Mervs111/Line-Follower-Racer/docs/charter.md

# PROJECT CHARTER — Robot Line Tracer Micro

Semester Gasal 2026/2027 · Revisi 3.4 (arahan dosen 05/10/2026: reverse engineering, path planning,
budget maksimal Rp 900.000, dinaikkan menjadi Rp 1.000.000 pada 26/10/2026; arahan 09/10/2026: tanpa IMU; arahan 26/10/2026: path planning dengan peta yang ditentukan di awal) · diperbarui 22/10/2026: 12 QRE1113GR (toko lokal), PCB sensor bentuk jangkar · RAB 27/10/2026: harga hasil validasi marketplace

## 1. Project Identity

| | |
|---|---|
| Nama | Robot Line Tracer Micro |
| Short Description | Robot line tracer edukasi untuk anak sekolah, hasil reverse engineering kit Ichiduino Pro, yang mampu mengikuti garis secara otomatis dan menjalankan path planning dengan peta yang ditentukan di awal (pre-defined map by index). Berbasis ESP32, dapat diprogram dengan block coding berbasis web, dan dibangun dengan anggaran maksimal Rp 1.000.000. |
| Supervisor | Fira Aulia, S.Tr.T, M.Tr.T |

| No | Nama | NRP | Peran |
|---|---|---|---|
| 1 | Mararevi Subagyo | 2040241036 | Project Manager, [isi peran] |
| 2 | Fernandy Raditya Wardhana | 2040241007 | [isi peran] |
| 3 | Achmad Iqbal Adiputra | 2040241121 | [isi peran] |
| 4 | Adhityanoval Dewa Mahendra | 2040241085 | [isi peran] |

Pilihan peran: Firmware, Kendali & Path Planning · Elektronik & PCB · Mekanik & Pengujian ·
Platform Web, RAB & Dokumentasi.

## 2. Business Reasons for Project

Robot line tracer edukasi di pasaran lokal, seperti Ichiduino Pro, dijual sekitar Rp 2.000.000 per kit
lengkap dengan unit kontrol (Ultimate 5 Max) seharga Rp 825.000, dan ditujukan untuk kompetisi.
Harga dan fiturnya (kecepatan tinggi, baterai LiPo 2S) kurang sesuai sebagai media belajar anak sekolah.

Proyek ini melakukan reverse engineering terhadap Ichiduino Pro: fungsi dan arsitekturnya dianalisis,
lalu dirancang ulang dari nol dengan anggaran maksimal Rp 1.000.000. Fitur yang dipertahankan, diganti,
atau ditiadakan dipilih berdasarkan kebutuhan edukasi dan batas anggaran. Selain mengikuti garis,
robot memiliki kemampuan path planning dengan peta yang ditentukan di awal (pre-defined map by index):
rute dituliskan sebagai urutan indeks, dan tiap indeks berisi pola sensor pemicu (misalnya persimpangan
kiri, kanan, atau perempatan), aksi (maju, belok kiri, belok kanan), dan perintah mengikuti garis
berikutnya. Pada lintasan grid, urutan indeks dapat dibuat otomatis dari rute terpendek menuju titik
tujuan, sehingga siswa dapat belajar konsep algoritma dan navigasi melalui block coding berbasis web tanpa
instalasi aplikasi.

## 3. Project Objectives / Purposes

1. Melakukan reverse engineering kit Ichiduino Pro dan merancang ulang robot line tracer edukasi
   berbasis ESP32 dengan anggaran maksimal Rp 1.000.000.
2. Membuat robot yang mampu mengikuti garis hitam di atas putih secara otomatis dengan kendali PID,
   dengan akurasi pembacaan posisi garis ≤ 2 mm dan kecepatan rata-rata ≥ 0,5 m/s.
3. Menerapkan path planning dengan peta yang ditentukan di awal (pre-defined map by index): rute
   dituliskan sebagai urutan indeks; pada tiap indeks robot menunggu pola sensor pemicu, menjalankan aksi
   (maju, belok kiri, belok kanan, berhenti) dengan jarak dan sudut dari encoder, lalu kembali mengikuti
   garis. Pada lintasan grid, urutan indeks dapat dihitung otomatis sebagai rute terpendek menuju titik
   tujuan.
4. Menerapkan fitur keamanan berupa berhenti ≤ 500 ms setelah garis tidak terdeteksi dan pemutusan
   saat tegangan baterai < 3,2 V per sel.
5. Mengembangkan platform block coding berbasis web (Blockly), termasuk blok aksi per indeks dan blok rute
   terpendek menuju titik tujuan.
6. Menguji performa, keterulangan gerak, dan path planning robot, serta melakukan uji coba kepada
   siswa sekolah.

## 4. Project Scope

**Yang dikerjakan:**

- Reverse engineering kit Ichiduino Pro (analisis fungsi, arsitektur, dan spesifikasi)
- Robot line tracer edukasi berbasis ESP32, dirancang dari nol
- Elektronik: 12 sensor garis QRE1113GR (PCB sensor bentuk jangkar) + multiplexer, motor DC + encoder, driver motor, OLED, catu daya baterai 2S (2× 18650)
- Firmware: baca sensor, kalibrasi, kendali PID, deteksi persimpangan, fitur keamanan
- Path planning: peta by index (urutan langkah pola sensor → aksi → ikuti garis) dan pembuatan urutan indeks
  otomatis dari rute terpendek pada lintasan grid
- Platform block coding berbasis web (Blockly)
- Prototipe sampai desain PCB yang siap diproduksi
- Uji performa robot, uji path planning, dan uji coba ke pengguna (anak sekolah)

**Yang TIDAK dikerjakan:**

- Produksi massal dan penjualan (baru rencana bisnis)
- Lintasan selain garis hitam di atas putih
- Rute terpendek otomatis pada lintasan selain grid bersudut 90° (pada lintasan lain, rencana per indeks tetap disusun
  manual lewat blok; garis yang berbelok dan melengkung tetap dapat diikuti)
- Pemetaan lintasan secara otonom (robot menjelajah sendiri); peta ditentukan di awal sesuai arahan dosen
  26/10/2026
- Penghindaran halangan / obstacle avoidance (bukan kebutuhan line tracer)
- Upload program lewat Bluetooth dan dukungan iPad/Safari (jadi pengembangan lanjutan)
- Fitur lomba, seperti kecepatan tinggi dan kipas penyedot
- Modifikasi kit Ichiduino Pro (kit hanya dianalisis dan diukur sebagai pembanding)

## 5. Key Project Deliverables

| Nama | Deskripsi |
|---|---|
| Analisis Reverse Engineering | Tabel analisis fungsi, arsitektur, dan spesifikasi Ichiduino Pro beserta keputusan fitur yang dipertahankan, diganti, atau ditiadakan |
| Prototipe | Robot Line Tracer Micro yang dapat mengikuti garis dan menjalankan path planning |
| Desain PCB | File skematik dan layout PCB (papan utama dan papan sensor) yang siap diproduksi |
| Firmware | Program pembacaan sensor, kendali PID, deteksi persimpangan, path planning, dan fitur keamanan |
| Platform Block Coding | Aplikasi web berbasis Blockly untuk memprogram robot tanpa menulis kode |
| Lintasan Uji | Lintasan garis lurus dan lintasan grid 4 × 4 persimpangan |
| Data Pengujian | Hasil uji seluruh sasaran dan uji coba kepada siswa |
| Dokumentasi | Dokumentasi kegiatan kelompok minggu 4–16 selama proses pengerjaan proyek PJBL |
| Laporan Mingguan | Laporan mingguan berisi aktivitas, perkembangan, dan kendala selama proses PJBL |
| Laporan Akhir & Manual | Laporan menyeluruh mengenai proses, solusi, dan hasil PJBL, beserta manual pengguna |

## 6. Project's Criteria for Success

Lintasan uji path planning berupa grid garis 4 × 4 titik persimpangan dengan jarak antar titik 30 cm.

1. **Akurasi pembacaan posisi garis ≤ 2 mm.** Diuji dengan meletakkan robot dalam keadaan diam (motor mati) pada posisi geser −20 s.d. +20 mm (tiap 5 mm) dari tengah garis, lalu posisi yang terbaca sensor dibandingkan dengan posisi sebenarnya, 3 kali ulangan. Alat ukur: kertas milimeter dan jangka sorong.
2. **Kecepatan rata-rata robot ≥ 0,5 m/s.** Dihitung dari panjang lintasan dibagi waktu tempuh, 3 kali ulangan. Alat ukur: meteran dan stopwatch/video.
3. **Keterulangan waktu tempuh dengan simpangan baku ≤ 5%.** Robot dijalankan 10 putaran pada lintasan dan kondisi baterai yang sama. Alat ukur: stopwatch/timer firmware.
4. **Deteksi persimpangan benar ≥ 95%.** Robot melewati minimal 40 persimpangan, lalu catatan deteksi robot dibandingkan dengan jumlah persimpangan sebenarnya. Alat ukur: log serial dan video.
5. **Path planning dengan peta indeks benar pada 10 dari 10 percobaan.** Diuji pada 10 pasang titik awal dan tujuan yang berbeda; robot harus menjalankan seluruh aksi indeks tanpa salah belok, dan rute yang dihitung otomatis dibandingkan dengan rute terpendek hasil hitung manual. Alat ukur: log serial dan video.
6. **Ketepatan berhenti di titik tujuan dengan error ≤ 30 mm.** Jarak pusat robot ke titik tujuan diukur setelah robot berhenti, pada 10 rute di poin 5. Alat ukur: penggaris/meteran.
7. **Robot berhenti ≤ 500 ms setelah garis tidak terdeteksi.** Garis diputus, lalu waktu dihitung dari rekaman video slow-motion, 3 kali ulangan. Alat ukur: video HP 240 fps.
8. **Motor mati saat tegangan baterai < 3,2 V per sel.** Baterai diganti power supply, lalu tegangan diturunkan perlahan dan dicatat saat motor mati, 3 kali ulangan. Alat ukur: power supply dan multimeter.
9. **Total biaya proyek ≤ Rp 1.000.000.** Dihitung dari jumlah RAB, dan setiap harga disertai tautan toko. Alat ukur: daftar harga.
10. **Seluruh proses dan hasil pengujian terdokumentasi** dalam laporan mingguan dan laporan akhir PJBL.

## 7. Milestone Dates

| No | Milestones / Major Events | Due Dates |
|---|---|---|
| 1 | Lembar telaah, Project Charter, dan sasaran terukur (G1 Penetapan) | Minggu 1–2 |
| 2 | Reverse engineering Ichiduino Pro, WBS, jadwal, RAB, rumusan optimasi | Minggu 3–5 |
| 3 | Rancangan teknis: arsitektur, wiring, flowchart, skematik, algoritma path planning, pustaka (G2 Rancangan) | Minggu 3–6 |
| 4 | Analisis bahaya (≥ 8 mode kegagalan) | Minggu 7–8 |
| 5 | Prototipe mengikuti garis + deteksi persimpangan, data awal 3 ulangan, demo progres (G3 Realisasi Awal) | Minggu 7–10 |
| 6 | Path planning, PCB, platform block coding, pengujian seluruh sasaran, uji coba siswa (G4 Pembuktian) | Minggu 11–14 |
| 7 | Laporan akhir, manual, serah terima, demo akhir (G5 Serah Terima) | Minggu 15–16 |

**Risiko terbesar:** pembacaan sensor garis terganggu cahaya ruangan dan kondisi permukaan lintasan,
sehingga posisi garis dan persimpangan tidak terbaca akurat.

| No | Risiko | Dampak | Penanganan |
|---|---|---|---|
| R1 | Sensor garis terganggu cahaya ruangan / permukaan lintasan | Akurasi posisi dan deteksi persimpangan gagal | Kalibrasi hitam-putih tiap dinyalakan; sensor QRE1113GR (LED IR + fototransistor dalam satu kemasan bersekat) dipasang rendah, muka sensor ±3 mm dari lantai; pelindung cahaya 3D print ditambah kalau uji di ruangan terang gagal |
| R2 | Persimpangan terlewat atau terdeteksi ganda | Rute dan titik berhenti salah | Konfirmasi deteksi dengan jarak tempuh encoder |
| R3 | Belokan 90° di persimpangan tidak presisi | Rute dan titik berhenti salah | Belok berbasis encoder, lalu dikunci kembali ke garis oleh sensor |
| R4 | PID tidak stabil saat kecepatan/tegangan baterai berubah | Kecepatan dan keterulangan gagal | Tuning lewat serial, kompensasi tegangan baterai |
| R5 | PCB salah desain atau terlambat datang | Jadwal G3–G4 mundur | Prototipe breadboard dulu, pesan PCB paling lambat minggu 10 |
| R6 | Biaya melebihi Rp 1.000.000 | Sasaran biaya gagal | RAB dipantau tiap pembelian |
| R7 | Baterai Li-ion overcharge / overdischarge / korsleting | Bahaya keselamatan | BMS 2S, cutoff firmware, ruang baterai tertutup |
| R8 | QRE1113GR mahal (Rp15.000/pcs di toko lokal) sehingga dibeli 12 tanpa cadangan; sensor rusak saat disolder atau barang palsu | Satu titik sensor mati, posisi garis kurang presisi | Cek tanda pin 1 dan uji tiap sensor di breadboard (LED IR dilihat lewat kamera HP) sebelum disolder; kalau ada yang rusak, beli satuan di toko yang sama |

## 8. Budget Summary

Harga dari marketplace online (Shopee/Tokopedia), sudah divalidasi kelompok pada 27/10/2026 (spreadsheet RAB PJBL P01).
Tautan toko ada di bawah tabel. Item tanpa tautan (fabrikasi PCB, komponen pendukung, roda, ball caster, baut, timah)
masih perkiraan. Kit Ichiduino Pro tidak dianggarkan ulang.

### Electrical

| Item | Price per unit | Qty | Unit | Total Price |
|---|---|---|---|---|
| ESP32 DevKit WiFi Bluetooth CH340 Type-C | Rp65.900 | 1 | pcs | Rp65.900 |
| OLED 0.96" 128×64 I2C | Rp36.500 | 1 | pcs | Rp36.500 |
| Sensor reflektif QRE1113GR SMD (tanpa cadangan) | Rp15.000 | 12 | pcs | Rp180.000 |
| IC multiplexer analog CD74HC4067M SOP-24 (SOIC), 16 kanal (dipakai 12), WKH Electronic (tanpa cadangan) | Rp20.000 | 1 | pcs | Rp20.000 |
| Modul driver motor TB6612FNG | Rp50.000 | 1 | pcs | Rp50.000 |
| Motor N20 6V 500 RPM + encoder | Rp55.000 | 2 | pcs | Rp110.000 |
| Push button tactile 12×12 mm | Rp1.000 | 3 | pcs | Rp3.000 |
| Resistor SMD 0805 (220 Ω dan 10 kΩ untuk PCB sensor) | Rp100 | 30 | pcs | Rp3.000 |
| Buzzer aktif 12 × 9,5 mm | Rp3.000 | 1 | pcs | Rp3.000 |
| Baterai Li-ion 18650 3000 mAh (1 paket isi 2) | Rp94.990 | 1 | paket | Rp94.990 |
| Holder baterai 2× 18650 (seri) | Rp8.000 | 1 | pcs | Rp8.000 |
| Modul BMS 2S | Rp10.000 | 1 | pcs | Rp10.000 |
| Modul charger 2S USB-C | Rp25.000 | 1 | pcs | Rp25.000 |
| Modul buck converter 5 V (MP1584) | Rp10.000 | 1 | pcs | Rp10.000 |
| Saklar on/off | Rp3.000 | 1 | pcs | Rp3.000 |
| Konektor JST XH 6 pin + header (motor encoder) | Rp5.000 | 2 | set | Rp10.000 |
| Konektor JST XH 2,5 mm 8 pin (2 header + 2 housing + terminal) + kabel | Rp5.000 | 1 | set | Rp5.000 |
| Fabrikasi PCB (papan utama + papan sensor) + ongkir | Rp200.000 | 1 | paket | Rp200.000 |
| Komponen pendukung minsys (header & socket female, kapasitor, dioda 1N5819, resistor THT) | Rp25.000 | 1 | paket | Rp25.000 |
| **TOTAL** | | | | **Rp862.390** |

### Mechanical

| Item | Price per unit | Qty | Unit | Total Price |
|---|---|---|---|---|
| Roda N20 Ø34 mm | Rp25.000 | 1 | pasang | Rp25.000 |
| Ball caster | Rp10.000 | 1 | pcs | Rp10.000 |
| Baut, mur, spacer | Rp15.000 | 1 | paket | Rp15.000 |
| **TOTAL** | | | | **Rp50.000** |

### Lain-lain

| Item | Price per unit | Qty | Unit | Total Price |
|---|---|---|---|---|
| Timah solder + flux | Rp25.000 | 1 | paket | Rp25.000 |
| **TOTAL** | | | | **Rp25.000** |

**TOTAL BUDGET: Rp937.390** (Electrical Rp862.390 + Mechanical Rp50.000 + Lain-lain Rp25.000), **sisa Rp62.610
dari batas Rp1.000.000** (batas anggaran dinaikkan dari Rp900.000 menjadi Rp1.000.000 pada 26/10/2026). Lintasan uji
disediakan di luar RAB; breadboard + kabel jumper dipinjam dari lab. Revisi 13/10/2026: 16 sensor +
multiplexer + LED indikator (+Rp63.000). Revisi 15/10/2026: sensor jadi 12 TCRT5000, LED IR selalu nyala tanpa MOSFET (−Rp16.500).
Revisi 20/10/2026: sensor jadi 12 pasang LED merah + fototransistor SMD 1206, MCP23017 + LED indikator dihapus
(bacaan sensor tampil di OLED), OLED 0,96", skid nilon pengganti ball caster (−Rp20.000). Revisi kedua 20/10/2026:
sensor jadi 12 QRE1113GR, PCB sensor bentuk sayap gaya JSumo XLINE (+Rp7.500). Revisi 21/10/2026: multiplexer
berupa IC CD74HC4067 SOIC-24 yang disolder langsung di PCB sensor, bukan modul (lebih hemat tempat, +Rp20.000);
tempat cetak sanggup jalur 0,3 mm. Revisi 22/10/2026: PCB sensor bentuk jangkar (rev B); QRE1113GR ternyata ada di
toko lokal dengan harga Rp15.000/pcs (sebelumnya perkiraan impor Rp5.000), jadi dibeli 12 tanpa cadangan
(+Rp105.000); kabel pita IDC diganti konektor JST XH 8 pin (−Rp5.000, perkiraan); breadboard dan timah dipinjam
dari lab (−Rp85.000). Revisi 26/10/2026: IC mux CD74HC4067M SOP-24 dari toko WKH Electronic Rp20.000 (sebelumnya
perkiraan Rp35.000), dibeli 1 tanpa cadangan (−Rp15.000). Revisi 27/10/2026: harga hasil validasi di marketplace
online: ESP32 Rp65.900 (−Rp10.100), OLED Rp36.500 (+Rp3.500), TB6612FNG Rp50.000 (+Rp25.000), baterai 18650 1 paket
isi 2 Rp94.990 (+Rp14.990); push button jadi 3 pcs tactile 12×12 mm (−Rp1.000); resistor THT masuk paket komponen
pendukung (−Rp2.000); bracket motor dihapus karena dudukan motor dibuat 3D print (−Rp10.000); ball caster
menggantikan skid nilon (+Rp5.000); timah solder + flux masuk RAB (+Rp25.000); konektor motor jadi JST XH 6 pin
(harga sama). Total +Rp50.390. Akibatnya footprint tombol dan konektor motor di PCB utama perlu disesuaikan.

### Tautan toko (dicek 27/10/2026)

| Item | Toko | Tautan |
|---|---|---|
| ESP32 DevKit (pilih varian CH340, Type-C, 30 pin) | Shopee | [produk](https://shopee.co.id/ESP32-ESP-32-WROOM-WIFI-Bluetooth-CP2102-CH340-30-38-Pin-BLE-IOT-Develompent-Board-ESP-32S-Micro-USB-Type-C-Solder-i.70136393.57406160712) |
| OLED 0,96" I2C (kuning-biru) | cncstorebandung (Tokopedia) | [produk](https://www.tokopedia.com/cncstorebandung/cnc-yellow-blue-0-96-i2c-128x64-oled-lcd-display-module) |
| QRE1113GR | Shopee | [produk](https://shopee.co.id/product/12793026/28316976609) |
| CD74HC4067M SOP-24 | WKH Electronic (Tokopedia) | menyusul |
| TB6612FNG | Shopee | [produk](https://shopee.co.id/Modul-Driver-Motor-Dual-TB6612FNG-i.116951623.49164769328) |
| Motor N20 + encoder, varian MTR-0239 (6 V 500 RPM; torsi rated 0,2 kg·cm, rasio 30:1) | cncstorebandung (Tokopedia) | [produk](https://www.tokopedia.com/cncstorebandung/motor-dc-jga12-n20-3v-6v-micro-gearbox-high-torque-encoder-untuk-robot-arduino-diy-1731127914696705598) |
| Push button TC-1212T 12×12×5 mm | cncstorebandung (Tokopedia) | [produk](https://www.tokopedia.com/cncstorebandung/cnc-tactile-switch-push-button-tc-1212t-12x12x5-mm-for-arduino-1733707899505378878) |
| Resistor SMD 0805 220 Ω dan 10 kΩ | mikro-automasi (Tokopedia) | [produk](https://www.tokopedia.com/mikro-automasi/resistor-smd-0805-220r-220-dan-10k-10-k-ohm-1-1-8-w-10k-393a6) |
| Buzzer aktif 12 × 9,5 mm | cncstorebandung (Tokopedia) | [produk](https://www.tokopedia.com/cncstorebandung/buzzer-speaker-active-3v-5v-12x9-5mm-modul-alarm-suara-mini-for-arduino-esp32-uno-mega-nano-diy-elektronik-project-17331031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) |
| Baterai 18650 3000 mAh (isi 2) | kanbaigadget (Tokopedia) | [produk](https://www.tokopedia.com/kanbaigadget/smartoools-18650-li-ion-3-7v-3000mah-battery-1-pack-2pcs-1729383030075721073) |
| Holder 2× 18650 | cncstorebandung (Tokopedia) | [produk](https://www.tokopedia.com/cncstorebandung/cnc-tempat-baterai-18650-holder-batteray-18650-case-baterry-18650-2) |
| BMS 2S | supreme (Tokopedia) | [produk](https://www.tokopedia.com/supreme/2s-7-4v-li-ion-lithium-18650-bms-battery-charger-module-8-4v-16a) |
| Charger 2S USB-C | cncstorebandung (Tokopedia) | [produk](https://www.tokopedia.com/cncstorebandung/charger-bms-2s-3s-4s-4a-module-step-up-type-c-input-dc-3-7-6v-bms-2s-3d675) |
| Buck MP1584 | easyware-id (Tokopedia) | [produk](https://www.tokopedia.com/easyware-id/mp1584-3a-dc-dc-step-down-buck-converter-module-adjustable-3-3v-5v-9v-12v-1735712197220599327-1735712260417160735) |
| Saklar on/off | bbelektronik-1 (Tokopedia) | [produk](https://www.tokopedia.com/bbelektronik-1/saklar-on-off-kecil-2-pin-1731781398715729555) |
| JST XH 6 pin (motor) | pcmelektrobik (Tokopedia) | [produk](https://www.tokopedia.com/pcmelektrobik/konektor-xh-6pin-2-54-jst-6-pin-pcb-connector-header-plug-xh2-54mm-6p-1729834630991284132) |
| JST XH 8 pin | s3-satriasecure (Tokopedia) | [produk](https://www.tokopedia.com/s3-satriasecure/molex-mini-8pin-2-54-molek-2-54mm-header-8-pin-jst-xh-2-54-mm-soket-8p-terminal-8p-8-pin-konektor-connector-8-p-kaki-8pin-k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) |

### Alasan pemilihan komponen utama

- **ESP32 DevKit** (Rp65.900): prosesor 240 MHz dual-core dengan WiFi/Bluetooth, jauh lebih murah dari
  ESP32-S3 (> Rp130.000). 12 sensor garis dibaca bergantian lewat multiplexer CD74HC4067 ke satu kanal
  ADC1 (GPIO36), tegangan baterai ke kanal ADC1 lain (GPIO39).
- **12 sensor garis QRE1113GR pada PCB bentuk jangkar (jarak antar sensor 8 mm di busur, lebar baca
  ± 83 mm)**: 6 sensor tengah hampir lurus (posisi presisi dan deteksi persimpangan), lalu lengan melengkung
  ke belakang sampai sensor terluar mundur ± 11,6 mm, sehingga belokan tajam terlihat lebih awal. Jarak 8 mm
  dipilih untuk garis lomba 2 cm (IARC XII): kedua tepi garis bergantian melewati sensor, bacaan posisi halus.
  QRE1113GR berisi LED IR dan
  fototransistor dalam satu kemasan SMD kecil (2,9 × 3,6 mm) yang sudah bersekat, jadi PCB sensor tipis dan
  rendah (muka sensor ± 3 mm dari lantai) seperti kit pembanding, dan tidak perlu menata pasangan LED +
  fototransistor sendiri. Multiplexer membuat 12 sensor cukup memakai 5 pin ESP32 (1 ADC + 4 pemilih kanal). Bacaan 12 sensor
  ditampilkan sebagai bar di OLED, menggantikan LED indikator + MCP23017 (lebih murah dan PCB sensor lebih
  sederhana). Tangkai PCB sensor dibaut ke bawah PCB utama dengan 2 spacer nilon dan disambung kabel JST XH
  8 pin pendek.
- **Motor N20 6V 500 RPM + encoder, roda Ø34 mm**: kecepatan maksimum teoritis ± 0,89 m/s, cukup untuk
  sasaran ≥ 0,5 m/s dengan cadangan; roda kecil membuat robot rendah dan ringkas. Torsi desain
  (massa 0,3 kg, akselerasi 1,8 m/s², safety factor 2) ± 9 N·mm ≈ 0,09 kg·cm per roda. Encoder dibutuhkan
  untuk membaca kecepatan roda (CPMK-1) dan belokan 90° yang presisi untuk path planning: sudut belok
  dihitung dari selisih putaran roda kiri dan kanan, lalu robot dikunci kembali ke garis oleh sensor
  (tanpa IMU, sesuai arahan dosen 09/10/2026). PWM dibatasi ± 70% agar motor 6V tidak kelebihan
  tegangan dari baterai 2S.
- **TB6612FNG**: penurunan tegangan jauh lebih kecil daripada L298N, sehingga motor mendapat tenaga
  penuh dari baterai 2S dan driver tidak panas.
- **Baterai 2× 18650 (2S) + BMS + charger USB-C**: 7,4 V cukup untuk motor dan buck 5 V; kapasitas besar
  (± 3 jam pemakaian), arus maksimum tinggi, dan tidak mungkin tertukar dengan baterai AA; holder dipasang
  melintang di atas PCB utama; dilindungi BMS dan diisi lewat USB-C.

## Persetujuan

Ditandatangani Pengawas PJBL (Fira Aulia, S.Tr.T, M.Tr.T), Manajer Proyek (Mararevi Subagyo), dan
seluruh anggota (Fernandy Raditya Wardhana, Achmad Iqbal Adiputra, Adhityanoval Dewa Mahendra).
