Mervs111/Line-Follower-Racer/mechanical/konsep-v17/konsep-v17.html

# Konsep LFM v17: PCB ringkas + board interface

Sasis diganti skid plate 3D print, jadi PCB utama cukup seukuran modulnya. Board interface (OLED + 5 tombol 6×6) ditumpuk di atasnya, di depan baterai. Motor, roda, baterai di atas poros, dan PCB sensor rev B tidak berubah. Semua gambar to-scale (mm).

Cek otomatis: 0 masalah

Sekarang (v16): PCB utama = sasis, 127 × 100 mm

Usulan (v17): PCB utama trapesium sejajar skid plate, 4 lubang baut M3 di sayap

Usulan (v17): board interface 46 × 32 mm ditumpuk di atas PCB utama

PCB utama board interface komponen pendek di bawah ESP32 zona antena (tanpa tembaga) holder baterai di atas charger di skid plate (di bawah dudukan) skid plate 3D print

## Persegi vs trapesium (trapesium dipilih 03/11)

| Persegi (konsep awal) | Trapesium (dipilih)
Ukuran | 62 × 58 mm | depan 62, belakang 87, panjang 58 mm
Luas PCB | 35,8 cm² | 42,9 cm² (+20%)
Kotak pembungkus (p × l) | 36,0 cm² | 50,2 cm² (+40%)
Total dengan interface | 50,5 cm² (-47% dari v16) | 57,6 cm² (-40% dari v16)

- Kelebihan: garis PCB menyatu dengan skid plate. Sayap kiri-kanan kosong, jadi 4 lubang baut M3 bisa ditaruh jauh dari komponen dan PCB lebih kokoh di skid plate. Masih ada ruang untuk label silkscreen dan titik ukur (test point).
- Kekurangan: luas naik. Kalau tempat cetak menghitung harga dari panjang × lebar, yang dihitung kotak pembungkusnya, jadi kenaikannya lebih besar. Sayap kiri ada di bawah colokan USB ESP32, jadi komponen di sana harus pendek.
- Tidak berubah: isi PCB, board interface, jarak ke ban (sudut belakang 7 mm di depan ban), cek tabrakan tetap 0.

Tampak samping v17 (dari kiri, depan ke kanan). Tinggi OLED ±46 mm, sejajar atas holder baterai.

## Angka

| v16 | Usulan v17
PCB utama | 127 × 100 mm, 95,3 cm² | trapesium depan 62, belakang 87, panjang 58 mm, 42,9 cm²
Board interface | tidak ada | 46 × 32 mm, 14,6 cm²
Total PCB utama + interface | 95,3 cm² | 57,6 cm² (-40%)
PCB sensor | 20,7 cm² | tetap
Sasis | PCB utama | skid plate 3D print trapesium: depan 62 mm, belakang 115 mm, coakan roda
Ban | Ø34 × 12 mm di model (roda Ø34 N20 di toko umumnya 6,5–7 mm) | Ø34 × 18 mm, melebar ke luar
Lebar robot / jarak tengah ban | 103 mm / 91 mm | 115 mm / 97 mm (batas lomba 200 mm)
Tombol | 2 × 12×12 mm (GPIO34, GPIO35) | 5 × 6×6 mm, resistor ladder di GPIO34 (GPIO35 bebas)
Charger 2S + BMS | di PCB utama bagian belakang | charger di skid plate (di bawah dudukan baterai), BMS ditempel di holder

## Susunan

- PCB utama trapesium, sisi sejajar skid plate, 4 lubang M3 di sayap: belakang J2, J1 baterai, J3, R1/R2, D1; tengah ESP32 DevKit melintang di socket (USB ke kiri, antena ke kanan); depan MP1584, C1, buzzer, SW1 (tuas ke kanan), header J6 ke board interface, J5 ke PCB sensor (kabel lurus ke depan).
- Ban lebih lebar (18 mm, melebar ke luar karena sisi dalam ada motor): kecepatan maksimum tetap, karena ditentukan RPM × diameter. Grip naik, jadi akselerasi dan pengereman lebih jarang selip. Jarak tengah ban naik 91 → 97 mm (lebih stabil, PID perlu dituning ulang). Skid plate berbentuk trapesium: sisi lurus dari hidung (62 mm) melebar ke belakang sampai sisi luar ban (115 mm), dengan coakan roda (celah ke ban ±4 mm). Ban menonjol keluar dari garis miring seperti mobil balap.
- Ball caster pindah ke skid plate tepat di belakang PCB sensor (y ±72 mm dari poros). Di v16 caster masih di baut PCB sensor dan bertabrakan dengan PCB sensor (celah ke lantai cuma 4,8 mm).
- Di bawah ESP32 (celah socket 8,5 mm): TB6612 disolder rendah tanpa socket (disetujui 03/11), Q1 + R3/R4 buzzer.
- Board interface: OLED di socket di tengah, 5 tombol 6×6 mengapit untuk menu OLED (kiri ▲ ▼ pindah pilihan, kanan ◀ kembali, OK, ▶ lanjut/ubah nilai), resistor ladder di bawah OLED. Ke PCB utama lewat J6 6 pin: 3V3, GND, SDA, SCL, tombol (GPIO34), cadangan.
- Charger 2S pindah ke skid plate di belakang motor, di bawah dudukan baterai, USB-C menghadap ke belakang. BMS (tanpa konektor) ditempel di holder baterai. Keduanya tidak lagi di PCB.

## Perlu dicek / diputuskan

1. Sisi bawah ESP32 DevKit yang dibeli: kalau ada chip (CH340 di bawah), celah untuk TB6612 tinggal ±1 mm.
2. Ukuran modul charger 2S yang dibeli: konsep memakai 25 × 16 mm dengan USB-C di sisi panjang (seperti model v16).
3. Harga cetak: 3 desain PCB (sensor, utama, interface); tanya apakah bisa digabung satu panel.
4. Roda velg 3D print Ø34 × 18 mm (dipilih 03/11; roda N20 Ø34 di toko hanya 6,5–7 mm): bahan ban (TPU, silikon cetak, atau karet) dan apakah printer lab bisa mencetak TPU.

## Hasil cek otomatis (kotak 3D tiap komponen)

- 0 tabrakan antar komponen, semua komponen di dalam outline, jalur USB dan zona antena kosong.
