Mervs111/Line-Follower-Racer/mechanical/v16/dxf/pcb_sensor_posisi_qre1113.csv

no | x_mm | y_mm_dari_tepi_depan | putar_deg_kicad
1 | -41.39 | 16.28 | -140.0
2 | -35.26 | 11.14 | -147.5
3 | -28.01 | 7.76 | -161.5
4 | -20.19 | 6.09 | -171.5
5 | -12.22 | 5.40 | -175.0
6 | -4.25 | 4.70 | -177.5
7 | 4.25 | 4.70 | +177.5
8 | 12.22 | 5.40 | +175.0
9 | 20.19 | 6.09 | +171.5
10 | 28.01 | 7.76 | +161.5
11 | 35.26 | 11.14 | +147.5
12 | 41.39 | 16.28 | +140.0
