Mervs111/Line-Follower-Racer/mechanical/v15/dxf/pcb_sensor_posisi_qre1113.csv

no | x_mm | y_mm | putar_deg_dilihat_dari_atas
1 | -45.88 | 19.50 | +30
2 | -38.09 | 15.00 | +30
3 | -30.29 | 10.50 | +30
4 | -22.50 | 6.00 | +15
5 | -13.50 | 6.00 | +0
6 | -4.50 | 6.00 | +0
7 | 4.50 | 6.00 | +0
8 | 13.50 | 6.00 | +0
9 | 22.50 | 6.00 | -15
10 | 30.29 | 10.50 | -30
11 | 38.09 | 15.00 | -30
12 | 45.88 | 19.50 | -30
