Mervs111/Line-Follower-Racer/arsip/hardware/render/pcb-sensor-atas-bawah.png

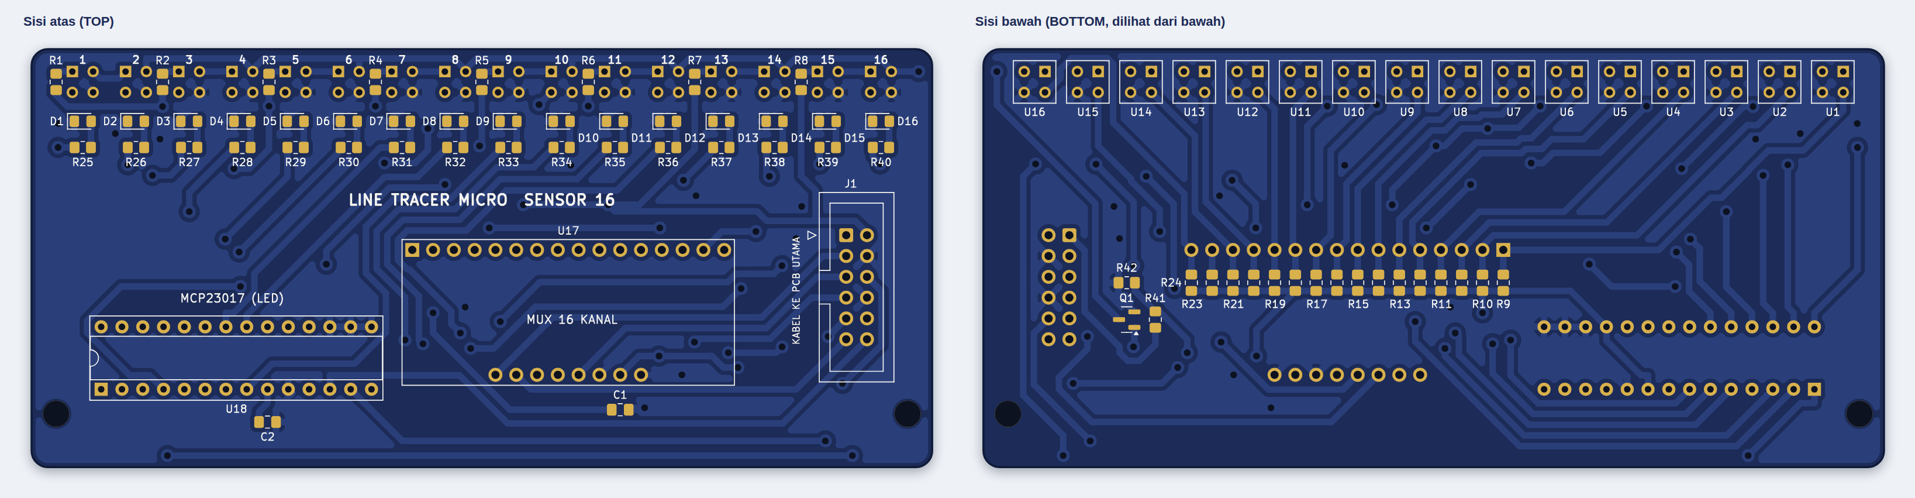
arsip/hardware/render/pcb-sensor-atas-bawah.png
