Mervs111/Line-Follower-Racer/arsip/mechanical/konsep-ringkas.png

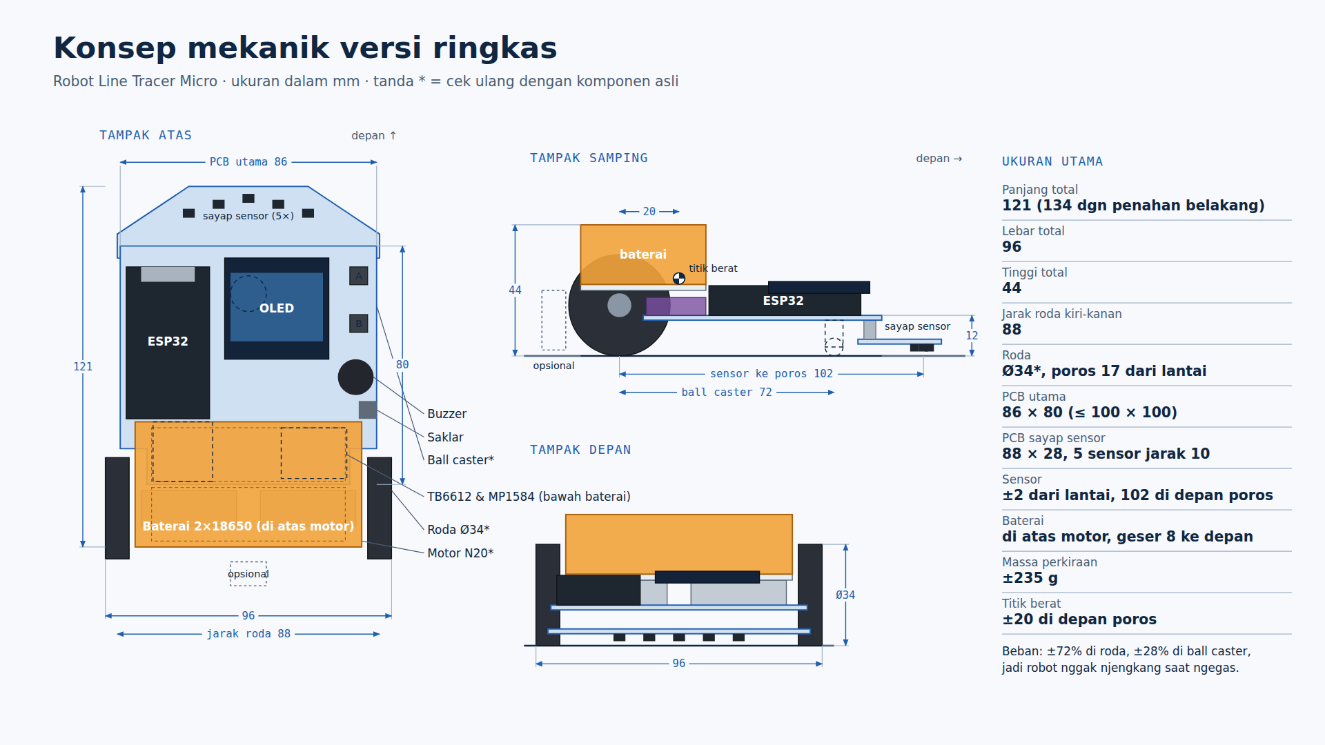
arsip/mechanical/konsep-ringkas.png
