Mervs111/Line-Follower-Racer/arsip/mechanical/render/ltm-v11-iso-nocover.png

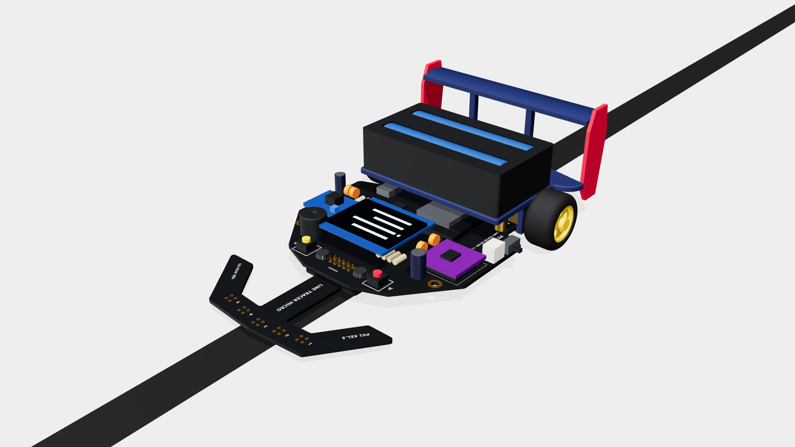
arsip/mechanical/render/ltm-v11-iso-nocover.png
