Mervs111/Line-Follower-Racer/arsip/mechanical/render/ltm-v11-rear.png

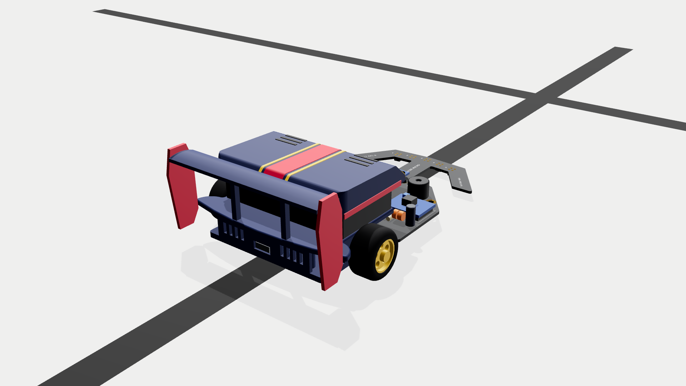
arsip/mechanical/render/ltm-v11-rear.png
