Mervs111/Line-Follower-Racer/arsip/mechanical/render/ltm-v11-top.png

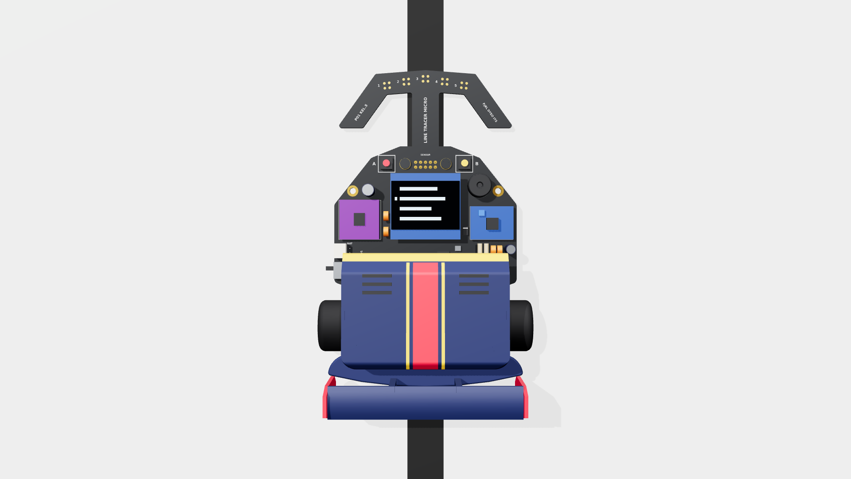
arsip/mechanical/render/ltm-v11-top.png
