Mervs111/Line-Follower-Racer/arsip/mechanical/render/ltm-v12-iso-nocover.png

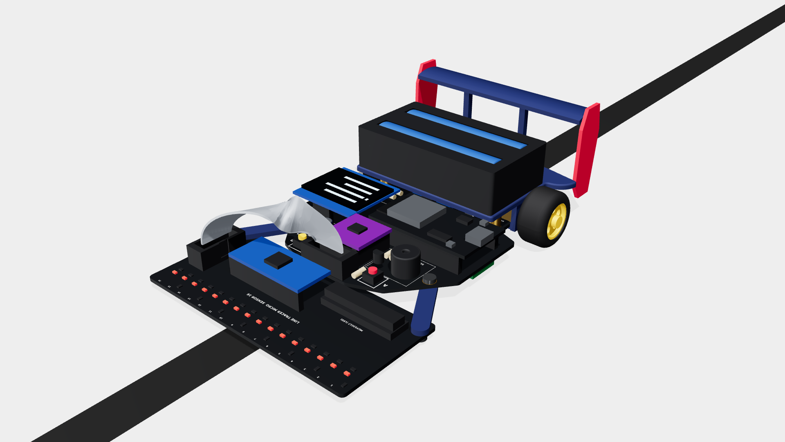
arsip/mechanical/render/ltm-v12-iso-nocover.png
