Mervs111/Line-Follower-Racer/arsip/mechanical/render/ltm-v13-banding-ichiduino.png

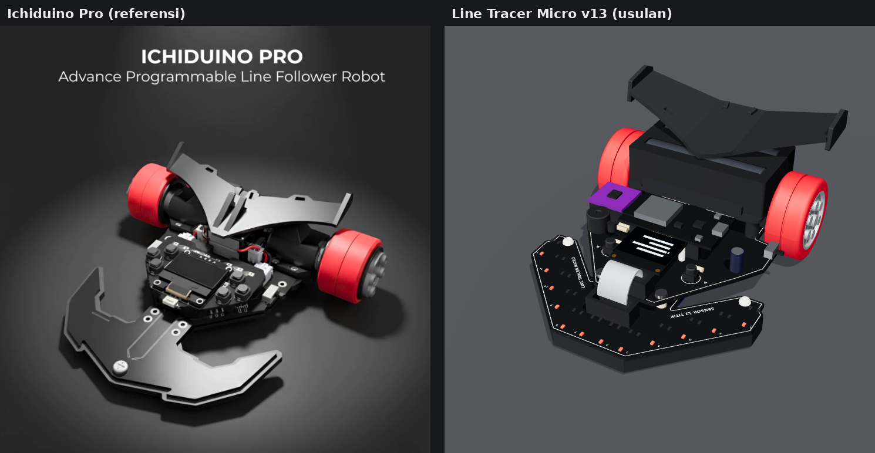
arsip/mechanical/render/ltm-v13-banding-ichiduino.png
