Mervs111/Line-Follower-Racer/arsip/mechanical/render/ltm-v13-bawah.png

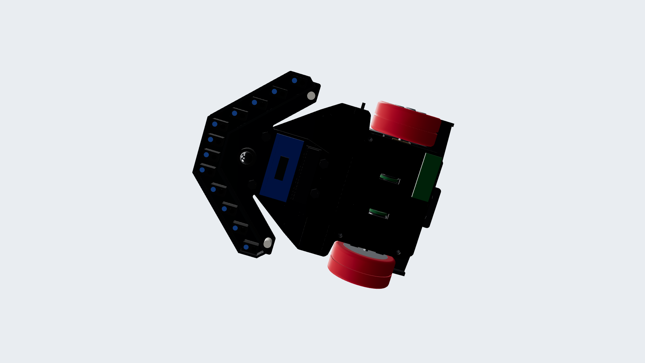
arsip/mechanical/render/ltm-v13-bawah.png
