Mervs111/Line-Follower-Racer/arsip/mechanical/render/ltm-v13-belakang.png

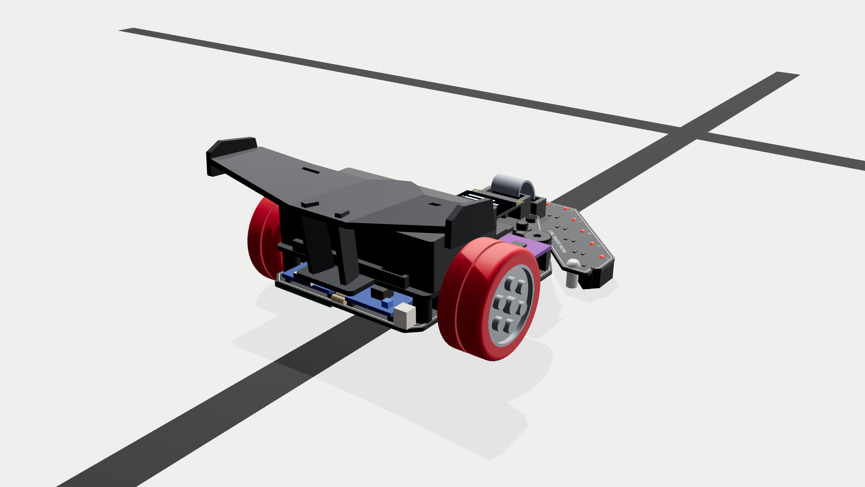
arsip/mechanical/render/ltm-v13-belakang.png
