Mervs111/Line-Follower-Racer/arsip/mechanical/render/ltm-v13-depan.png

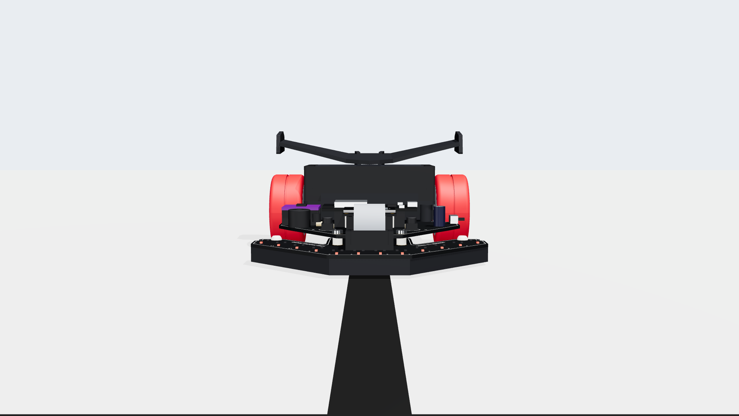
arsip/mechanical/render/ltm-v13-depan.png
