Mervs111/Line-Follower-Racer/arsip/mechanical/render/ltm-v13-iso-tanpa-pelindung.png

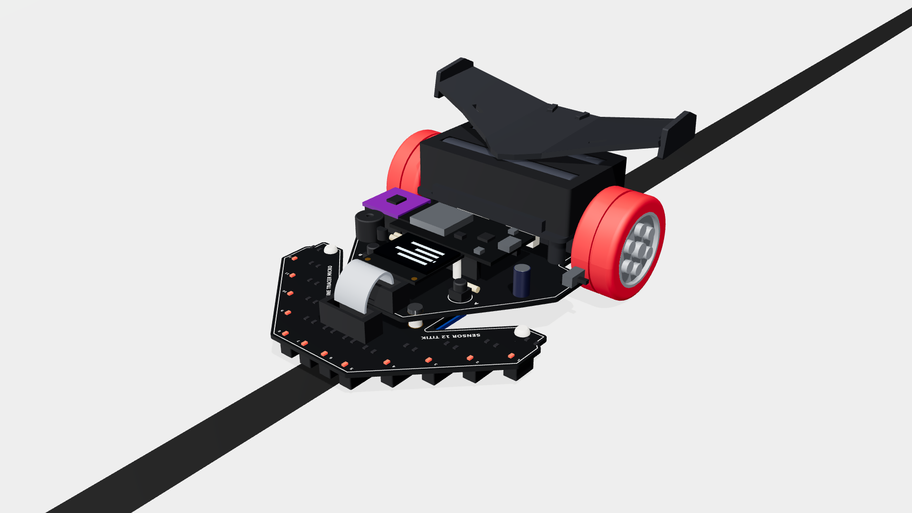
arsip/mechanical/render/ltm-v13-iso-tanpa-pelindung.png
