Mervs111/Line-Follower-Racer/docs/diagram-blok-kendali.png

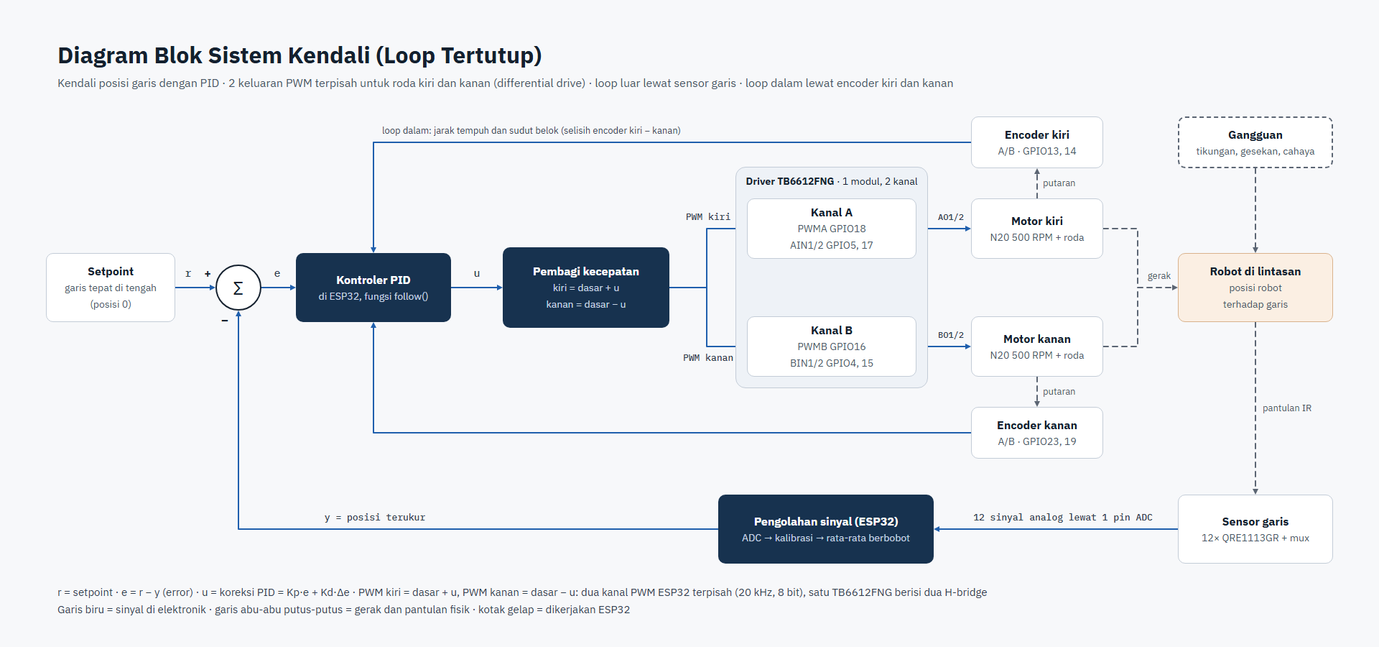
docs/diagram-blok-kendali.png
