Mervs111/Line-Follower-Racer/docs/diagram-blok.png

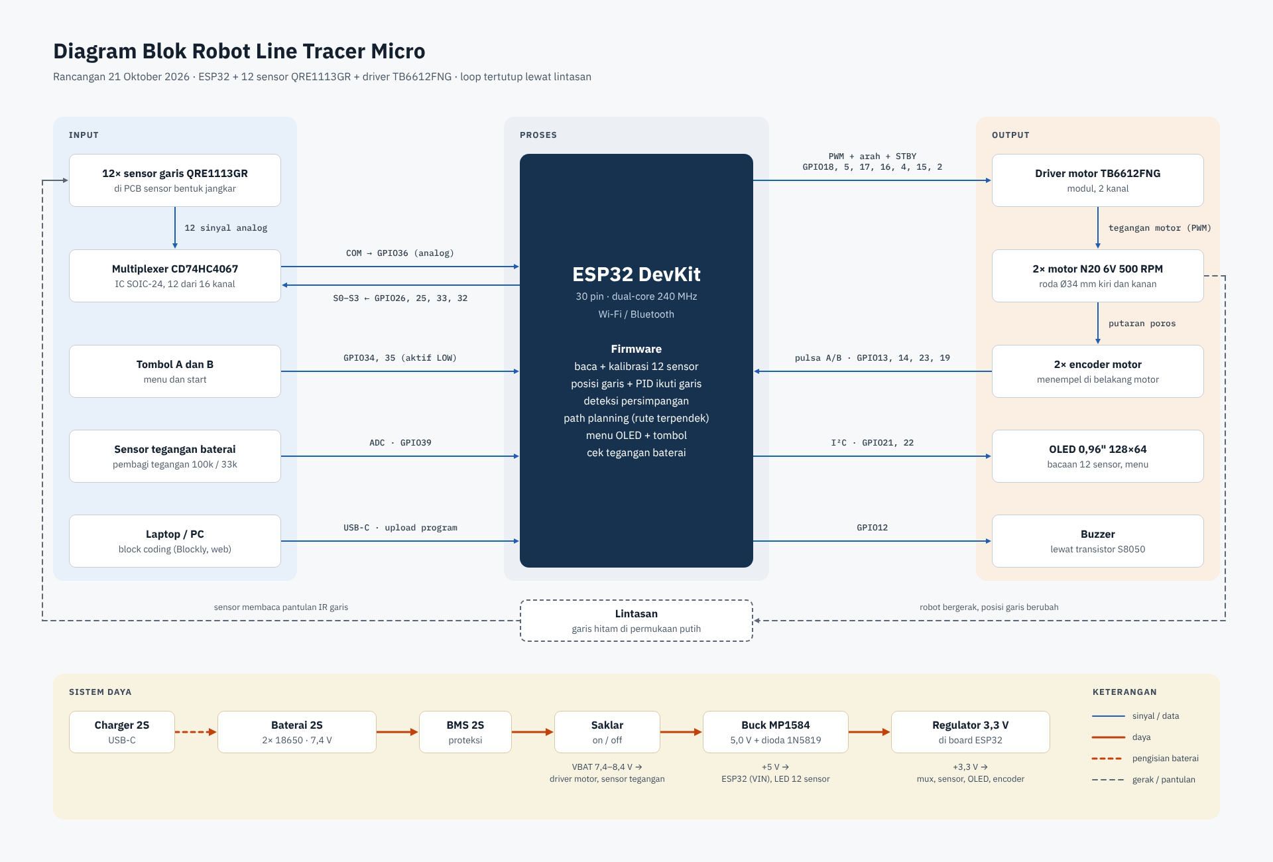
docs/diagram-blok.png
