Mervs111/Line-Follower-Racer/docs/pitching-rab/gambar/pcb-sensor-atas.png

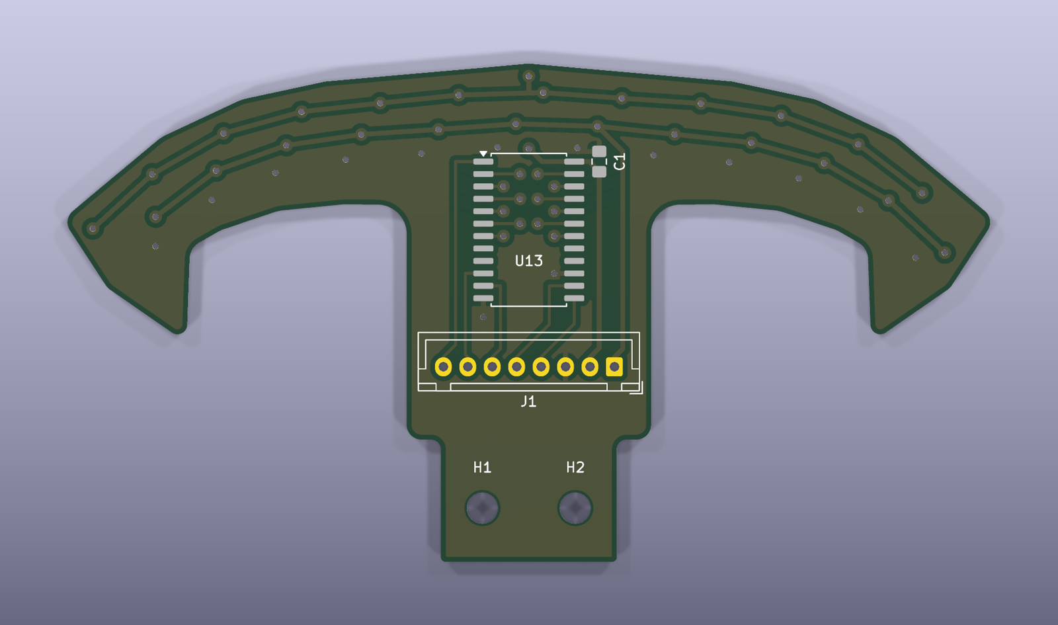
docs/pitching-rab/gambar/pcb-sensor-atas.png
