Mervs111/Line-Follower-Racer/docs/pitching-rab/gambar/pcb-utama-atas.png

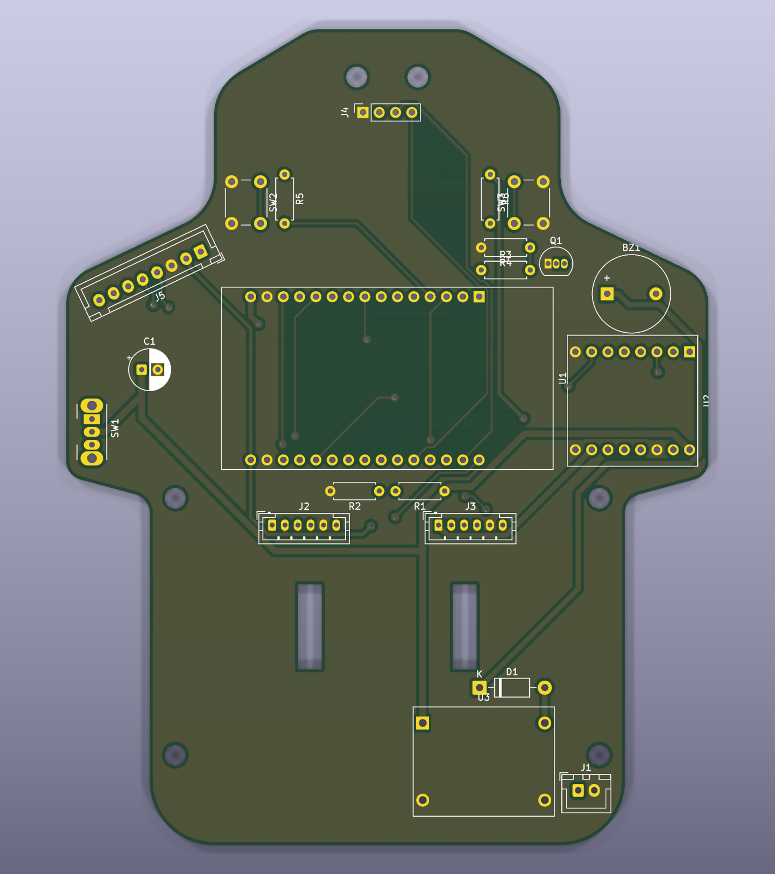
docs/pitching-rab/gambar/pcb-utama-atas.png
