Mervs111/Line-Follower-Racer/docs/pitching-rab/gambar/pcb-utama-iso.png

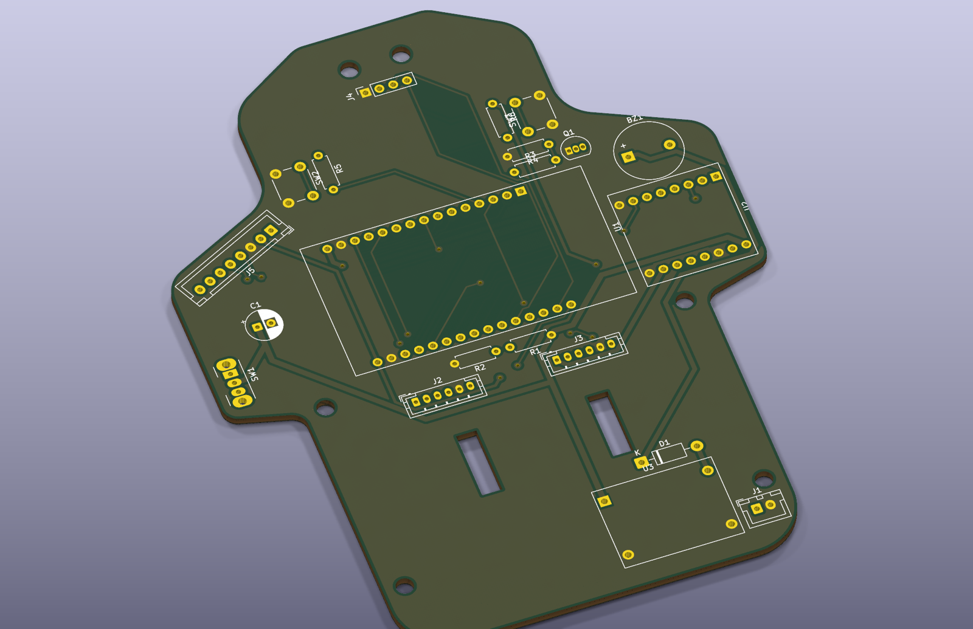
docs/pitching-rab/gambar/pcb-utama-iso.png
