Mervs111/Line-Follower-Racer/hardware/board-interface/render-atas.png

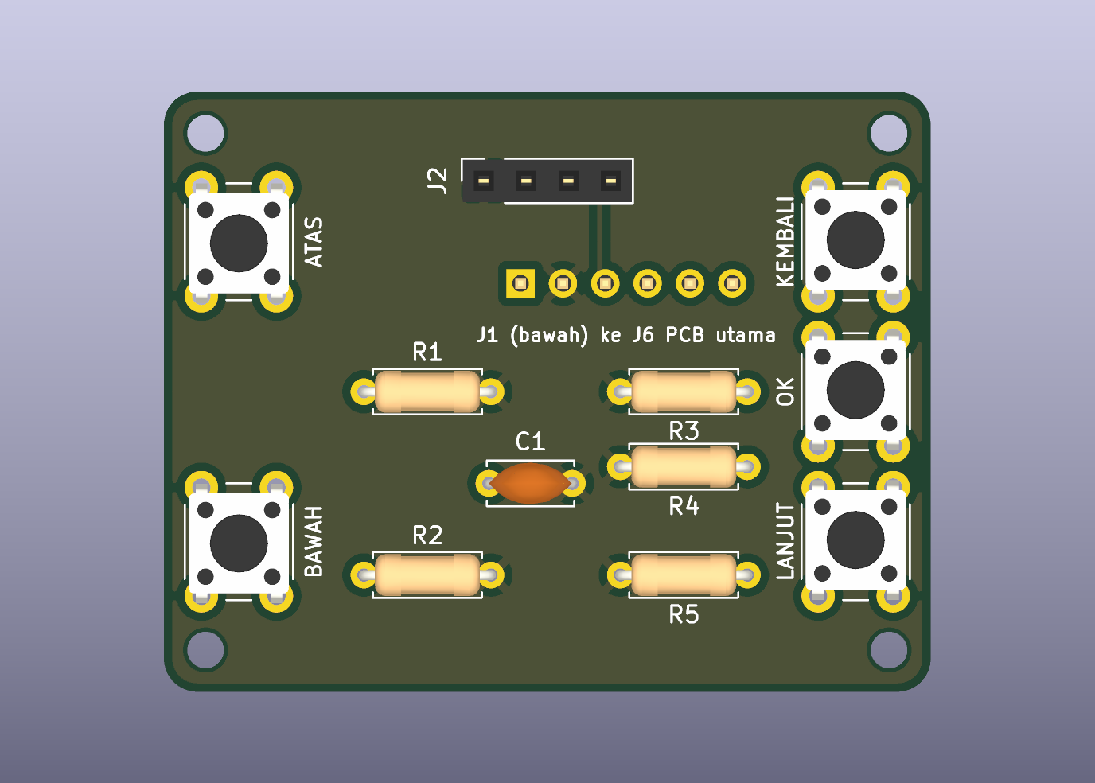
hardware/board-interface/render-atas.png
