Mervs111/Line-Follower-Racer/hardware/board-interface/render-bawah.png

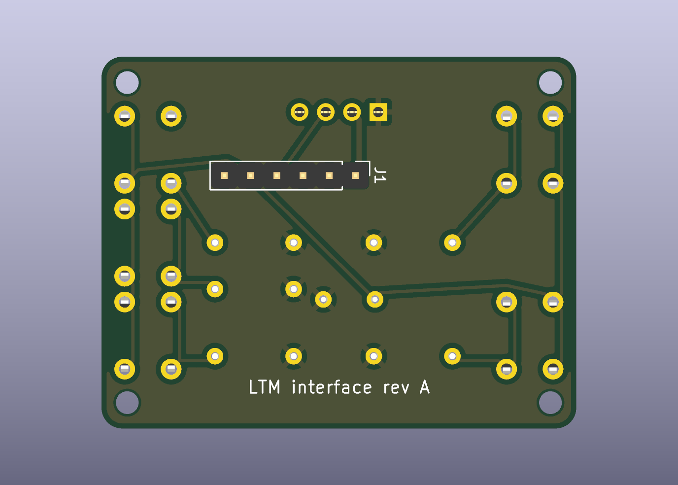
hardware/board-interface/render-bawah.png
