Mervs111/Line-Follower-Racer/hardware/outline/pcb_sensor_outline_simetris.png

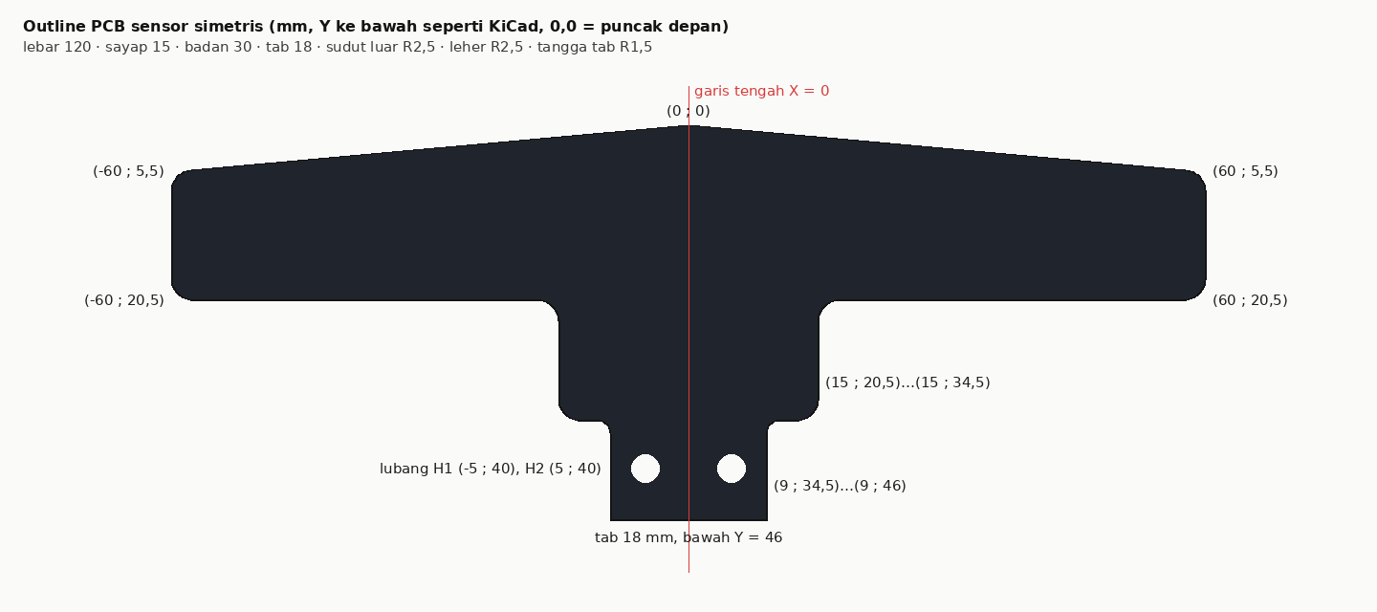
hardware/outline/pcb_sensor_outline_simetris.png
