Mervs111/Line-Follower-Racer/hardware/pcb-utama/render-atas.png

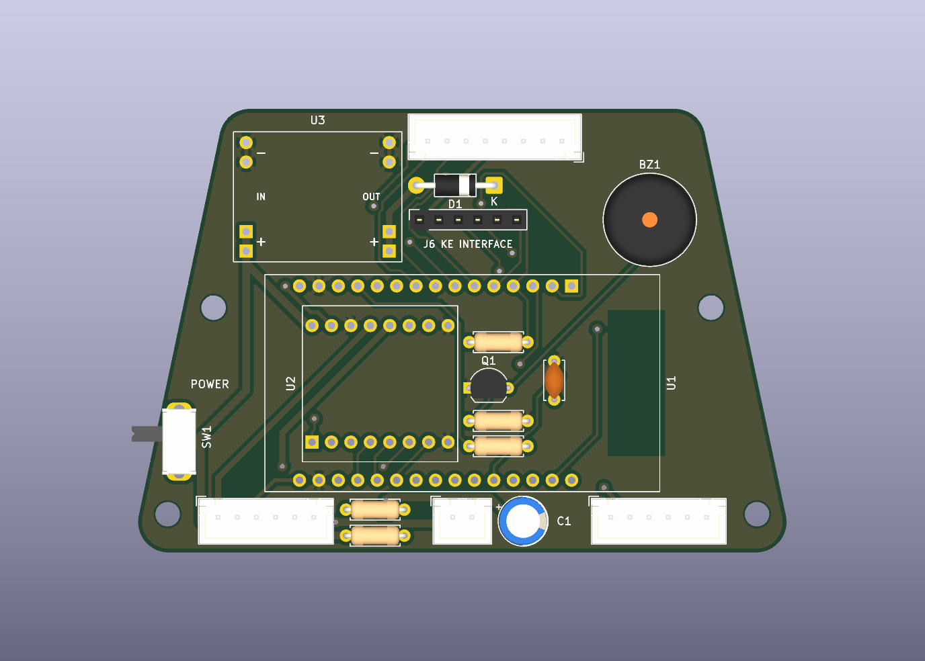
hardware/pcb-utama/render-atas.png
