Mervs111/Line-Follower-Racer/hardware/pcb-utama/render-bawah.png

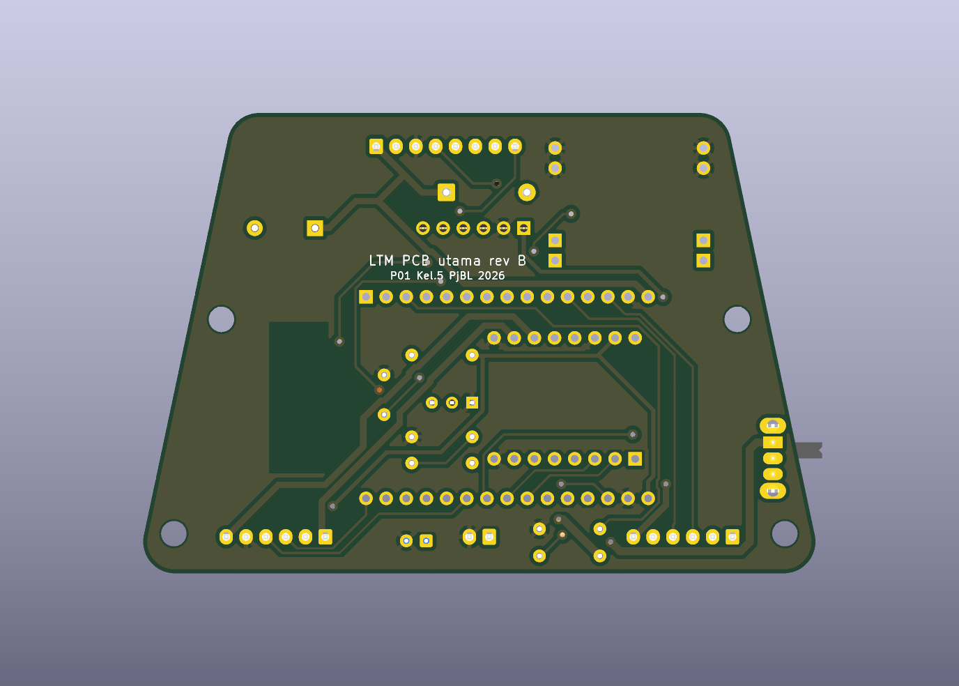
hardware/pcb-utama/render-bawah.png
