Mervs111/Line-Follower-Racer/hardware/render/pcb-rakitan-tampak-atas.png

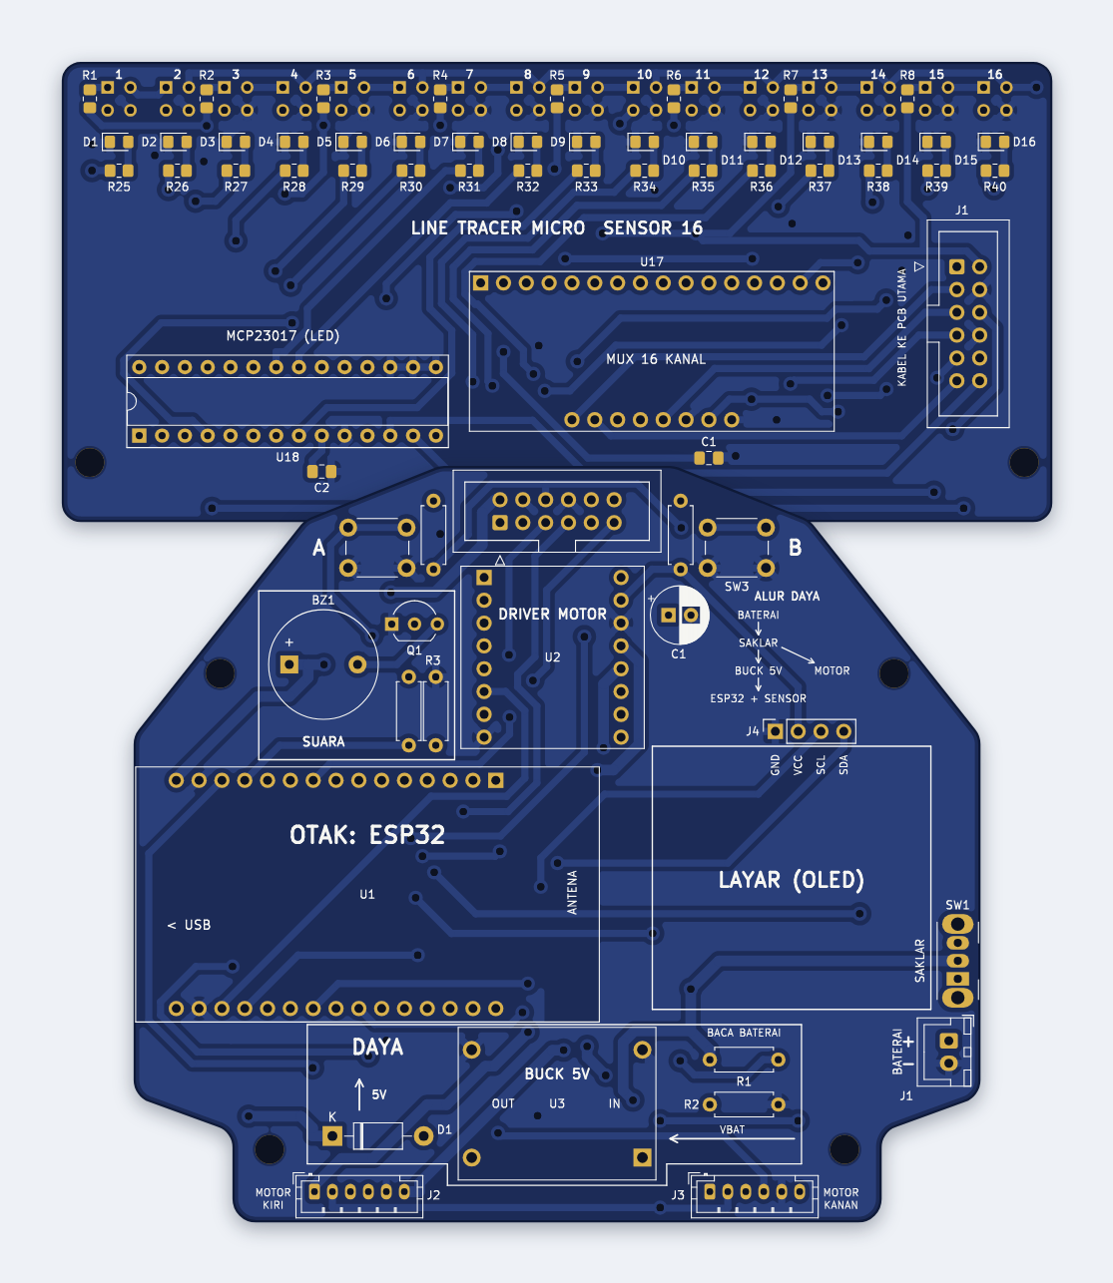
hardware/render/pcb-rakitan-tampak-atas.png
