Mervs111/Line-Follower-Racer/hardware/render/pcb-utama-atas-bawah.png

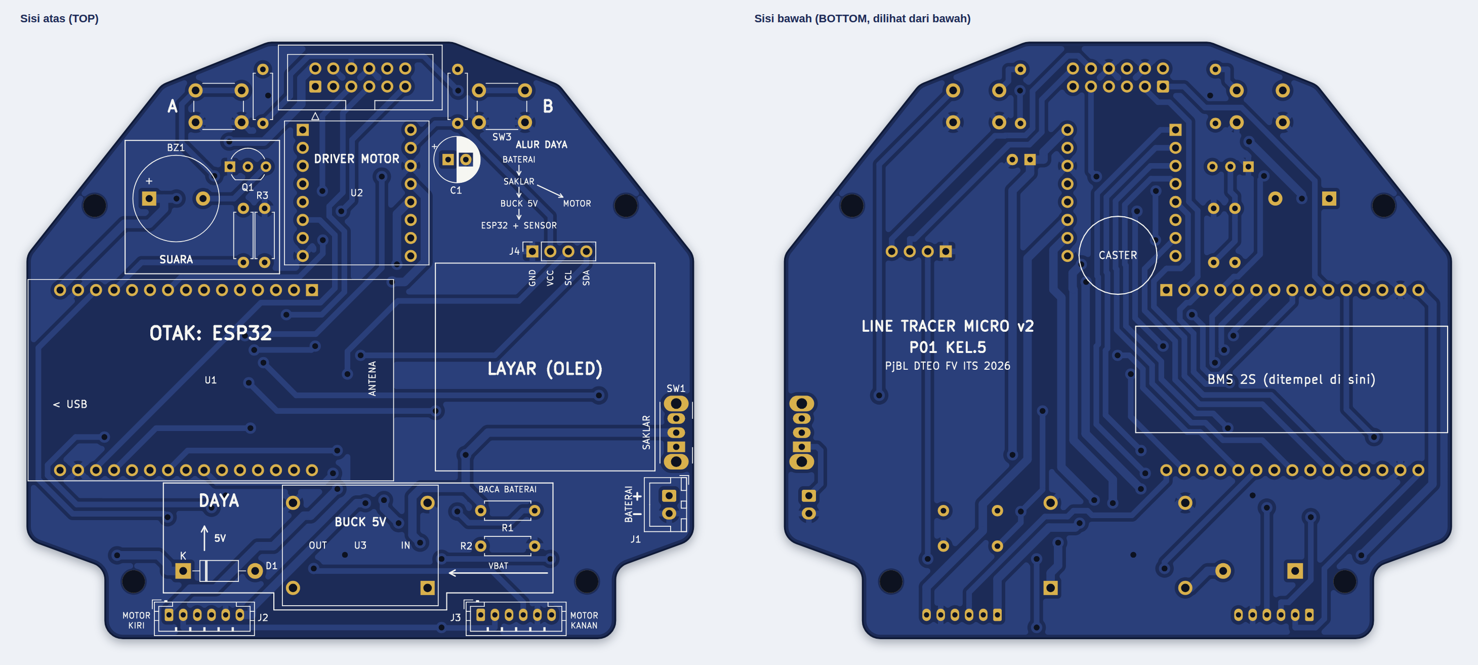
hardware/render/pcb-utama-atas-bawah.png
