Mervs111/Line-Follower-Racer/hardware/sensor-garis/revisi/rev-b/rev-b-3d-bawah.png

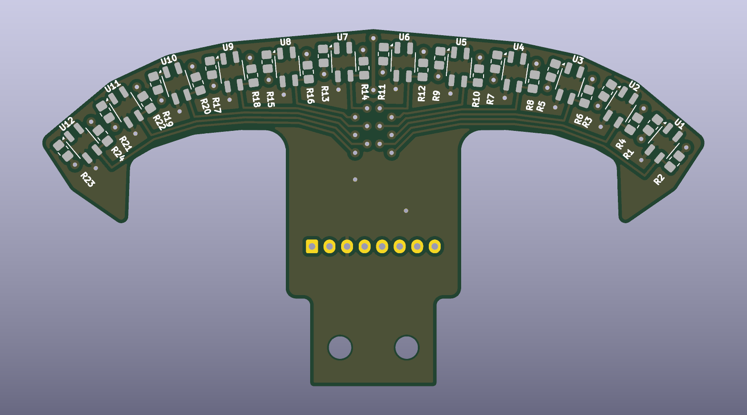
hardware/sensor-garis/revisi/rev-b/rev-b-3d-bawah.png
