Mervs111/Line-Follower-Racer/mechanical/render/ltm-v15-banding-xline.png

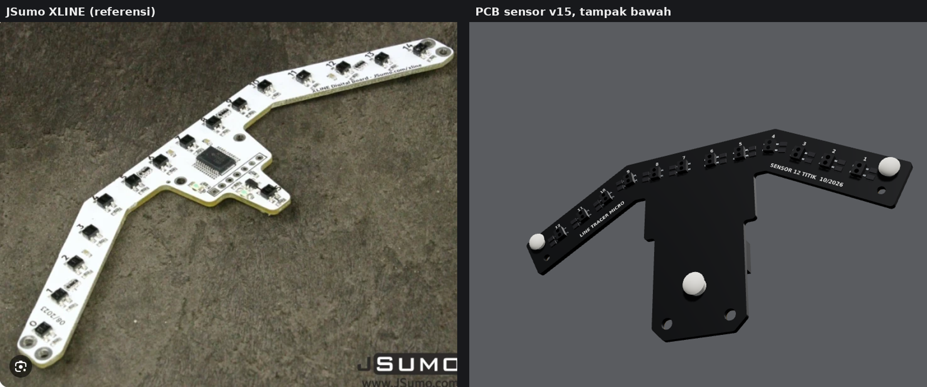
mechanical/render/ltm-v15-banding-xline.png
