Mervs111/Line-Follower-Racer/mechanical/render/ltm-v15-bawah.png

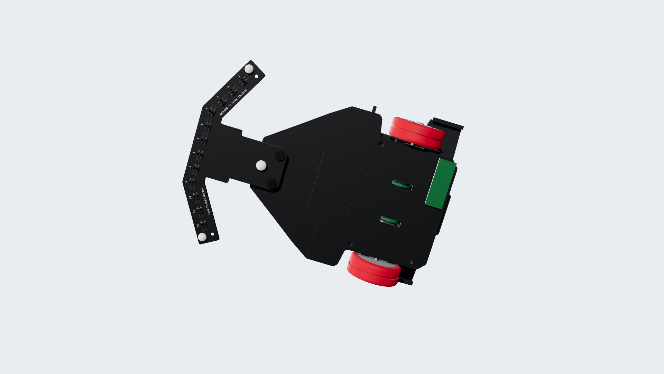
mechanical/render/ltm-v15-bawah.png
