Mervs111/Line-Follower-Racer/mechanical/render/ltm-v15-pcb-sensor-bawah.png

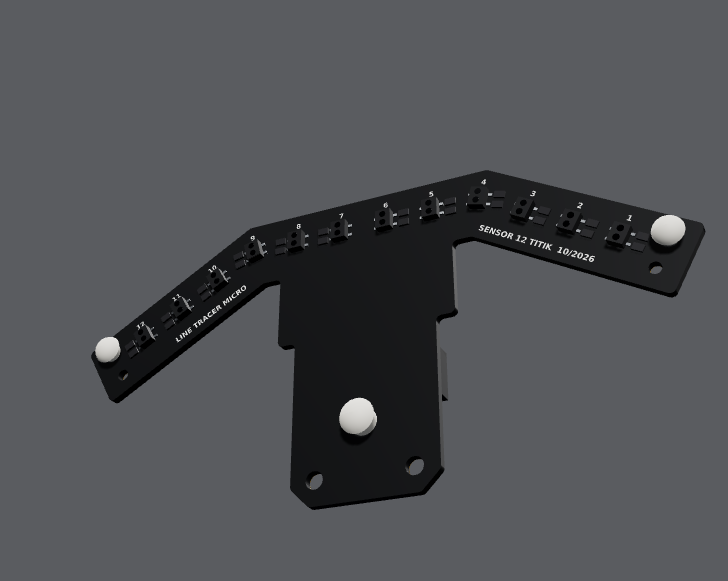
mechanical/render/ltm-v15-pcb-sensor-bawah.png
