Mervs111/Line-Follower-Racer/mechanical/render/ltm-v16-bawah.png

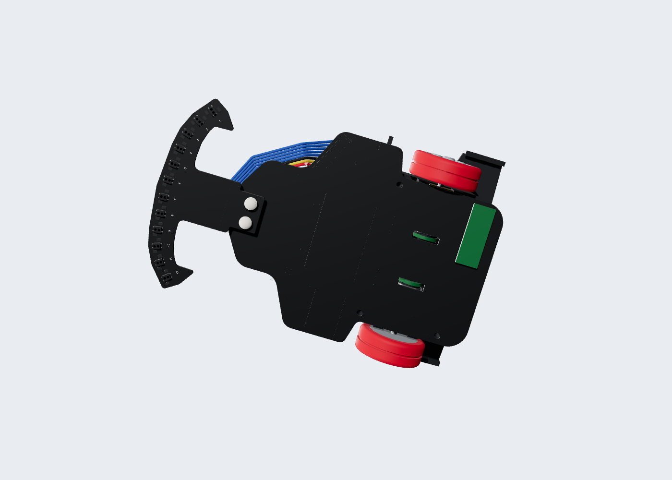
mechanical/render/ltm-v16-bawah.png
