Mervs111/Line-Follower-Racer/mechanical/render/ltm-v16-depan.png

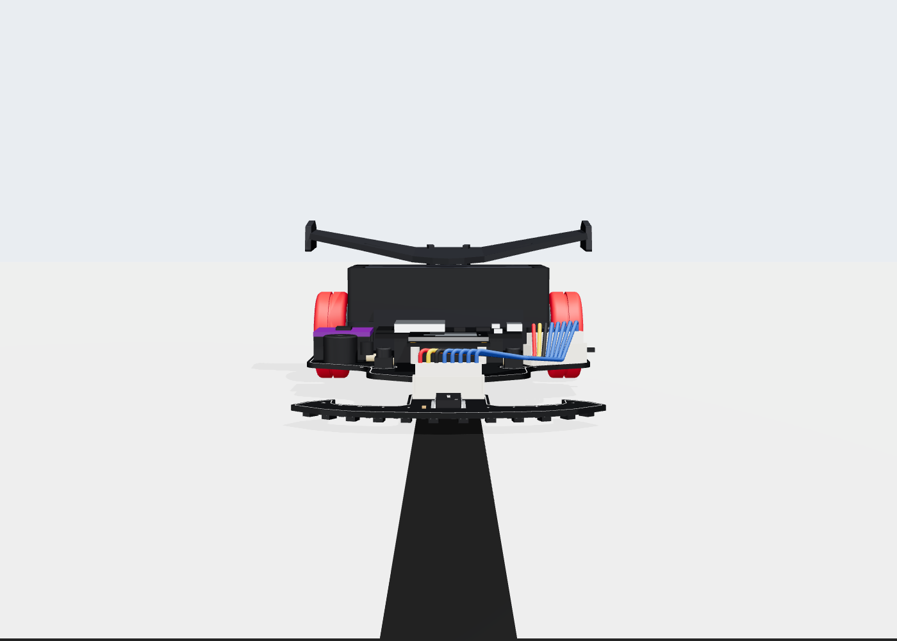
mechanical/render/ltm-v16-depan.png
