Mervs111/Line-Follower-Racer/simulasi/hasil/cek_kamera.png

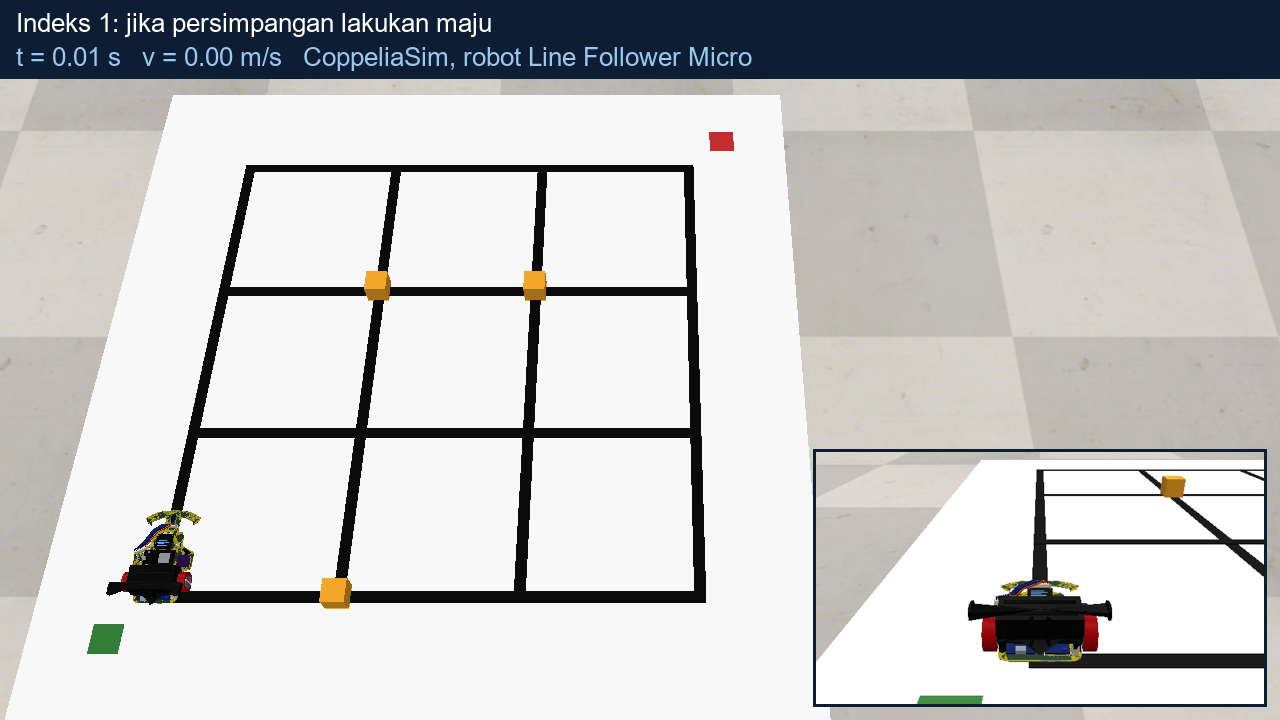
simulasi/hasil/cek_kamera.png
