Mervs111/Line-Follower-Racer/simulasi/hasil/coppeliasim_jendela.png

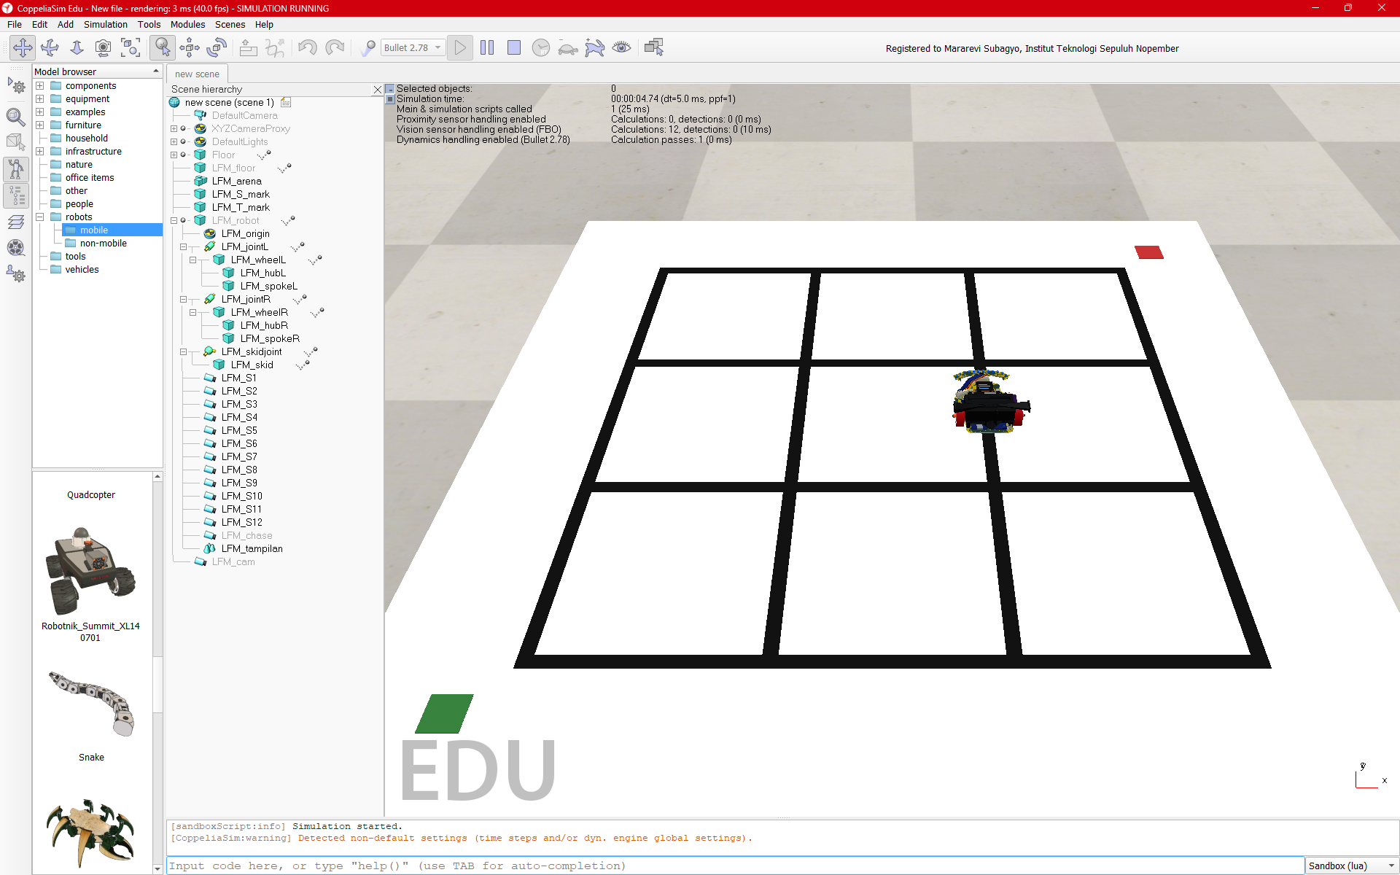
simulasi/hasil/coppeliasim_jendela.png
