Mervs111/Line-Follower-Racer/simulasi/hasil/uji2d_bfs.png

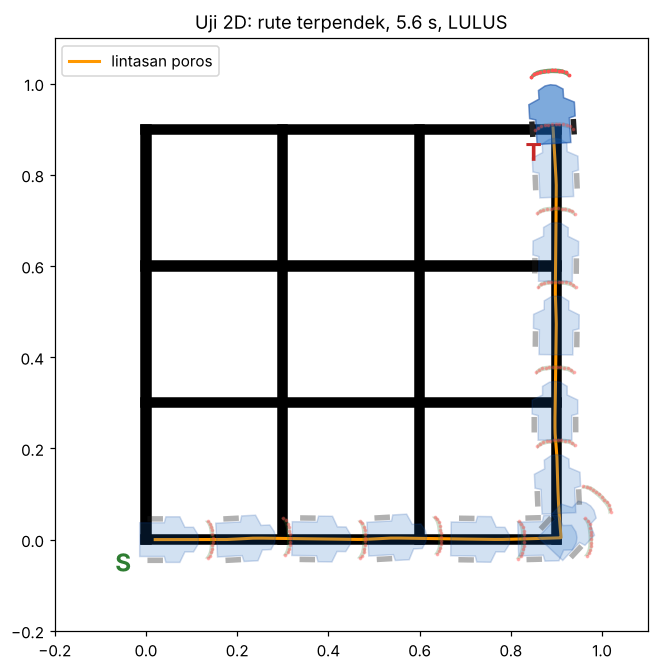
simulasi/hasil/uji2d_bfs.png
