Mervs111/Line-Follower-Racer/simulasi/hasil/uji2d_bfs_halangan.png

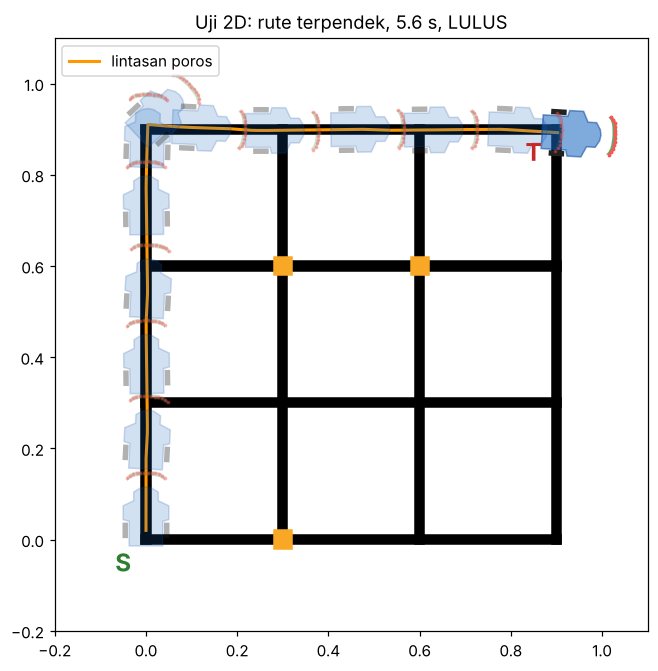
simulasi/hasil/uji2d_bfs_halangan.png
