Mervs111/Line-Follower-Racer/docs/RAB_Pemeliharaan_5_Tahun_LTM.xlsx

Sheet: Ringkasan
RENCANA ANGGARAN BIAYA (RAB) CAPEX & OPEX PEMELIHARAAN - 5 TAHUN
Sistem: armada AGV mini line tracer, 5 unit (4 beroperasi + 1 cadangan), hasil PjBL P01 Kelompok 5
Disusun oleh: Unit Maintenance | Diajukan kepada: Kepala Plant & Bagian Keuangan | Tugas Merancang RAB - Teknik Perawatan dan Perbaikan (B)
Harga dalam Rupiah. Angka tahun 2-5 sudah termasuk eskalasi harga. Detail perhitungan di sheet Asumsi, Jadwal PM, Suku Cadang, CAPEX, dan OPEX.
No | Pos anggaran | Tahun 1 | Tahun 2 | Tahun 3 | Tahun 4 | Tahun 5 | Total 5 tahun | % dari total
 | Tahun anggaran
A | CAPEX (pengadaan alat & stok awal)
A.1 | Peralatan kerja & alat ukur
A.2 | Infrastruktur perawatan
A.3 | Stok awal suku cadang kritis
A.4 | Pelatihan & dokumentasi awal
 | Subtotal CAPEX
B | OPEX (biaya pemeliharaan rutin)
B.1 | Suku cadang penggantian
B.2 | Bahan habis pakai
B.3 | Tenaga kerja pemeliharaan
B.4 | Kalibrasi alat ukur
B.5 | Pelatihan penyegaran
B.6 | Listrik pengisian baterai
B.7 | Kontingensi (persentase di sheet Asumsi)
 | Subtotal OPEX
 | TOTAL RAB (CAPEX + OPEX)
 | Kesesuaian dengan pagu
 | Pagu anggaran 5 tahun
 | Total RAB 5 tahun
 | Sisa pagu
 | Persentase pagu terpakai
 | Status
 | Indikator pemeliharaan
 | Rata-rata biaya pemeliharaan per robot per tahun (Rp)
 | Rata-rata biaya pemeliharaan per jam jalan robot (Rp/jam)
 | Jam teknisi preventif per tahun
 | Jam teknisi penggantian komponen per tahun
 | Porsi jam preventif dari total jam teknisi
 | Jumlah penggantian komponen per tahun (kejadian)
 | Biaya teknisi per jam (Rp)
 | Catatan
 | 1. Harga robot tidak termasuk: robot sudah terpasang dan beroperasi; RAB ini hanya biaya pemeliharaannya.
 | 2. CAPEX dibeli di tahun 1. Stok awal suku cadang kritis disimpan supaya robot rusak bisa langsung diperbaiki.
 | 3. Kebutuhan suku cadang dihitung dari jam jalan (motor, ban, caster), siklus baterai, dan laju kerusakan modul.
 | 4. Strategi: preventif terjadwal (sheet Jadwal PM) + penggantian berbasis kondisi dari hasil ukur baterai & RPM.
 | 5. Ubah asumsi di sheet Asumsi (sel kuning) bila data riwayat tahun pertama menunjukkan angka berbeda.

Sheet: Asumsi
Asumsi & Parameter Perhitungan
Sel biru berlatar kuning = asumsi yang boleh diubah. Semua angka di sheet lain dihitung ulang otomatis.
Sel hitam = rumus. Sel hijau = mengambil angka dari sheet lain.
No | Parameter | Nilai | Satuan | Sumber / dasar
A | Sistem & pola operasi
1 | Jumlah robot terpasang | 5 | unit | Skenario: armada AGV mini line tracer (hasil PjBL) pengantar part/kanban antar stasiun kerja; 4 unit jalan + 1 unit cadangan rotasi
2 | Robot beroperasi bersamaan | 4 | unit | Skenario: 1 unit selalu cadangan (dirotasi saat perawatan/pengisian)
3 | Jam operasi per hari | 8 | jam | Skenario: 1 shift
4 | Hari operasi per tahun | 300 | hari | Skenario: 6 hari kerja per minggu dikurangi libur nasional
5 | Utilisasi robot selama shift | 60.0% | - | Skenario: robot hanya berjalan saat ada misi antar (60% waktu shift)
6 | Jam jalan armada per tahun |  | jam/tahun | Dihitung: robot beroperasi x jam/hari x hari/tahun x utilisasi
7 | Rata-rata jam jalan per robot per tahun |  | jam/tahun | Dihitung: beban dibagi rata ke semua robot karena rotasi
B | Umur & keandalan komponen
8 | Waktu jalan per pengisian baterai | 3.0 | jam | Charter proyek: baterai 2x18650, pemakaian +/-3 jam per pengisian
9 | Jumlah pengisian baterai per tahun |  | kali/tahun | Dihitung: jam jalan armada / waktu jalan per pengisian
10 | Umur siklus sel 18650 | 500 | siklus | Estimasi umum sel Li-ion konsumen (300-500 siklus sampai kapasitas 80%); dipakai nilai atas karena arus beban kecil
11 | Umur motor N20 (motor DC sikat) | 1000 | jam | Estimasi kelompok untuk motor DC sikat ukuran kecil; diverifikasi dari data riwayat tahun pertama
12 | Umur ban roda silikon | 1500 | jam | Estimasi kelompok (lantai pabrik halus); diverifikasi dari data riwayat
13 | Umur ball caster | 3000 | jam | Estimasi kelompok
14 | Laju kerusakan modul elektronik | 10.0% | per unit per tahun | Estimasi kelompok: 1 dari 10 modul rusak per tahun (salah colok, benturan, ESD)
15 | Laju kerusakan sensor IR | 5.0% | per sensor per tahun | Estimasi kelompok: sensor di bawah PCB jarang terbentur
16 | Waktu rata-rata penggantian komponen (MTTR) | 1.0 | jam per kejadian | Estimasi: modul dipasang lewat header/konektor; termasuk uji ulang di lintasan
C | Tenaga kerja
17 | UMK Kota Surabaya 2026 | 5288796 | Rp/bulan | Kepgub Jatim No. 100.3.3.1/937/013/2025 (berlaku 1 Jan 2026) - https://www.jawapos.com/surabaya-raya/2512250021/resmi-ini-daftar-umk-38-kabupatenkota-di-jawa-timur-2026-surabaya-nyaris-rp-53-juta
18 | Beban BPJS + THR pemberi kerja | 18.9% | dari upah | BPJS Kesehatan 4% + BPJS Ketenagakerjaan +/-6,5% (JHT 3,7%, JP 2%, JKK 0,54%, JKM 0,3%) + THR 1/12 (8,33%)
19 | Pembagi upah per jam | 173 | jam/bulan | PP 35/2021: upah sejam = 1/173 x upah sebulan
20 | Biaya teknisi per jam |  | Rp/jam | Dihitung: UMK x (1 + beban) / 173. Teknisi pemeliharaan diasumsikan dibayar setara UMK Surabaya
D | Ekonomi, utilitas & lintasan
21 | Eskalasi harga per tahun | 3.5% | per tahun | Batas atas sasaran inflasi BI 2026-2027 (2,5% +/- 1%); inflasi Juni 2026 = 3,34% - https://ekonomi.republika.co.id/berita/t8fpk6423/bi-optimistis-inflasi-20262027-tetap-terkendali-dalam-target
22 | Kontingensi OPEX | 10.0% | dari subtotal OPEX | Cadangan untuk kerusakan di luar perkiraan dan kenaikan harga komponen impor
23 | Tarif listrik industri I-3/TM | 1114.74 | Rp/kWh | Tarif PLN nonsubsidi triwulan IV 2026 (tidak berubah dari triwulan III) - https://www.fortuneidn.com/news/tarif-listrik-per-1-oktober-2026-d7w02-00-lflgw-zwfyxs
24 | Tegangan nominal baterai 2S | 7.4 | V | Spesifikasi robot (2x18650 seri)
25 | Kapasitas sel 18650 | 2.6 | Ah | Sel 2.600 mAh
26 | Efisiensi pengisian | 85.0% | - | Estimasi charger boost 2S USB-C
27 | Energi listrik per pengisian |  | Wh | Dihitung: V x Ah / efisiensi
28 | Panjang garis lintasan di lantai produksi | 60 | m | Skenario tata letak: rute antar 4 stasiun dengan persimpangan 90 derajat
29 | Bagian garis yang diganti per tahun | 50.0% | dari panjang | Estimasi: pita aus karena lalu lintas troli dan pejalan kaki
30 | Pagu anggaran 5 tahun | 100000000 | Rp | Ketentuan tugas: dana maksimal Rp 100.000.000
31 | Tahun anggaran pertama | 2027 | - | Asumsi: sistem sudah beroperasi, anggaran pemeliharaan mulai tahun anggaran 2027

Sheet: Jadwal PM
Jadwal Pemeliharaan Preventif (per tahun)
Jam kerja teknisi dari tabel ini menjadi biaya tenaga kerja preventif di sheet OPEX.
Pemeriksaan awal shift dikerjakan operator (autonomous maintenance), jamnya dicatat tapi tidak dibiayakan di RAB ini.
No | Kegiatan | Rincian pekerjaan | Pelaksana | Frekuensi | Kali per tahun | Durasi per objek (menit) | Dasar | Jumlah objek | Jam per tahun | Alat utama
1 | Pemeriksaan awal shift | Cek tegangan baterai di OLED, bersihkan sensor dengan kuas antistatis, cek roda & ball caster, uji jalan 1 putaran | Operator | Harian |  | 3 | per robot |  |  | Kuas antistatis
2 | Pemeliharaan mingguan | Bersihkan sensor IR dengan isopropyl alcohol, kencangkan baut & roda, cek kabel/konektor, cek tegangan sel & BMS, uji di lintasan kalibrasi | Teknisi | Mingguan | 52 | 10 | per robot |  |  | Multimeter, set perkakas, lintasan uji
3 | Pemeliharaan bulanan | Uji kapasitas & tahanan dalam baterai, ukur RPM & arus motor, cek sinyal encoder, unduh log kejadian & cek versi firmware | Teknisi | Bulanan | 12 | 30 | per robot |  |  | Battery analyzer, tachometer, osiloskop, laptop
4 | Overhaul tahunan | Bongkar total, bersihkan, ganti komponen sesuai kondisi, kalibrasi ulang sensor & PID, uji fungsi lengkap di lintasan 4x4 | Teknisi | Tahunan | 1 | 120 | per robot |  |  | Semua alat kerja
5 | Inspeksi garis lintasan | Cek pita garis terkelupas/kotor, tambal, bersihkan area persimpangan | Teknisi | Mingguan | 52 | 15 | per sistem |  |  | Pita garis, cutter
6 | Perawatan perangkat lunak | Backup firmware & parameter, pembaruan firmware, tinjau log kejadian & data downtime | Teknisi | Bulanan | 12 | 60 | per sistem |  |  | Laptop diagnostik
7 | Stasiun pengisian & keselamatan | Cek adaptor & kabel pengisian, kotak penyimpanan baterai, tekanan APAR | Teknisi | Bulanan | 12 | 30 | per sistem |  |  | Multimeter
 | Jam teknisi per tahun (dibiayakan)
 | Jam operator per tahun (tidak dibiayakan)

Sheet: Suku Cadang
Kebutuhan Suku Cadang per Tahun & Stok Awal Kritis
Harga satuan = RAB PjBL revisi 3.4 (charter proyek). Kebutuhan dihitung dari jam jalan, siklus baterai, atau laju kerusakan di sheet Asumsi.
Stok awal kritis dibeli sekali di tahun 1 (masuk CAPEX); kebutuhan per tahun masuk OPEX.
No | Komponen | Satuan | Harga satuan (Rp) | Jumlah per robot | Dasar penggantian | Umur (jam / siklus) | Laju kerusakan per tahun | Kebutuhan per tahun | Unit per penggantian | Penggantian per tahun | Stok awal kritis | Biaya per tahun (Rp) | Biaya stok awal (Rp) | Sumber harga
1 | Baterai Li-ion 18650 (2.600 mAh) | pcs | 40000 | 2 | Siklus baterai |  |  |  | 2 |  | 4 |  |  | RAB PjBL rev 3.4
2 | Motor N20 6V 500 RPM + encoder | pcs | 55000 | 2 | Aus (jam) |  |  |  | 1 |  | 4 |  |  | RAB PjBL rev 3.4
3 | Roda + ban silikon N20 | pasang | 25000 | 1 | Aus (jam) |  |  |  | 1 |  | 2 |  |  | RAB PjBL rev 3.4
4 | Ball caster mini | pcs | 10000 | 1 | Aus (jam) |  |  |  | 1 |  | 1 |  |  | RAB PjBL rev 3.4
5 | Sensor IR ITR20001 | pcs | 3000 | 5 | Kerusakan acak |  |  |  | 1 |  | 5 |  |  | RAB PjBL rev 3.4
6 | PCB sensor jangkar (fabrikasi) | pcs | 20000 | 1 | Kerusakan acak |  | 10.0% |  | 1 |  | 1 |  |  | RAB PjBL rev 3.4 (paket PCB / 5 lembar)
7 | ESP32 DevKit 30 pin | pcs | 76000 | 1 | Kerusakan acak |  |  |  | 1 |  | 1 |  |  | RAB PjBL rev 3.4
8 | Modul driver motor TB6612FNG | pcs | 25000 | 1 | Kerusakan acak |  |  |  | 1 |  | 1 |  |  | RAB PjBL rev 3.4
9 | Modul buck MP1584 5 V | pcs | 10000 | 1 | Kerusakan acak |  |  |  | 1 |  | 1 |  |  | RAB PjBL rev 3.4
10 | Modul BMS 2S | pcs | 10000 | 1 | Kerusakan acak |  |  |  | 1 |  | 1 |  |  | RAB PjBL rev 3.4
11 | Modul charger 2S USB-C | pcs | 25000 | 1 | Kerusakan acak |  | 20.0% |  | 1 |  | 1 |  |  | RAB PjBL rev 3.4 (port dicolok tiap hari: laju 20%)
12 | OLED 1,3 inci I2C | pcs | 52000 | 1 | Kerusakan acak |  | 5.0% |  | 1 |  | 1 |  |  | RAB PjBL rev 3.4
13 | Holder baterai 2x18650 | pcs | 8000 | 1 | Kerusakan acak |  |  |  | 1 |  | 1 |  |  | RAB PjBL rev 3.4
14 | Saklar geser on/off | pcs | 3000 | 1 | Kerusakan acak |  |  |  | 1 |  | 2 |  |  | RAB PjBL rev 3.4
15 | Tombol tekan | pcs | 1000 | 2 | Kerusakan acak |  |  |  | 1 |  | 2 |  |  | RAB PjBL rev 3.4
16 | Buzzer | pcs | 3000 | 1 | Kerusakan acak |  | 5.0% |  | 1 |  | 1 |  |  | RAB PjBL rev 3.4
17 | Konektor JST PH 6 pin + kabel motor | set | 5000 | 2 | Kerusakan acak |  | 20.0% |  | 1 |  | 4 |  |  | RAB PjBL rev 3.4
18 | Paket komponen pasif (R, C, dioda SS14, header) | paket | 25000 | 1 | Tetap per tahun |  |  |  | 1 |  | 1 |  |  | RAB PjBL rev 3.4
 | Total
 | Jam teknisi untuk penggantian komponen per tahun |  |  |  |  |  |  |  |  |  | jam

Sheet: CAPEX
CAPEX Pemeliharaan (pengadaan sekali, tahun 1)
Harga = estimasi harga pasar daring (marketplace) Oktober 2026 untuk barang setara; cek ulang saat pengadaan.
Total = jumlah x harga x (1 + eskalasi)^(tahun ke - 1), supaya pengadaan yang digeser ke tahun lain ikut naik harga.
No | Kategori | Uraian | Spesifikasi (setara) | Fungsi dalam pemeliharaan | Satuan | Jumlah | Harga satuan (Rp) | Total (Rp) | Tahun ke- | Sumber harga
1 | Peralatan kerja & alat ukur | Laptop diagnostik | Core i3/Ryzen 3, RAM 8 GB, SSD 256 GB | Unggah firmware ESP32, baca log serial, simpan data riwayat perawatan (CMMS sederhana) | unit | 1 | 5500000 |  | 1 | Estimasi marketplace Okt 2026
2 | Peralatan kerja & alat ukur | Osiloskop digital 2 kanal | 100 MHz (setara Hantek DSO2C10) | Cek sinyal PWM motor, pulsa encoder, dan keluaran sensor IR saat diagnosis | unit | 1 | 2500000 |  | 1 | Estimasi marketplace Okt 2026
3 | Peralatan kerja & alat ukur | Multimeter digital acuan | True RMS (setara UNI-T UT61E+) | Ukur tegangan sel & arus; jadi acuan verifikasi alat ukur lain (dikalibrasi tiap tahun) | unit | 1 | 850000 |  | 1 | Estimasi marketplace Okt 2026
4 | Peralatan kerja & alat ukur | Multimeter digital lapangan | Setara UNI-T UT33D+ | Pemeriksaan cepat saat PM mingguan | unit | 1 | 250000 |  | 1 | Estimasi marketplace Okt 2026
5 | Peralatan kerja & alat ukur | Solder station suhu terkendali | Setara Quicko T12 | Ganti konektor, header modul, kabel motor | unit | 1 | 850000 |  | 1 | Estimasi marketplace Okt 2026
6 | Peralatan kerja & alat ukur | Hot air rework station | Setara 858D | Ganti sensor ITR20001 & komponen SMD di PCB sensor | unit | 1 | 750000 |  | 1 | Estimasi marketplace Okt 2026
7 | Peralatan kerja & alat ukur | Catu daya DC laboratorium | 30 V / 5 A | Uji modul & motor di meja tanpa baterai | unit | 1 | 900000 |  | 1 | Estimasi marketplace Okt 2026
8 | Peralatan kerja & alat ukur | Penganalisis & pengisi baterai 18650 | Setara LiitoKala Lii-500 (ukur kapasitas & IR) | Uji kapasitas dan tahanan dalam sel saat PM bulanan, menentukan sel yang diganti | unit | 1 | 450000 |  | 1 | Estimasi marketplace Okt 2026
9 | Peralatan kerja & alat ukur | Tachometer optik digital | Non-kontak | Ukur RPM roda untuk mendeteksi motor yang mulai aus | unit | 1 | 250000 |  | 1 | Estimasi marketplace Okt 2026
10 | Peralatan kerja & alat ukur | Jangka sorong digital | 150 mm | Ukur keausan ban & dimensi suku cadang | unit | 1 | 200000 |  | 1 | Estimasi marketplace Okt 2026
11 | Peralatan kerja & alat ukur | Set perkakas elektronik | Obeng presisi, tang, pinset, crimper JST, penyedot timah | Bongkar pasang robot & pembuatan kabel | set | 1 | 750000 |  | 1 | Estimasi marketplace Okt 2026
12 | Peralatan kerja & alat ukur | Matras ESD + gelang antistatis + kaca pembesar berlampu | - | Mencegah kerusakan modul karena listrik statis saat perbaikan | set | 1 | 600000 |  | 1 | Estimasi marketplace Okt 2026
13 | Peralatan kerja & alat ukur | Kabel USB-C data + USB hub | - | Koneksi laptop ke robot | set | 1 | 250000 |  | 1 | Estimasi marketplace Okt 2026
14 | Infrastruktur perawatan | Lemari suku cadang + kotak sortir berlabel | - | Penyimpanan stok suku cadang dengan sistem label (FIFO) | unit | 1 | 1200000 |  | 1 | Estimasi marketplace Okt 2026
15 | Infrastruktur perawatan | Stasiun pengisian baterai | Rak + 5 adaptor USB-C 5 V/3 A + terminal | Tempat pengisian 5 robot yang tertib dan aman | set | 1 | 600000 |  | 1 | Estimasi marketplace Okt 2026
16 | Infrastruktur perawatan | APAR serbuk ABC 3 kg | - | Keselamatan kebakaran di area pengisian baterai Li-ion | unit | 1 | 450000 |  | 1 | Estimasi marketplace Okt 2026
17 | Infrastruktur perawatan | Kantong/kotak baterai tahan api | - | Penyimpanan baterai cadangan & baterai rusak sebelum dibuang | unit | 2 | 150000 |  | 1 | Estimasi marketplace Okt 2026
18 | Infrastruktur perawatan | Lintasan uji & kalibrasi 4x4 | Papan + pita garis 19 mm, sama dengan lintasan PjBL | Uji fungsi & kalibrasi sensor setelah perbaikan, sebelum robot kembali ke lini | set | 1 | 600000 |  | 1 | Estimasi marketplace Okt 2026
19 | Infrastruktur perawatan | Jig uji sensor & encoder | Rangka + PCB uji sederhana | Uji PCB sensor & motor tanpa membongkar seluruh robot | set | 1 | 400000 |  | 1 | Estimasi marketplace Okt 2026
20 | Stok awal suku cadang kritis | Stok awal suku cadang kritis | Rincian di sheet Suku Cadang | Mengurangi downtime: robot langsung diperbaiki tanpa menunggu pengiriman | paket | 1 |  |  | 1 | Sheet Suku Cadang
21 | Pelatihan & dokumentasi awal | Pelatihan awal teknisi & operator | 2 hari, oleh tim perancang | Teknisi paham perawatan, keselamatan baterai Li-ion, unggah firmware; operator paham pemeriksaan awal shift | paket | 1 | 1500000 |  | 1 | Estimasi kelompok
22 | Pelatihan & dokumentasi awal | Printer label aset / kode QR | Setara Brother PT-E110 | Label aset tiap robot & suku cadang, terhubung ke kartu riwayat perawatan | unit | 1 | 500000 |  | 1 | Estimasi marketplace Okt 2026
23 | Pelatihan & dokumentasi awal | Cetak SOP, checklist PM & kartu riwayat | Laminasi | Dokumen kerja di stasiun perawatan | paket | 1 | 150000 |  | 1 | Estimasi kelompok
 |  | Total CAPEX

Sheet: OPEX
OPEX Pemeliharaan per Tahun (harga naik sesuai eskalasi)
Biaya tahun t = volume x harga tahun 1 x (1 + eskalasi)^(t - 1), hanya pada tahun kelipatan interval.
Volume suku cadang, jam preventif, dan jam penggantian diambil dari sheet Suku Cadang dan Jadwal PM.
 |  |  |  |  |  |  | indeks tahun | 1 | 2 | 3 | 4 | 5
No | Kategori | Uraian | Dasar perhitungan | Satuan | Volume per tahun | Harga satuan th-1 (Rp) | Interval (tahun) | Tahun 1 | Tahun 2 | Tahun 3 | Tahun 4 | Tahun 5 | Total 5 tahun (Rp)
 |  |  |  |  |  |  | tahun anggaran
1 | Suku cadang penggantian | Suku cadang penggantian | Kebutuhan per tahun dari sheet Suku Cadang | paket | 1.0 |  | 1
2 | Bahan habis pakai | Timah solder + flux | 1 paket per triwulan | paket | 4.0 | 25000 | 1
3 | Bahan habis pakai | Isopropyl alcohol 99% 1 L | Pembersih sensor IR saat PM mingguan | botol | 2.0 | 90000 | 1
4 | Bahan habis pakai | Cotton bud + kain mikrofiber | 1 paket per triwulan | paket | 4.0 | 40000 | 1
5 | Bahan habis pakai | Kabel AWG26, heat shrink, cable tie | Perbaikan kabel motor & konektor | paket | 2.0 | 75000 | 1
6 | Bahan habis pakai | Baut, mur, spacer M3 | Pengganti baut aus/hilang | paket | 4.0 | 15000 | 1
7 | Bahan habis pakai | Mata solder pengganti | Aus pemakaian | pcs | 2.0 | 60000 | 1
8 | Bahan habis pakai | Contact cleaner spray | Pembersih konektor & saklar | kaleng | 2.0 | 65000 | 1
9 | Bahan habis pakai | Pita garis lantai 19 mm (roll 33 m) | Panjang lintasan x bagian yang diganti / 33 m per roll | roll |  | 180000 | 1
10 | Tenaga kerja pemeliharaan | Pemeliharaan preventif oleh teknisi | Jam teknisi dari sheet Jadwal PM | jam |  |  | 1
11 | Tenaga kerja pemeliharaan | Penggantian komponen (terencana + korektif) | Jumlah penggantian x MTTR dari sheet Suku Cadang | jam |  |  | 1
12 | Kalibrasi alat ukur | Kalibrasi multimeter acuan (lab terakreditasi KAN) | 1x per tahun; alat lain diverifikasi internal terhadap multimeter acuan | kali | 1.0 | 400000 | 1
13 | Pelatihan penyegaran | Pelatihan penyegaran teknisi & operator | 1 hari per tahun, materi + konsumsi | paket | 1.0 | 500000 | 1
14 | Listrik pengisian baterai | Listrik pengisian baterai | Jumlah pengisian x energi per pengisian / 1000 | kWh |  |  | 1
 |  | Subtotal sebelum kontingensi
 | Kontingensi | Kontingensi OPEX | Persentase kontingensi x subtotal
 |  | Total OPEX
