Mervs111/Line-Follower-Racer/arsip/mechanical/LTM_v12.step

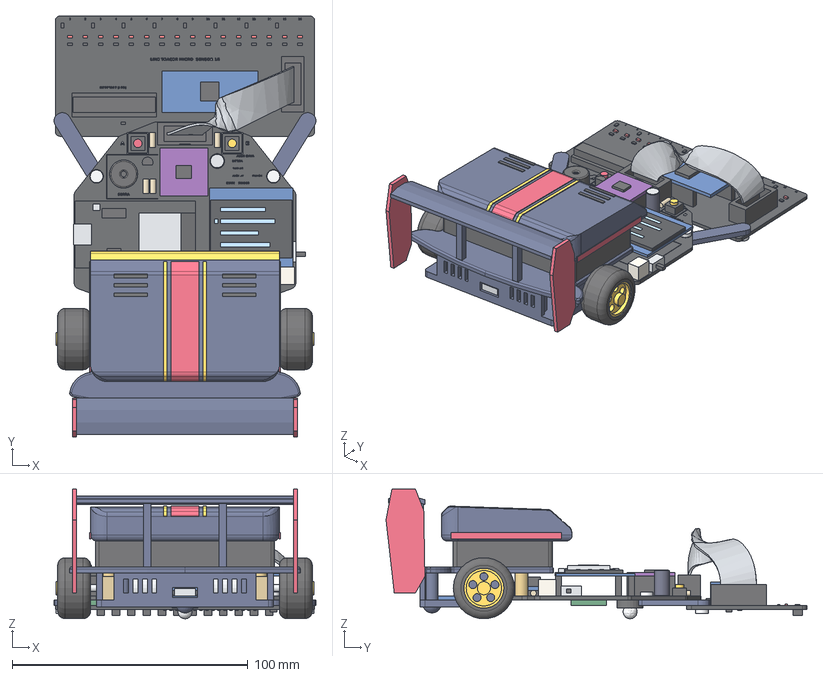
[picture p60: CAD file, 2026-10-14]
arsip/mechanical/LTM_v12.step
111.0 x 178.5 x 55.0 mm
00_PCB_utama
01_Pad_lubang
02_Silkscreen_utama
03_Box_header_IDC_J5
04_ESP32_socket
05_ESP32_socket
06_ESP32_PCB
07_ESP32_antena
08_ESP32_modul
09_ESP32_USB-C
10_ESP32_chip
11_ESP32_tombol
12_OLED_socket
13_OLED_PCB
14_OLED_kaca
15_OLED_tampilan
16_TB6612_socket
17_TB6612_socket
18_TB6612_PCB
19_TB6612_chip
20_MP1584_PCB
21_MP1584_pin
22_MP1584_induktor
23_MP1584_trimpot
24_Tombol
25_Tombol_tutup
26_Tombol
27_Tombol_tutup
28_Buzzer
29_Saklar
30_Saklar_tuas
31_JST_XH_baterai
32_JST_PH_motor
33_JST_PH_motor
34_Resistor_THT
35_Elko_C1_100uF
36_Elko_C1_100uF_tutup
37_Transistor_S8050
38_Dioda_1N5819
39_Dioda_1N5819_cincin
40_Ball_caster_rumah
41_Ball_caster_bola
42_PCB_sensor_16_titik
43_Sensor_ITR20001_x16
44_Resistor_SMD_bawah
45_LED_indikator_x16
46_Resistor_SMD_atas
47_Silkscreen_sensor
48_Pad_lubang_sensor
49_MCP23017_socket
50_MCP23017
51_Mux_socket
52_Modul_mux_PCB
53_Modul_mux_chip
54_Box_header_IDC_J1
55_SMD_kecil_sensor
56_Kabel_pita_12_pin
57_Lengan_dudukan_sensor
58_Baut_dudukan
59_Lengan_dudukan_sensor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
