Mervs111/Line-Follower-Racer/arsip/mechanical/v14/dxf/pcb_sensor_posisi_led_fototransistor.dxf

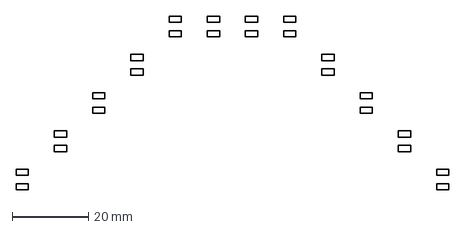
[picture p61: CAD file, 2026-10-20]
arsip/mechanical/v14/dxf/pcb_sensor_posisi_led_fototransistor.dxf
113.2 x 45.4 mm
