Mervs111/Line-Follower-Racer/hardware/outline/pcb_sensor_outline_simetris.dxf

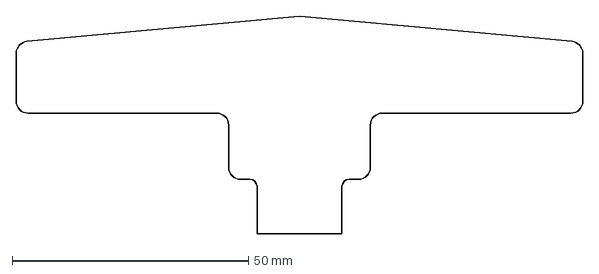
[picture p62: CAD file, 2026-10-21]
hardware/outline/pcb_sensor_outline_simetris.dxf
120.0 x 46.0 mm
