Mervs111/Line-Follower-Racer/mechanical/rakitan-pcb/LFM_rakitan_pcb.step

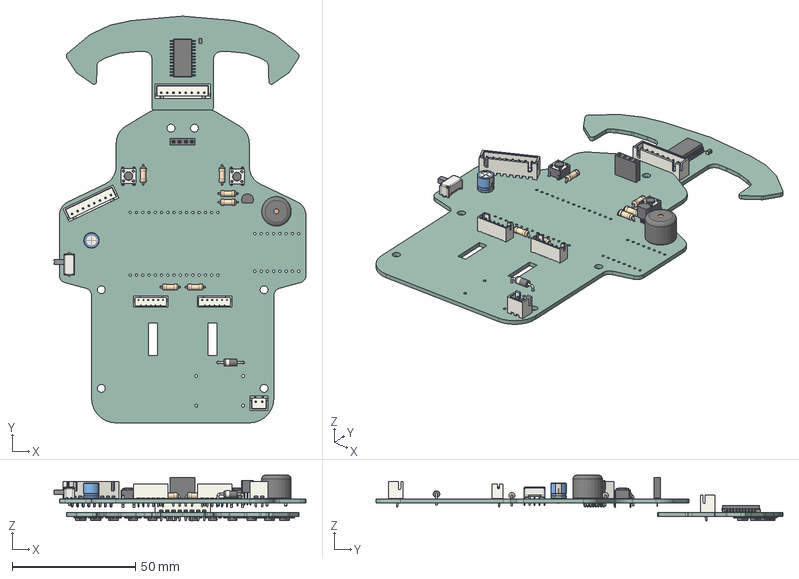
[picture p63: CAD file, 2026-10-24]
mechanical/rakitan-pcb/LFM_rakitan_pcb.step
102.2 x 165.0 x 18.5 mm
JST_B8B_XH_A x 2
C_0805_2012Metric
SOIC-24W_7.5x15.4mm_P1.27mm
R_0805_2012Metric x 24
OnSemi_CASE100CY x 12
sensor-garis_PCB
D_DO-41_SOD81_P10.16mm_Horizontal
TO-92_Inline_Narrow
PinSocket_1x04_P2.54mm_Vertical
SW_PUSH_6mm x 2
R_Axial_DIN0207_L63mm_D25mm_P762mm_Horizontal x 6
SW_Slide_SPDT_Angled_CK_OS102011MA1Q
JST_B6B_PH_K x 2
CP_Radial_D63mm_P250mm
Buzzer_12x95RM76
JST_B2B_XH_A
pcb-utama_PCB
