Mervs111/Line-Follower-Racer/mechanical/v16/dxf/pcb_sensor_outline.dxf

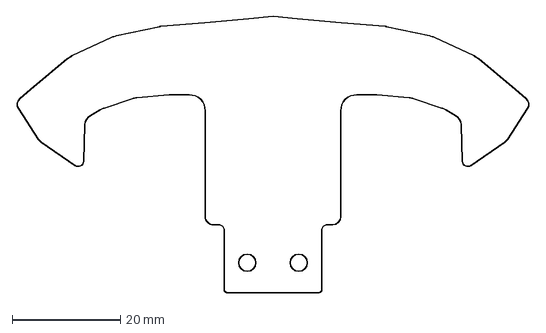
[picture p64: CAD file, 2026-10-22]
mechanical/v16/dxf/pcb_sensor_outline.dxf
94.7 x 51.0 mm
