Mervs111/Line-Follower-Racer/mechanical/v16/step/pcb_sensor.step

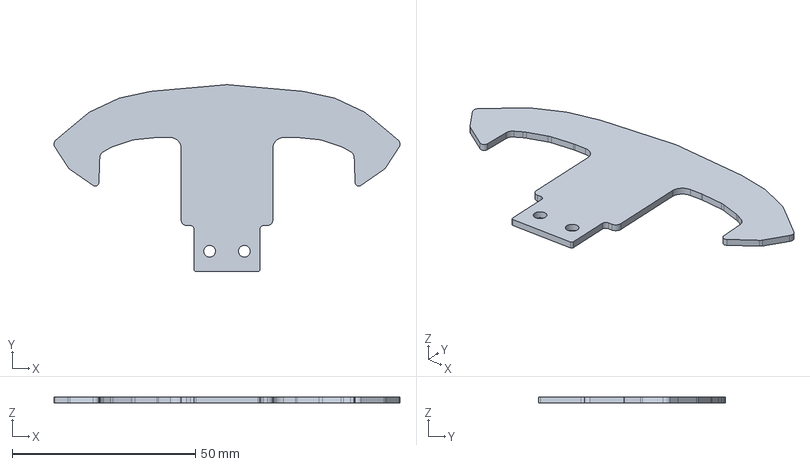
[picture p65: CAD file, 2026-10-22]
mechanical/v16/step/pcb_sensor.step
94.4 x 51.0 x 1.60 mm
