Mervs111/Line-Follower-Racer/simulasi/coppeliasim/mesh/g17.obj

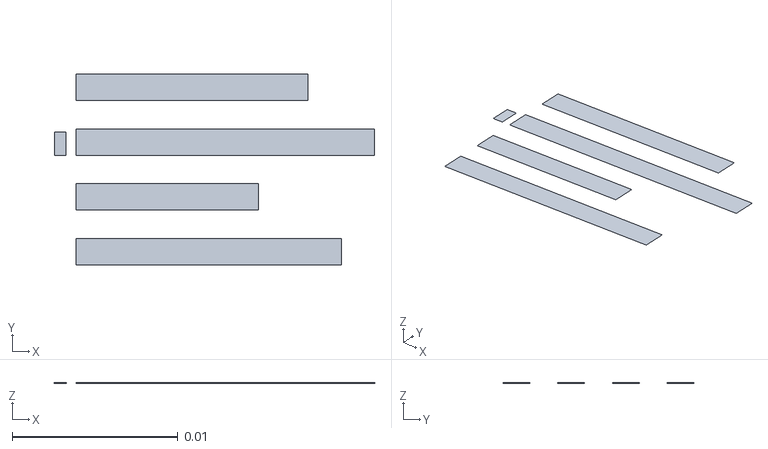
[picture p66: CAD file, 2026-10-26]
simulasi/coppeliasim/mesh/g17.obj
0.0193 x 0.0115 x 2e-05
