Mervs111/Line-Follower-Racer/mechanical/v16/dxf/pcb_utama_outline.dxf

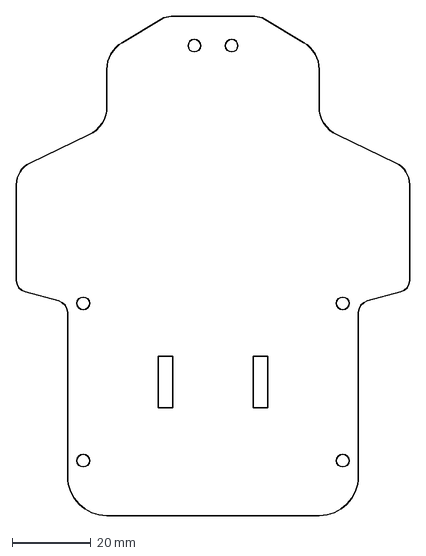
[picture p67: CAD file, 2026-10-22]
mechanical/v16/dxf/pcb_utama_outline.dxf
100.0 x 127.0 mm
