Mervs111/Line-Follower-Racer/mechanical/v16/step/cetak_tiang_sayap.step

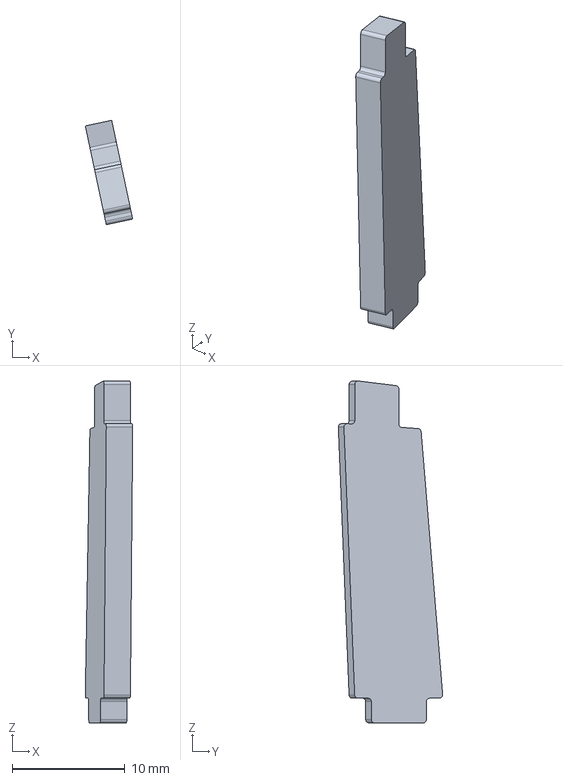
[picture p68: CAD file, 2026-10-22]
mechanical/v16/step/cetak_tiang_sayap.step
4.21 x 9.26 x 30.4 mm
