Mervs111/Line-Follower-Racer/simulasi/coppeliasim/mesh/g04.obj

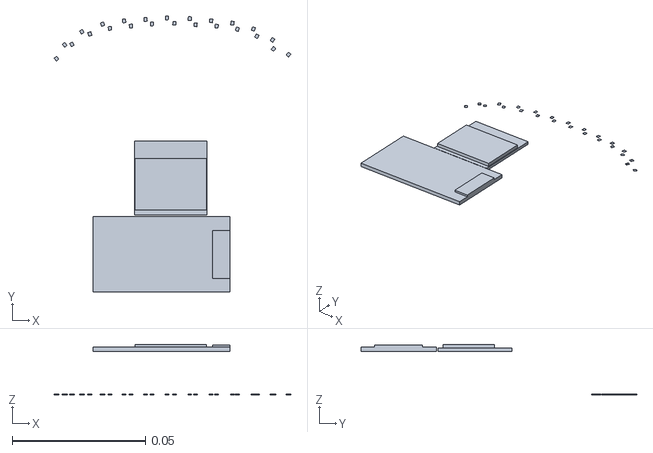
[picture p69: CAD file, 2026-10-26]
simulasi/coppeliasim/mesh/g04.obj
0.089 x 0.104 x 0.0188
