Mervs111/Line-Follower-Racer/arsip/mechanical/v14/step/pcb_utama.step

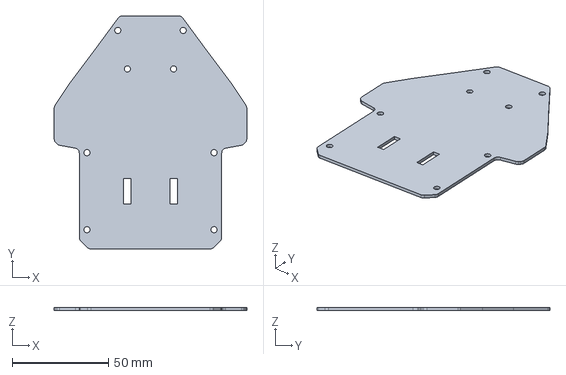
[picture p70: CAD file, 2026-10-20]
arsip/mechanical/v14/step/pcb_utama.step
100.0 x 121.0 x 1.60 mm
