Mervs111/Line-Follower-Racer/mechanical/v16/dxf/pcb_sensor_posisi_qre1113.dxf

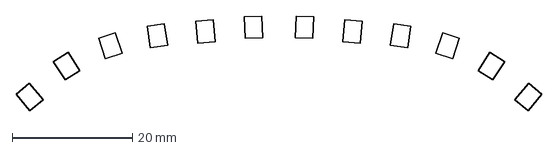
[picture p71: CAD file, 2026-10-22]
mechanical/v16/dxf/pcb_sensor_posisi_qre1113.dxf
87.3 x 15.8 mm
