Mervs111/Line-Follower-Racer/mechanical/v16/step/cetak_dudukan_motor_baterai.step

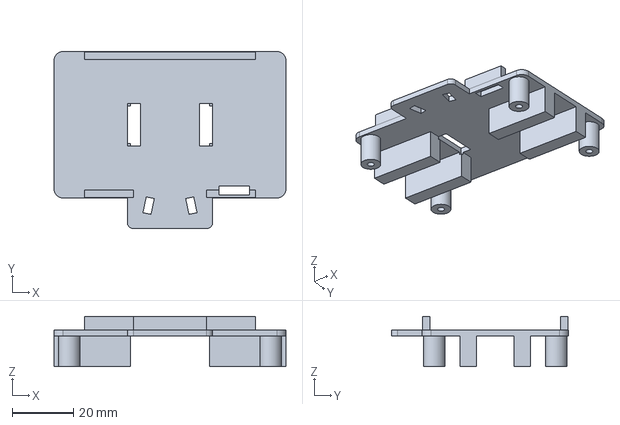
[picture p72: CAD file, 2026-10-22]
mechanical/v16/step/cetak_dudukan_motor_baterai.step
76.0 x 58.0 x 16.5 mm
