Mervs111/Line-Follower-Racer/simulasi/coppeliasim/mesh/g05.obj

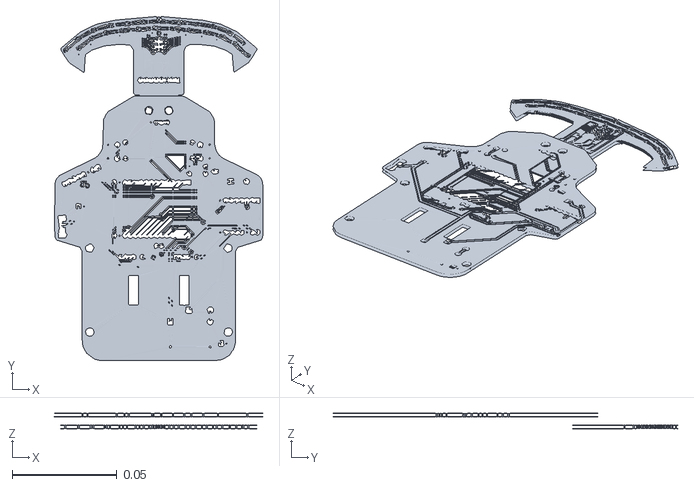
[picture p73: CAD file, 2026-10-26]
simulasi/coppeliasim/mesh/g05.obj
0.0993 x 0.164 x 0.00728
