Mervs111/Line-Follower-Racer/mechanical/v16/step/LTM_v16_rakitan.step

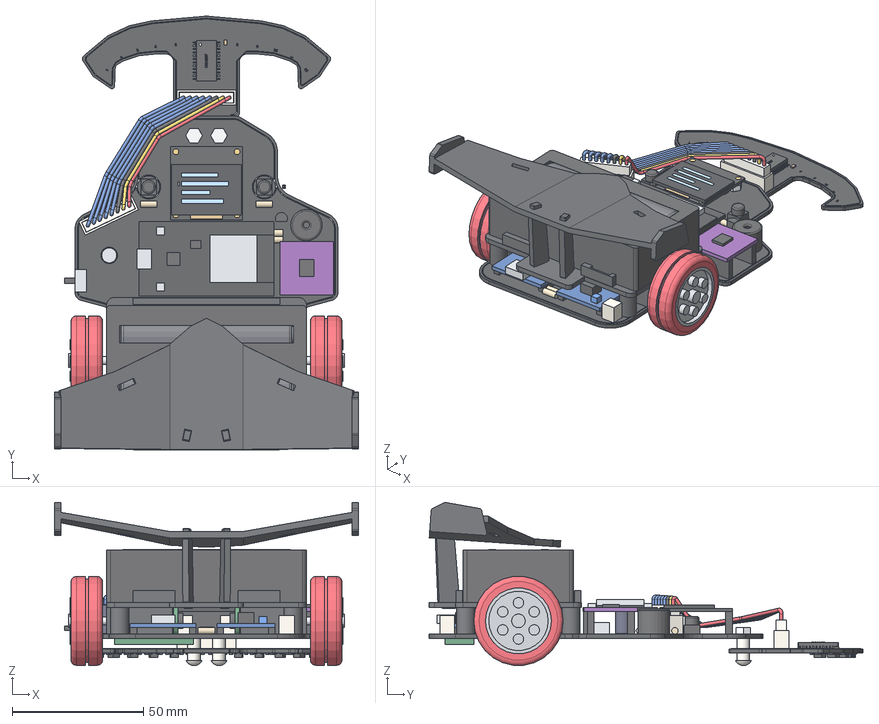
[picture p74: CAD file, 2026-10-22]
mechanical/v16/step/LTM_v16_rakitan.step
115.6 x 165.0 x 62.1 mm
000_PCB_sensor
001_Sensor_QRE1113GR_x12
002_QRE1113GR_lensa
003_QRE1113GR_kaki
004_Resistor_SMD_sensor
005_Silkscreen_sensor
006_Silkscreen_sensor_bawah
007_Pad_lubang_sensor
008_IC_mux_CD74HC4067_SOIC-24
009_IC_mux_kaki
010_IC_mux_tanda
011_C_100_nF_mux
012_Header_JST_XH_J1
013_Steker_JST_XH_J1
014_Skid_nilon
015_Spacer_nilon_4_mm
016_Mur_M3
017_Skid_nilon
018_Spacer_nilon_4_mm
019_Mur_M3
020_PCB_utama
021_Pad_lubang_utama
022_Silkscreen_utama
023_Header_JST_XH_J5
024_Steker_JST_XH_J5
025_OLED_socket
026_OLED_standoff
027_OLED_standoff
028_OLED_PCB
029_OLED_kaca
030_OLED_flex
031_OLED_tampilan
032_OLED_lubang
033_OLED_lubang
034_OLED_lubang
035_OLED_lubang
036_ESP32_socket
037_ESP32_socket
038_ESP32_PCB
039_ESP32_modul
040_ESP32_antena
041_ESP32_USB
042_ESP32_chip
043_ESP32_tombol
044_TB6612_socket
045_TB6612_socket
046_TB6612_PCB
047_TB6612_chip
048_Tombol
049_Tombol_tutup
050_Tombol
051_Tombol_tutup
052_Buzzer
053_Saklar
054_Saklar_tuas
055_Elko_C1_100uF
056_Elko_C1_tutup
057_Transistor_S8050
058_Resistor_THT
059_Dioda_1N5819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
