Mervs111/Line-Follower-Racer/simulasi/coppeliasim/mesh/g24.obj

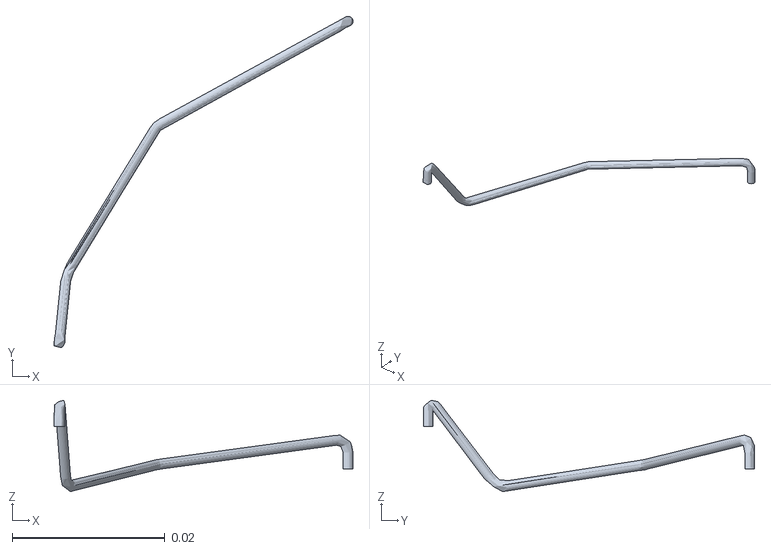
[picture p75: CAD file, 2026-10-26]
simulasi/coppeliasim/mesh/g24.obj
0.0392 x 0.0434 x 0.012
