Mervs111/Line-Follower-Racer/arsip/mechanical/v14/step/cetak_masker_sensor.step

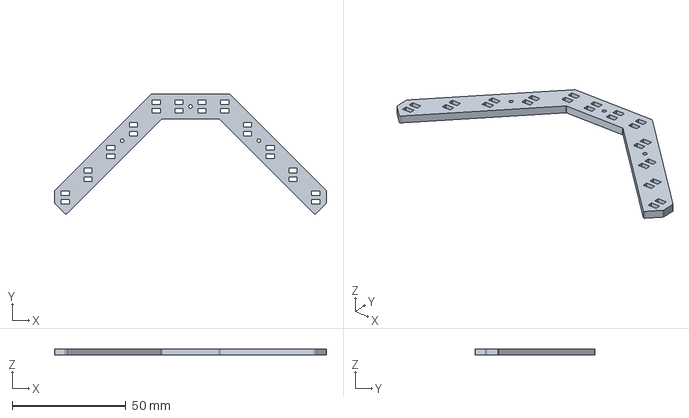
[picture p76: CAD file, 2026-10-20]
arsip/mechanical/v14/step/cetak_masker_sensor.step
119.4 x 52.7 x 2.80 mm
