Mervs111/Line-Follower-Racer/mechanical/v16/step/pcb_utama.step

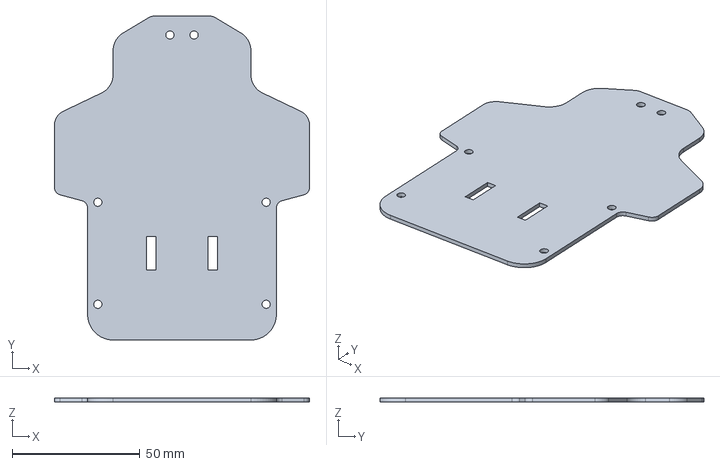
[picture p77: CAD file, 2026-10-22]
mechanical/v16/step/pcb_utama.step
100.0 x 127.0 x 1.60 mm
