Mervs111/Line-Follower-Racer/simulasi/coppeliasim/mesh/g15.obj

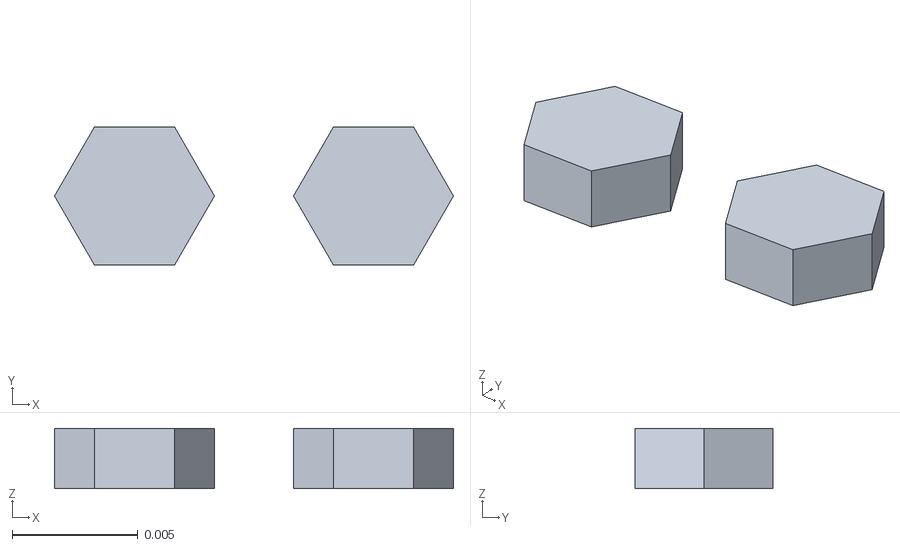
[picture p78: CAD file, 2026-10-26]
simulasi/coppeliasim/mesh/g15.obj
0.0159 x 0.0055 x 0.0024
