Mervs111/Line-Follower-Racer/mechanical/v16/step/roda_34x12.step

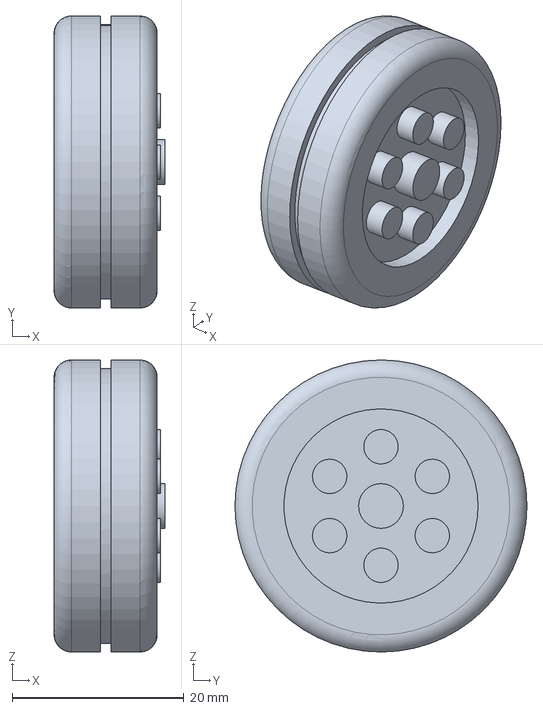
[picture p79: CAD file, 2026-10-22]
mechanical/v16/step/roda_34x12.step
12.9 x 34.0 x 34.0 mm
