Mervs111/Line-Follower-Racer/simulasi/coppeliasim/mesh/g16.obj

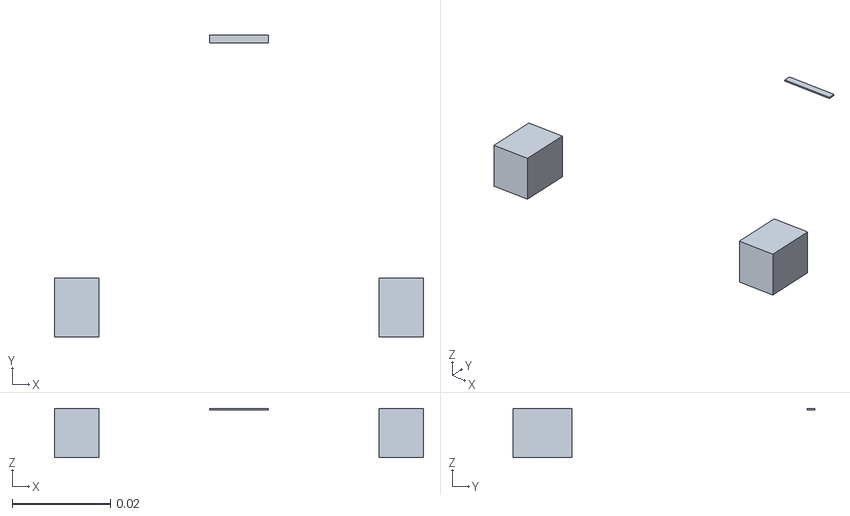
[picture p80: CAD file, 2026-10-26]
simulasi/coppeliasim/mesh/g16.obj
0.075 x 0.0614 x 0.01
