Mervs111/Line-Follower-Racer/arsip/mechanical/v14/step/LTM_v14_rakitan.step

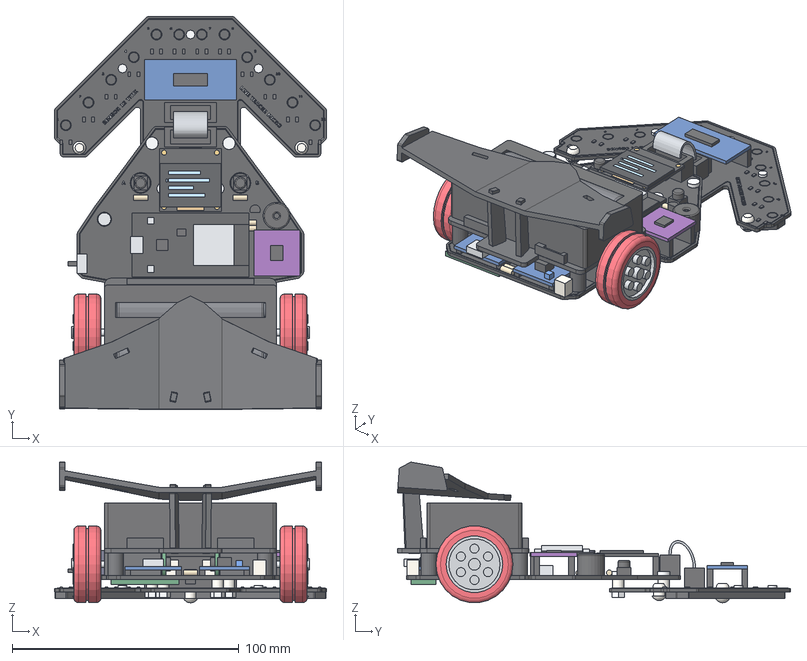
[picture p81: CAD file, 2026-10-20]
arsip/mechanical/v14/step/LTM_v14_rakitan.step
120.0 x 173.5 x 62.1 mm
000_PCB_sensor
001_LED_sensor_merah_SMD_1206_x12
002_LED_sensor_chip
003_Fototransistor_SMD_1206_x12
004_Fototransistor_chip
005_Resistor_SMD_sensor
006_Silkscreen_sensor
007_Pad_lubang_sensor
008_Mux_socket
009_Modul_mux_PCB
010_Modul_mux_chip
011_Box_header_IDC_J1
012_Baut_nilon_kepala
013_Skid_nilon
014_Baut_nilon_kepala
015_Skid_nilon
016_Baut_nilon_kepala
017_Skid_nilon
018_Baut_M2_masker
019_Baut_M2_masker
020_Baut_M2_masker
021_Masker_sensor_3D_print
022_Spacer_nilon_4_mm
023_Baut_M3
024_Mur_M3
025_Spacer_nilon_4_mm
026_Baut_M3
027_Mur_M3
028_Spacer_nilon_4_mm
029_Baut_M3
030_Mur_M3
031_Spacer_nilon_4_mm
032_Baut_M3
033_Mur_M3
034_PCB_utama
035_Pad_lubang_utama
036_Silkscreen_utama
037_Box_header_IDC_J5
038_OLED_socket
039_OLED_standoff
040_OLED_standoff
041_OLED_PCB
042_OLED_kaca
043_OLED_flex
044_OLED_tampilan
045_OLED_lubang
046_OLED_lubang
047_OLED_lubang
048_OLED_lubang
049_ESP32_socket
050_ESP32_socket
051_ESP32_PCB
052_ESP32_modul
053_ESP32_antena
054_ESP32_USB
055_ESP32_chip
056_ESP32_tombol
057_TB6612_socket
058_TB6612_socket
059_TB6612_PCB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
