Mervs111/Line-Follower-Racer/mechanical/v16/step/cetak_sayap_belakang.step

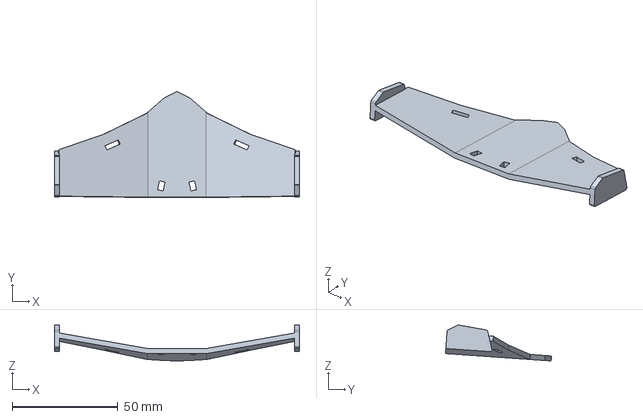
[picture p82: CAD file, 2026-10-22]
mechanical/v16/step/cetak_sayap_belakang.step
115.6 x 50.0 x 17.0 mm
