Mervs111/Line-Follower-Racer/simulasi/coppeliasim/mesh/g14.obj

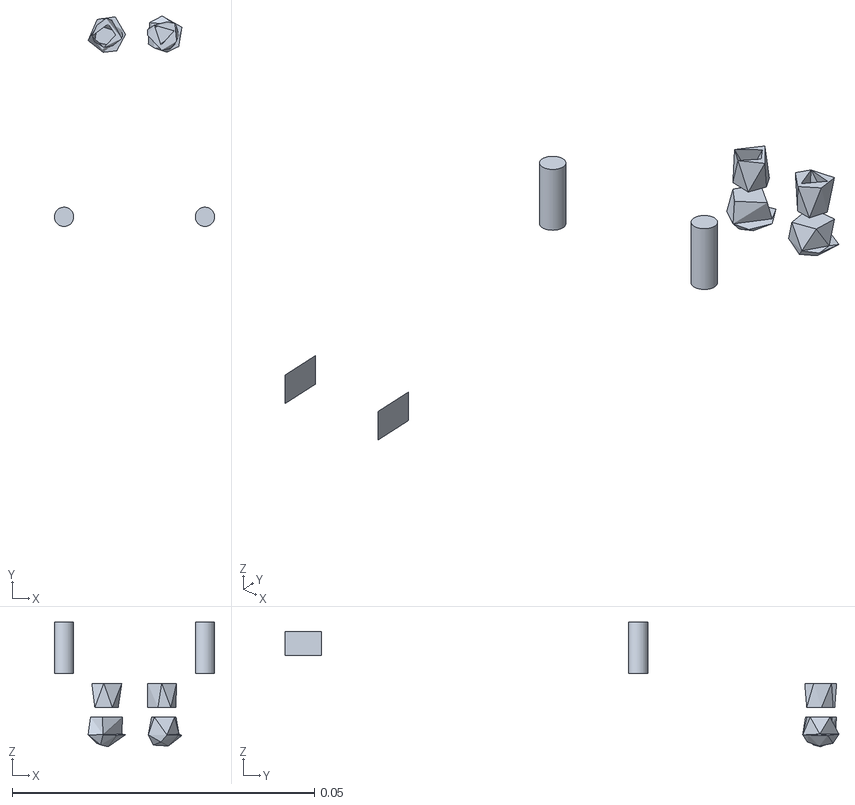
[picture p83: CAD file, 2026-10-26]
simulasi/coppeliasim/mesh/g14.obj
0.0265 x 0.0916 x 0.0206
