Mervs111/Line-Follower-Racer/simulasi/coppeliasim/mesh/g20.obj

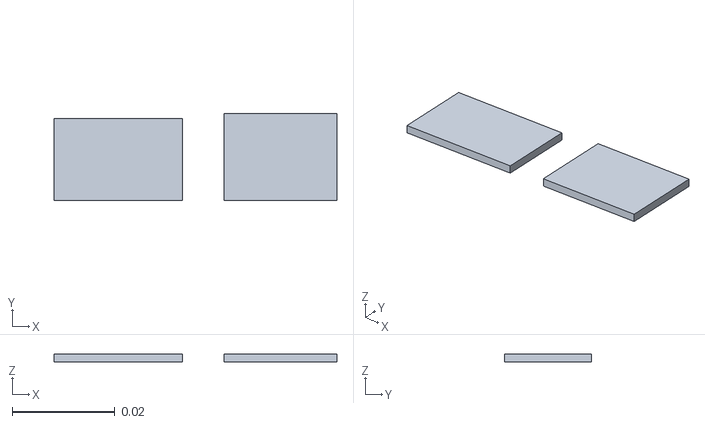
[picture p84: CAD file, 2026-10-26]
simulasi/coppeliasim/mesh/g20.obj
0.055 x 0.017 x 0.0016
