Mervs111/Line-Follower-Racer/simulasi/coppeliasim/mesh/g02.obj

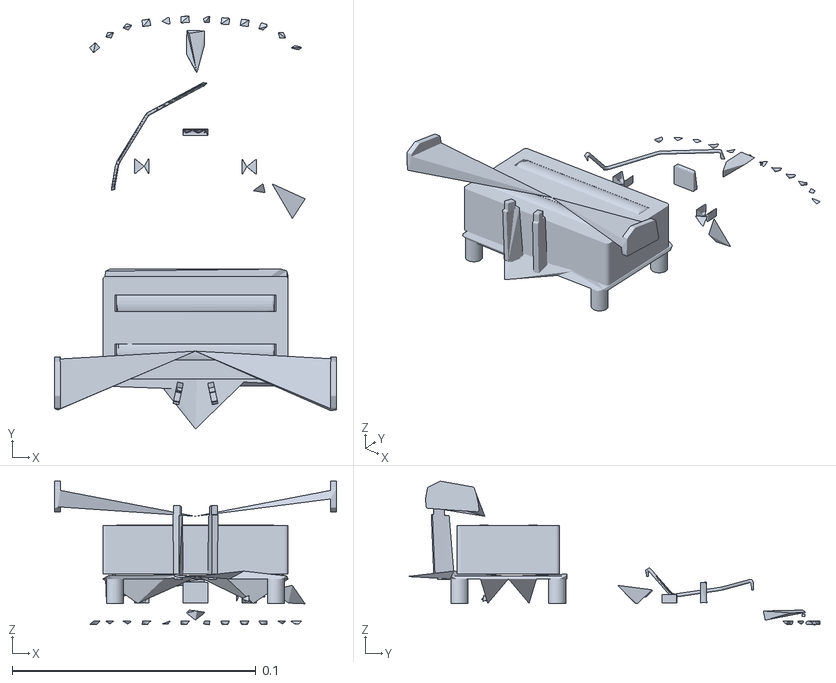
[picture p85: CAD file, 2026-10-26]
simulasi/coppeliasim/mesh/g02.obj
0.116 x 0.169 x 0.0589
