Mervs111/Line-Follower-Racer/simulasi/coppeliasim/mesh/g03.obj

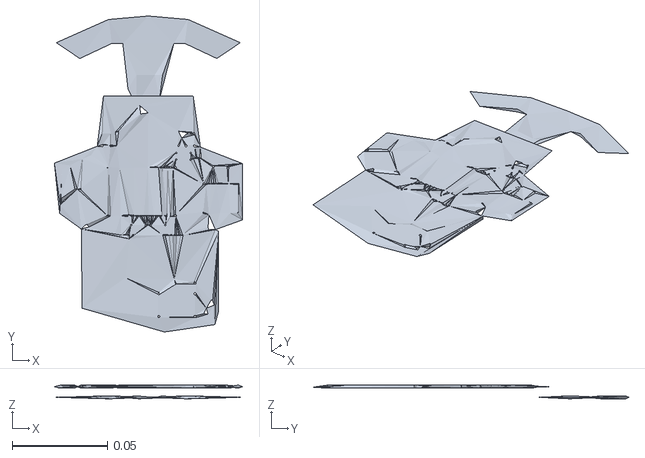
[picture p86: CAD file, 2026-10-26]
simulasi/coppeliasim/mesh/g03.obj
0.099 x 0.166 x 0.0072
