Mervs111/Line-Follower-Racer/simulasi/coppeliasim/mesh/g13.obj

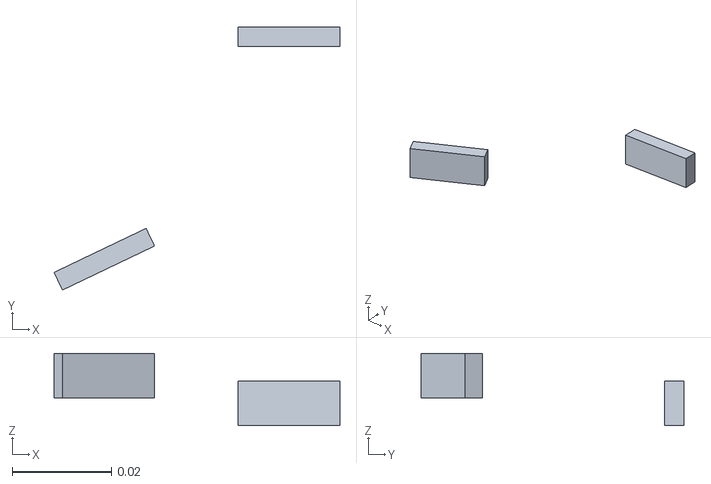
[picture p87: CAD file, 2026-10-26]
simulasi/coppeliasim/mesh/g13.obj
0.0577 x 0.0531 x 0.0146
