Mervs111/Line-Follower-Racer/simulasi/coppeliasim/mesh/g11.obj

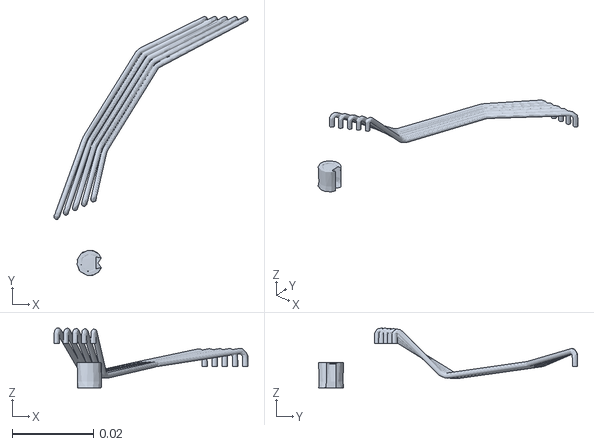
[picture p88: CAD file, 2026-10-26]
simulasi/coppeliasim/mesh/g11.obj
0.0477 x 0.0637 x 0.0147
