Mervs111/Line-Follower-Racer/simulasi/coppeliasim/mesh/g18.obj

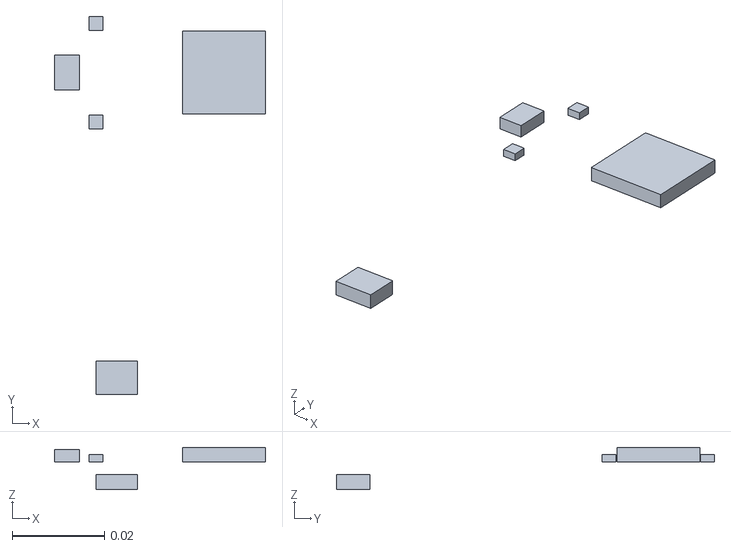
[picture p89: CAD file, 2026-10-26]
simulasi/coppeliasim/mesh/g18.obj
0.0457 x 0.0818 x 0.0091
