Mervs111/Line-Follower-Racer/simulasi/coppeliasim/mesh/g23.obj

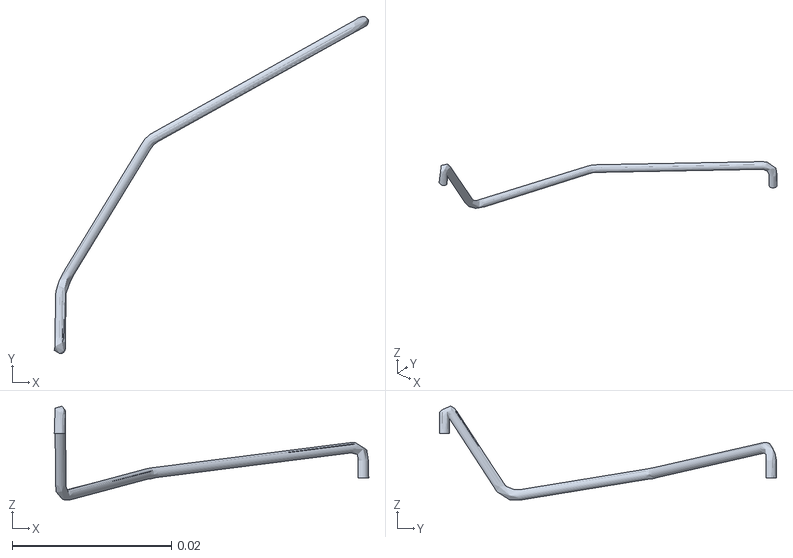
[picture p90: CAD file, 2026-10-26]
simulasi/coppeliasim/mesh/g23.obj
0.0395 x 0.0424 x 0.0118
