Mervs111/Line-Follower-Racer/simulasi/coppeliasim/mesh/g09.obj

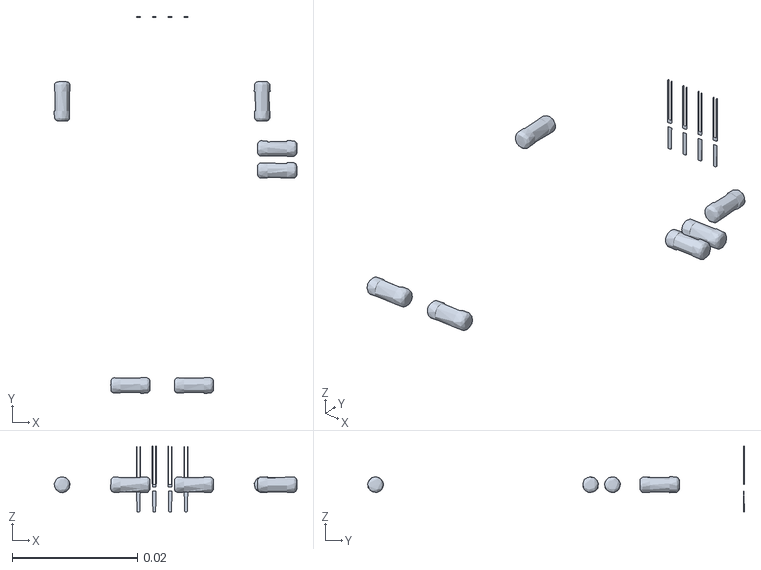
[picture p91: CAD file, 2026-10-26]
simulasi/coppeliasim/mesh/g09.obj
0.0389 x 0.0603 x 0.0105
