Mervs111/Line-Follower-Racer/simulasi/coppeliasim/mesh/g12.obj

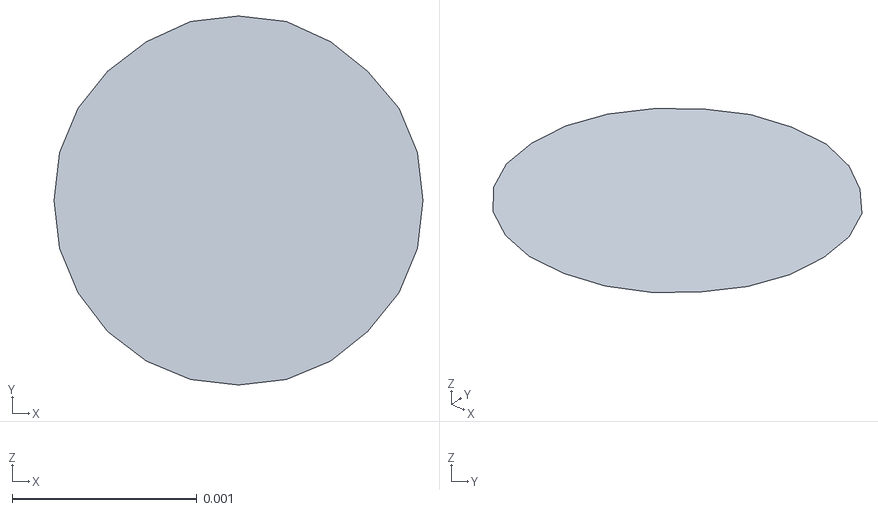
[picture p92: CAD file, 2026-10-26]
simulasi/coppeliasim/mesh/g12.obj
0.002 x 0.002 x 0
