Mervs111/Line-Follower-Racer/simulasi/coppeliasim/mesh/g10.obj

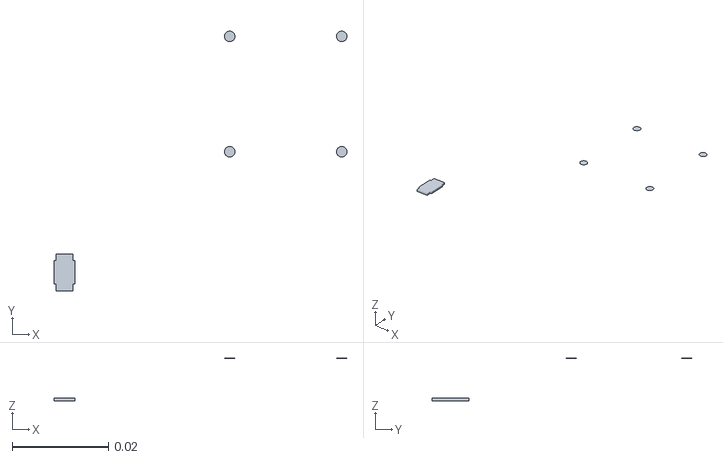
[picture p93: CAD file, 2026-10-26]
simulasi/coppeliasim/mesh/g10.obj
0.0609 x 0.0541 x 0.00887
