Mervs111/Line-Follower-Racer/simulasi/coppeliasim/mesh/g22.obj

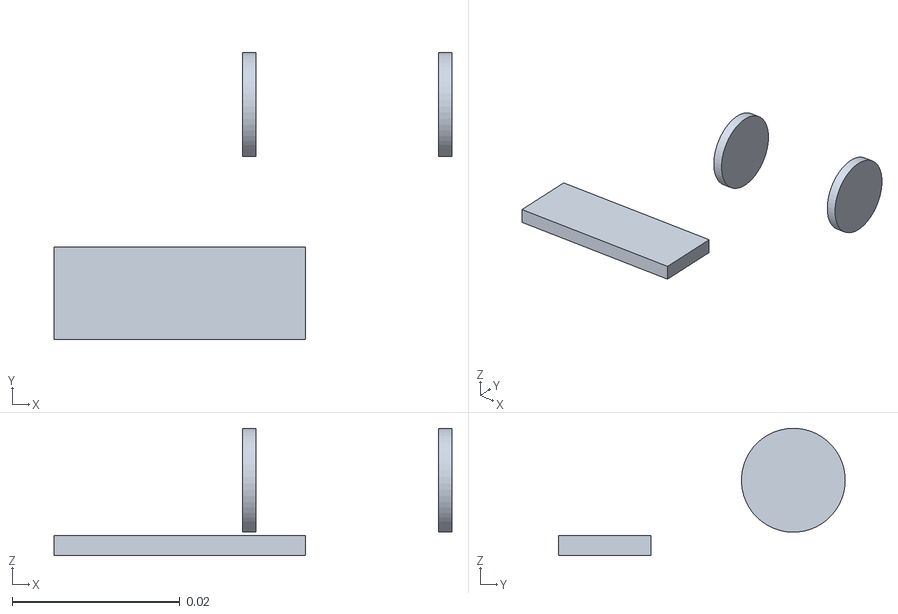
[picture p94: CAD file, 2026-10-26]
simulasi/coppeliasim/mesh/g22.obj
0.0475 x 0.0342 x 0.0152
