Mervs111/Line-Follower-Racer/simulasi/coppeliasim/mesh/g08.obj

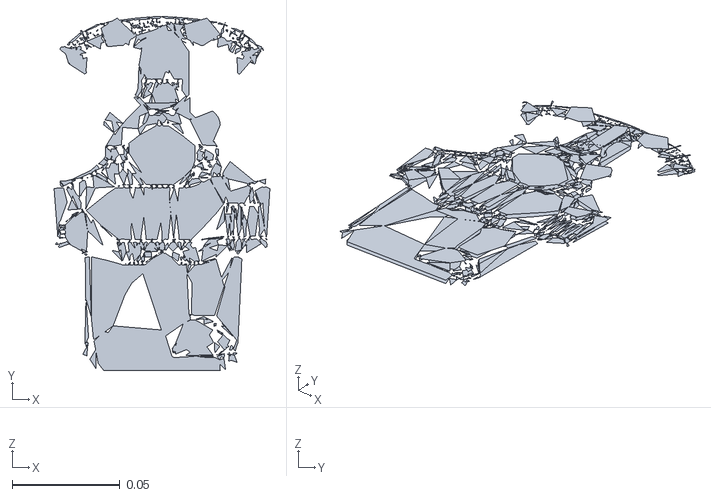
[picture p95: CAD file, 2026-10-26]
simulasi/coppeliasim/mesh/g08.obj
0.1 x 0.164 x 0.0073
