Mervs111/Line-Follower-Racer/simulasi/coppeliasim/mesh/g19.obj

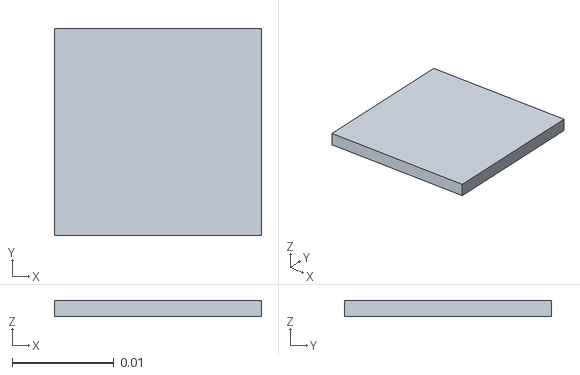
[picture p96: CAD file, 2026-10-26]
simulasi/coppeliasim/mesh/g19.obj
0.0203 x 0.0203 x 0.0016
