Mervs111/Line-Follower-Racer/simulasi/coppeliasim/mesh/g06.obj

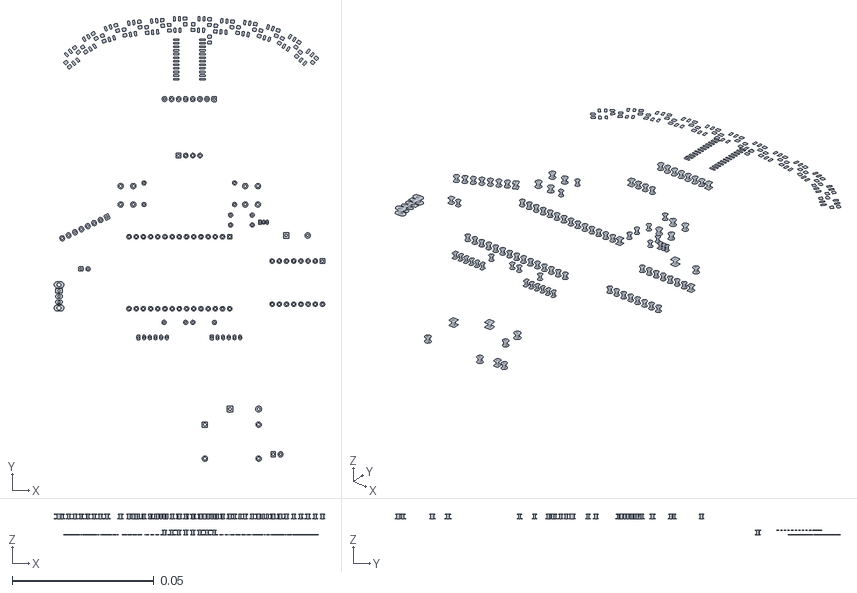
[picture p97: CAD file, 2026-10-26]
simulasi/coppeliasim/mesh/g06.obj
0.0956 x 0.157 x 0.00728
