Mervs111/Line-Follower-Racer/simulasi/coppeliasim/mesh/g01.obj

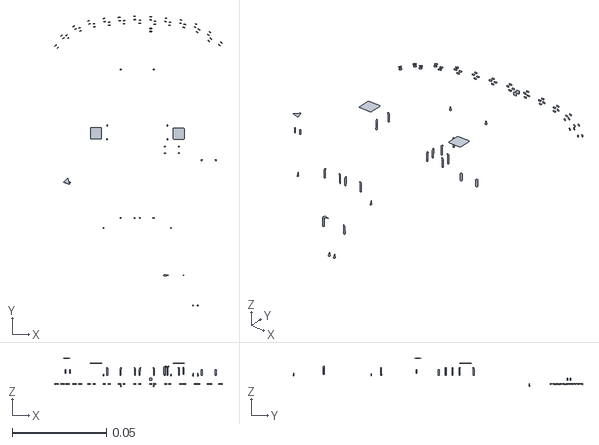
[picture p98: CAD file, 2026-10-26]
simulasi/coppeliasim/mesh/g01.obj
0.0893 x 0.154 x 0.0153
