Mervs111/Line-Follower-Racer/simulasi/coppeliasim/mesh/g21.obj

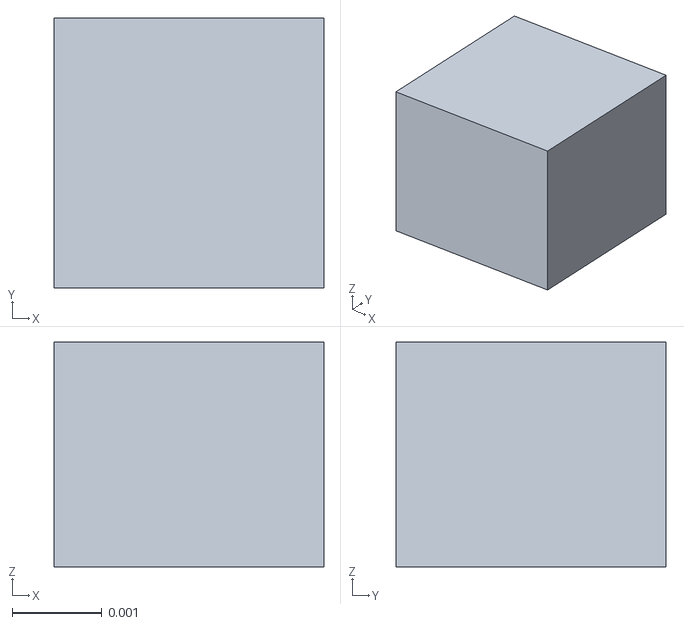
[picture p99: CAD file, 2026-10-26]
simulasi/coppeliasim/mesh/g21.obj
0.003 x 0.003 x 0.0025
