Mervs111/Line-Follower-Racer/simulasi/coppeliasim/mesh/g07.obj

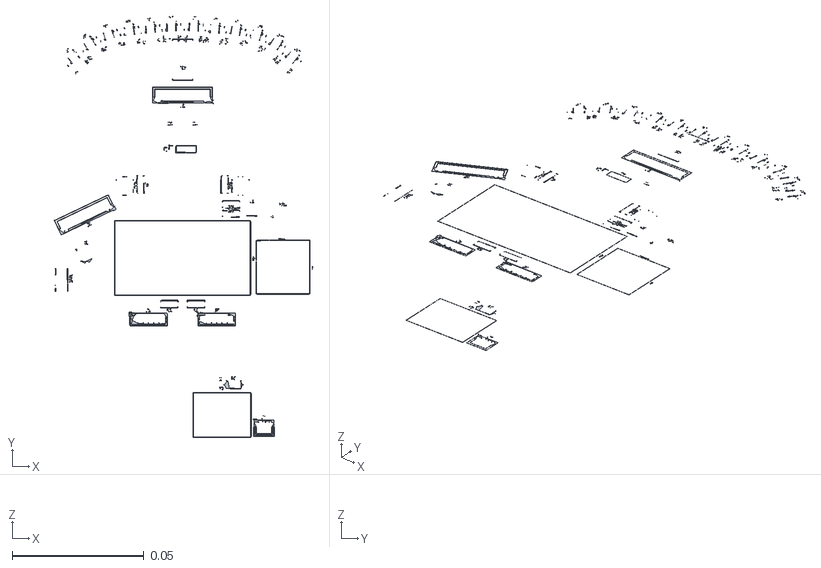
[picture p100: CAD file, 2026-10-26]
simulasi/coppeliasim/mesh/g07.obj
0.0982 x 0.16 x 0.00736
