Mervs111/Line-Follower-Racer/simulasi/coppeliasim/mesh/g00.obj

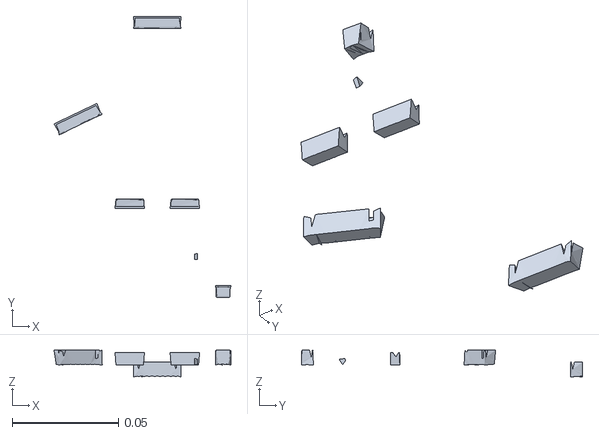
[picture p101: CAD file, 2026-10-26]
simulasi/coppeliasim/mesh/g00.obj
0.0832 x 0.132 x 0.0127
