Mervs111/Line-Follower-Racer/(list of files, cad)

Other CAD files:
arsip/mechanical/LTM_v11.step
arsip/mechanical/v13/dxf/pcb_sensor_outline.dxf
arsip/mechanical/v13/dxf/pcb_sensor_posisi_tcrt5000.dxf
arsip/mechanical/v13/dxf/pcb_utama_outline.dxf
arsip/mechanical/v13/step/LTM_v13_rakitan.step
arsip/mechanical/v13/step/cetak_dudukan_motor_baterai.step
arsip/mechanical/v13/step/cetak_pelindung_cahaya.step
arsip/mechanical/v13/step/cetak_sayap_belakang.step
arsip/mechanical/v13/step/cetak_tiang_sayap.step
arsip/mechanical/v13/step/pcb_sensor.step
arsip/mechanical/v13/step/pcb_utama.step
arsip/mechanical/v13/step/roda_43x19.step
arsip/mechanical/v13/stl/cetak_dudukan_motor_baterai.stl
arsip/mechanical/v13/stl/cetak_pelindung_cahaya.stl
arsip/mechanical/v13/stl/cetak_sayap_belakang.stl
arsip/mechanical/v13/stl/cetak_tiang_sayap.stl
arsip/mechanical/v14/dxf/pcb_sensor_outline.dxf
arsip/mechanical/v14/dxf/pcb_utama_outline.dxf
arsip/mechanical/v14/step/cetak_dudukan_motor_baterai.step
arsip/mechanical/v14/step/cetak_sayap_belakang.step
arsip/mechanical/v14/step/cetak_tiang_sayap.step
arsip/mechanical/v14/step/pcb_sensor.step
arsip/mechanical/v14/step/roda_34x12.step
arsip/mechanical/v14/stl/cetak_dudukan_motor_baterai.stl
arsip/mechanical/v14/stl/cetak_masker_sensor.stl
arsip/mechanical/v14/stl/cetak_tiang_sayap.stl
mechanical/v15/dxf/pcb_sensor_outline.dxf
mechanical/v15/dxf/pcb_sensor_posisi_qre1113.dxf
mechanical/v15/dxf/pcb_utama_outline.dxf
mechanical/v15/step/LTM_v15_rakitan.step
mechanical/v15/step/cetak_dudukan_motor_baterai.step
mechanical/v15/step/cetak_sayap_belakang.step
mechanical/v15/step/cetak_tiang_sayap.step
mechanical/v15/step/pcb_sensor.step
mechanical/v15/step/pcb_utama.step
mechanical/v15/step/roda_34x12.step
mechanical/v16/stl/cetak_dudukan_motor_baterai.stl
mechanical/v16/stl/cetak_sayap_belakang.stl
mechanical/v16/stl/cetak_tiang_sayap.stl
