Mervs111/Line-Follower-Racer/docs/wiring-diagram.html

# Wiring Line Tracer Micro

Urutan gambar skematik di KiCad, dari daya sampai sensor. Kerjakan blok 1 dulu, centang Selesai, lalu lanjut ke blok berikutnya. Versi 22/10/2026: kabel JST XH 8 pin ke PCB sensor bentuk jangkar (rev B), mux I2–I13. 12 sensor QRE1113GR (LED IR + fototransistor dalam satu kemasan SMD), LED selalu nyala, mux berupa IC CD74HC4067 SOIC-24 yang disolder langsung, tanpa MCP23017 (bacaan 12 sensor tampil sebagai bar di OLED).

0 dari 6 blok selesai

1. 1Daya
2. 2Driver motor + motor
3. 3Layar, tombol, buzzer
4. 4Kabel J5 ke J1
5. 5Sensor QRE1113GR (ulangi 12×)
6. 6Multiplexer

### Warna kabel

- VBAT 7,4 V (baterai)
- +5V
- +3V3
- GND
- sinyal ESP32
- I2C (SDA, SCL)
- kabel motor
- jalur LED sensor

### Cara baca

Kotak bulat berwarna (misal +3V3) = net label di KiCad. Nama sama berarti tersambung, jadi nggak perlu tarik kabel panjang. Simbol garis bertingkat = GND. Tanda X = pin dibiarkan kosong.

## Gambaran besar

robot utuh

Listrik mengalir dari baterai ke saklar, lalu dibagi: 5 V untuk ESP32 dan sensor, 7,4 V langsung ke driver motor. ESP32 jadi pusat: semua sinyal (motor, layar, tombol, buzzer, sensor) berangkat atau berakhir di sini.

1

## Daya

PCB utama

Selesai

Baterai dan BMS ada di rangka, masuk ke PCB lewat J1. Setelah saklar namanya VBAT (7,4 V). VBAT dipakai buck (jadi 5 V), driver motor, dan pembaca tegangan baterai di GPIO39.

- Kabel tengah baterai (antara 2 sel) ke kaki BM di BMS.
- D1: garis di badan dioda (katoda) menghadap ke ESP32.

2

## Driver motor + motor

PCB utama

Selesai

7 kabel dari ESP32 ke TB6612. Keluaran AO ke motor kiri, BO ke motor kanan. Encoder tiap motor butuh +3V3, GND, dan 2 pin ESP32.

- Urutan pin modul TB6612 beda-beda tiap penjual, cocokkan nomor pin dengan modul yang dibeli.
- Urutan 6 kabel motor N20 juga beda tiap penjual.

3

## Layar, tombol, buzzer

PCB utama

Selesai

OLED pakai I2C (2 kabel). Tombol menarik pin ke GND saat ditekan, R5/R6 menahan pin di 3,3 V saat dilepas. Buzzer dinyalakan transistor karena pin ESP32 nggak kuat menyalakan buzzer langsung.

- GPIO34/35 nggak punya pull-up di dalam, jadi R5 dan R6 wajib.
- R4 menjaga GPIO12 tetap LOW saat ESP32 baru nyala (syarat boot).
- OLED juga menampilkan 12 bar bacaan sensor, pengganti LED indikator (MCP23017 dihapus 20/10).

4

## Kabel J5 ke J1 (JST XH 8 pin)

kedua PCB

Selesai

J5 (PCB utama) dan J1 (PCB sensor) sama-sama konektor JST XH 8 pin dengan urutan pin yang sama persis, disambung kabel lurus: pin 1 ke pin 1 sampai pin 8 ke pin 8. Pin 1–3 daya, pin 4–8 sinyal mux.

- Di KiCad pakai simbol Conn_01x08 dan footprint JST_XH_B8B-XH-A_1x08_P2.50mm_Vertical. Pin 1 = pad kotak.
- Urutan ini mengikuti skematik PCB sensor (J1). J5 di PCB utama wajib sama: kalau tertukar, +5V bisa masuk ke jalur +3V3 dan merusak mux.
- Pin 4–7 urutannya terbalik dari nama (MUX_S3 dulu, MUX_S0 terakhir). Ikuti nomor pin, bukan urutan nama.
- Kabel: 2 housing XH 8 pin + 16 terminal, di-crimp lurus (kabel yang sama masuk ke pin 1 di kedua ujung).
- Pasang PWR_FLAG di +5V, +3V3, dan GND skematik PCB sensor (dayanya datang dari kabel).

5

## Sensor QRE1113GR (ulangi 12×)

PCB sensor · sisi bawah

Selesai

Tiap sensor = 1 QRE1113GR di sisi bawah PCB menghadap lantai: di dalamnya ada LED IR (pin 1–2) yang selalu nyala, arusnya dibatasi R 220 Ω, dan fototransistor (pin 3–4). Kolektor (pin 3) ditarik ke +3V3 lewat 10k, emitor (pin 4) ke GND. Titik antara resistor 10k dan pin 3 itu keluaran sensor (S1–S12) yang masuk ke mux.

- Pull-up harus ke +3V3, bukan 5 V, karena keluaran sensor masuk ke ESP32.
- Urutan pin sama dengan simbol QRE1113GR di KiCad: 1 anoda, 2 katoda, 3 kolektor, 4 emitor. Cek tanda pin 1 di badan sensor dan gambar footprint di datasheet onsemi sebelum menyolder.
- LED IR nggak kelihatan mata. Untuk cek nyala, lihat lewat kamera HP.
- R2 10k titik awal. Coba 10k sampai 47k di breadboard sampai beda garis hitam dan putih paling jelas.
- Arus LED ±17 mA per sensor (R 220 Ω), total ±210 mA dari +5V. Boleh 150 Ω (±25 mA) kalau bacaan kurang kuat; batas LED 50 mA.
- Footprint: badan 2,9 × 3,6 mm, muka sensor ±3 mm dari lantai. Rev B: 12 sensor jarak 8 mm di busur, koordinatnya di hardware/sensor-garis/REVISI.md. R 10k di kiri dan R 220 Ω di kanan tiap sensor (2,85 mm dari tengahnya), ikut diputar mengikuti busur.

6

## Multiplexer

PCB sensor

Selesai

IC mux CD74HC4067 (SOIC-24, simbol KiCad CD74HC4067M) disolder langsung di badan tengah PCB sensor. 12 sinyal sensor masuk ke I2–I13. ESP32 memilih sensor lewat S0–S3, lalu membaca hasilnya di COM (pin 1) lewat GPIO36.

- I2 = S1, I3 = S2, terus berurutan sampai I13 = S12 (sesuai skematik). Di firmware: kanal mux = nomor sensor + 1.
- Nomor pin IC nggak urut: I0–I7 di pin 9 sampai 2, I8–I15 di pin 23 sampai 16. Jadi S1–S6 di pin 7 sampai 2, S7–S12 di pin 23 sampai 18.
- Awas, S2 di pin 14 dan S3 di pin 13 (kebalik dari urutan nama).
- I0, I1, I14, I15 (pin 9, 8, 17, 16) nggak dipakai: kasih tanda X. Firmware nggak pernah memilih kanal itu.
- C1 100 nF ditaruh sedekat mungkin dengan pin 24 dan pin 12.
- VCC harus +3V3, bukan 5 V, karena COM masuk ke ADC ESP32.
- Footprint SOIC-24W_7.5x15.4mm_P1.27mm (badan 7,5 mm). Jangan pilih SSOP-24, itu versi yang jauh lebih kecil.
- Kaki berjarak 1,27 mm: pakai jalur 0,3 mm, sesuai batas tempat cetak (lihat docs/aturan-cetak-pcb.md).
- Label jalur pemilih pakai nama MUX_S0–MUX_S3, jangan S0–S3. Kalau dinamai S1, jalurnya nyambung ke sensor S1.
