Mervs111/Line-Follower-Racer/docs/logbook/README.md

# Logbook / Laporan Mingguan

Format mengikuti template resmi departemen ("Template Logbook - Laporan Mingguan").
Satu file per minggu: `minggu-XX.md` (contoh `minggu-06.md`), lalu disalin ke template Word.

## Kop (tetap)

- Electrical Automation Engineering Department, Vocational Faculty, ITS Surabaya
- Project-based Learning Semester ... (lihat catatan di bawah)
- WEEKLY REPORT / LOGBOOK

## Isi template

### 1. Project Identity

| | |
|---|---|
| Project Name | Line Follower Microcontroller |
| Supervisor | Fira Aulia, S.Tr.T, M.Tr.T |
| Team Member | 1. Mararevi Subagyo (Project Manager) — 2040241036 |
| | 2. Fernandy Raditya Wardhana — 2040241007 |
| | 3. Achmad Iqbal Adiputra — 2040241121 |
| | 4. Adhityanoval Dewa Mahendra — 2040241085 |
| Week / Date | Week ? / ? |

### 2. Weekly Report Description

Kegiatan selama 1 minggu sesuai tanggal. Ditulis **per poin**, tiap poin ada
**penjelasan singkat**. Kalau ada gambar/tabel, beri **keterangan dan penjelasan**.

### 3. Obstacle(s)

Kendala yang dihadapi dan **belum terselesaikan** selama pengerjaan.

### 4. Documentation

Dokumentasi mingguan (foto/screenshot kegiatan), masing-masing dengan keterangan.

## Catatan konsistensi

- Template tertulis "Semester Genap 2025-2026", sedangkan project charter
  "Semester Ganjil 2026-2027". Pastikan yang benar sebelum dikumpulkan.
- Nama proyek di template: "Line Follower Microcontroller"; di charter:
  "Robot Line Tracer Micro". Sebaiknya diseragamkan.
- Isi kegiatan harus sejalan dengan milestone di project charter.
