Mervs111/Line-Follower-Racer/hardware/ltm-main.pdf

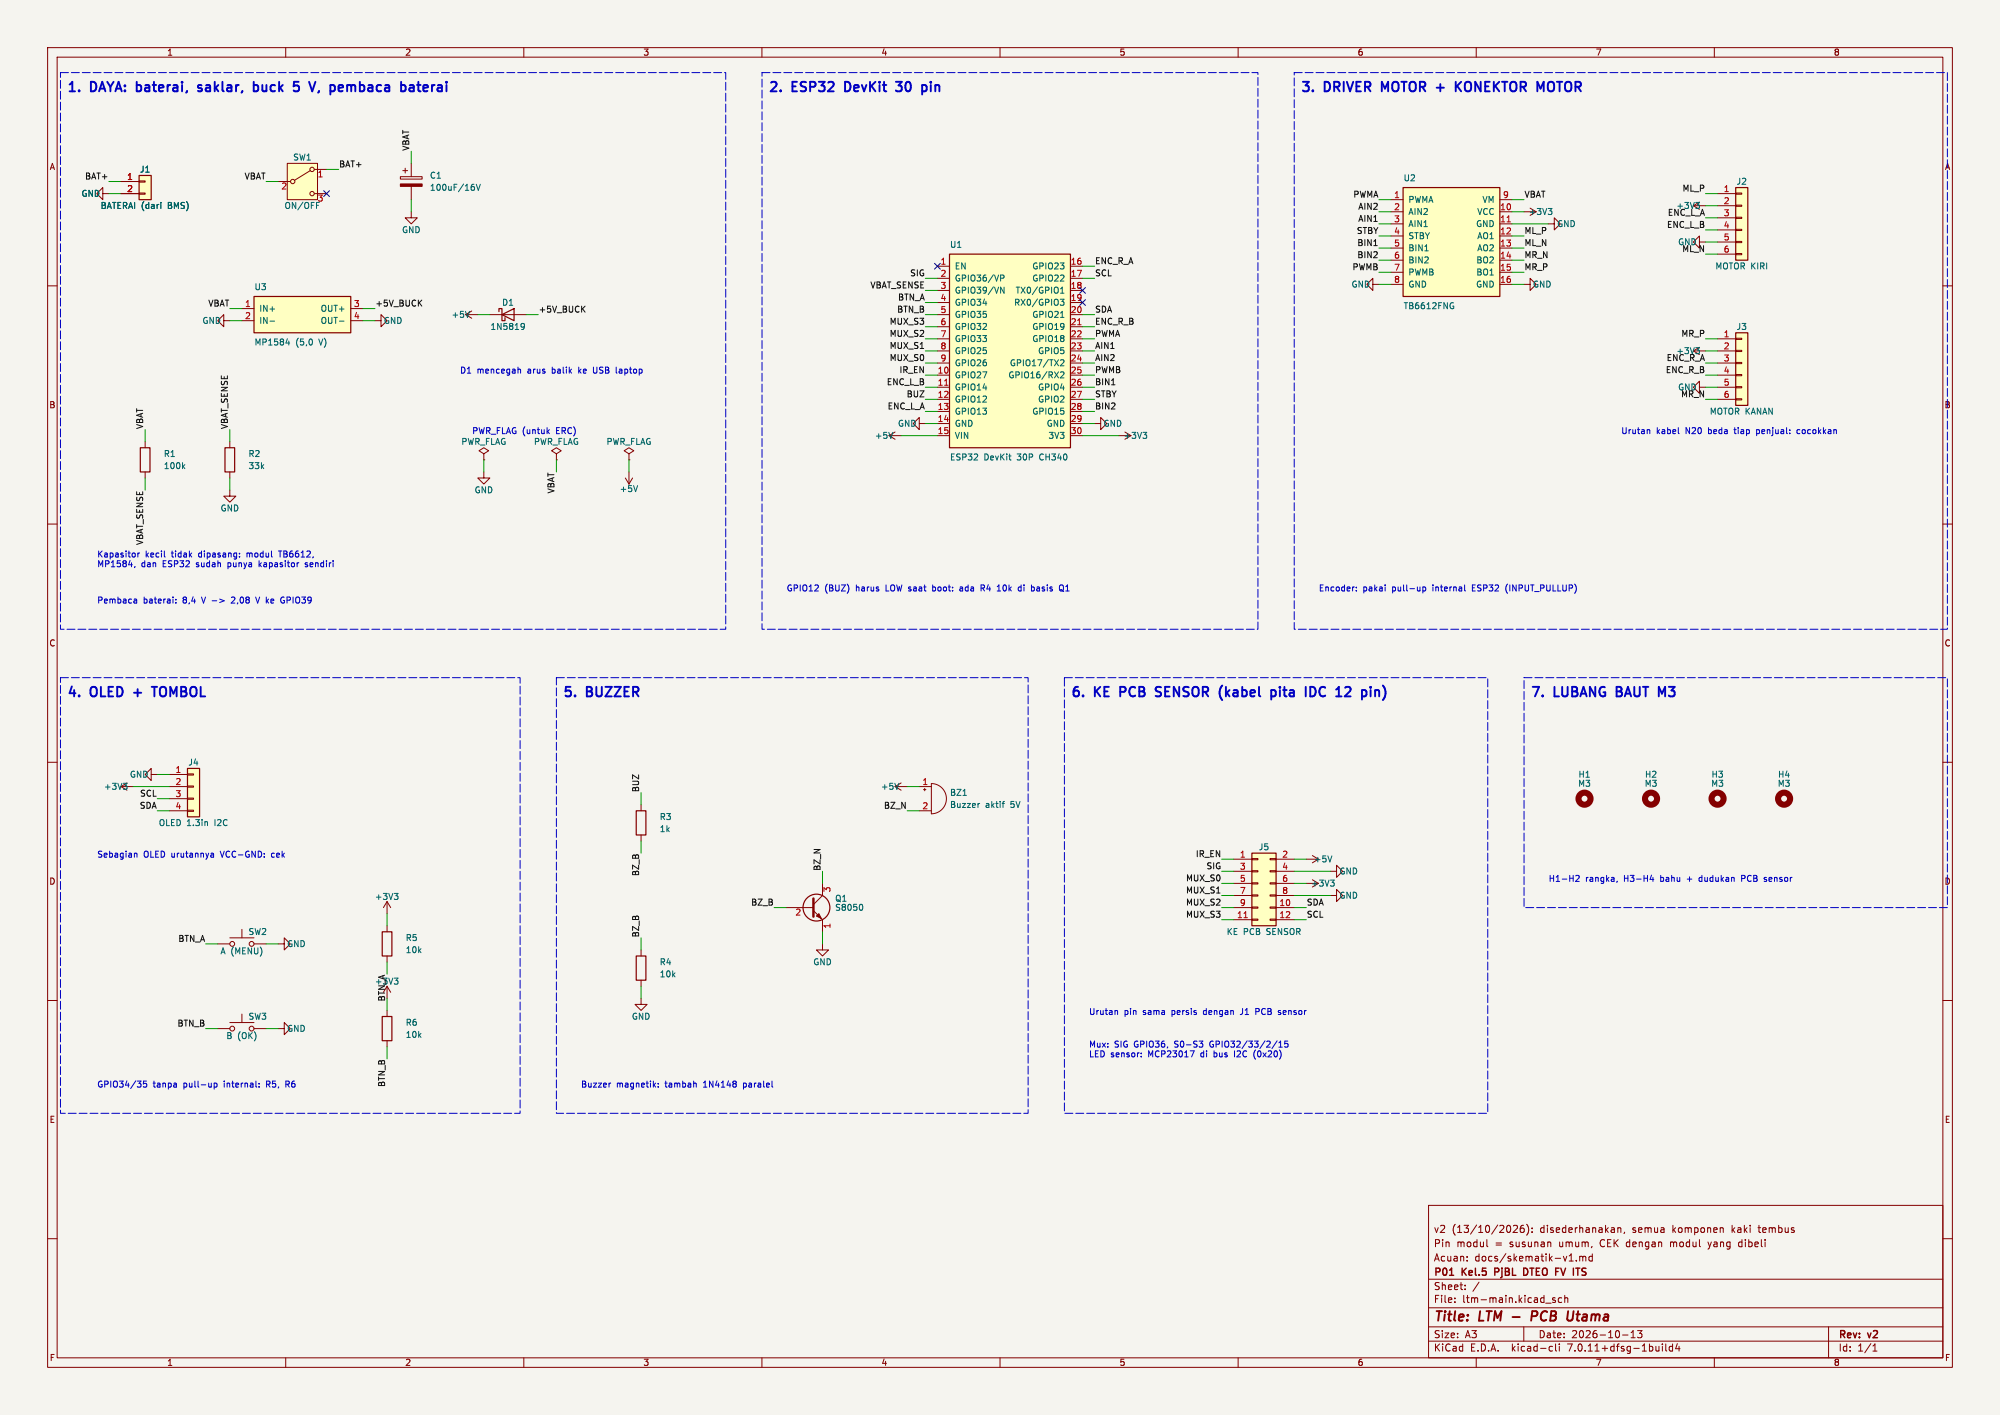
[picture p102: page 1]

3. DRIVER MOTOR + KONEKTOR MOTOR

Urutan pin sama persis dengan J1 PCB sensor

LED sensor: MCP23017 di bus I2C (0x20)

Id: 1/1 Title: LTM - PCB Utama
