Mervs111/Line-Follower-Racer/hardware/board-interface/board-interface-skematik.pdf

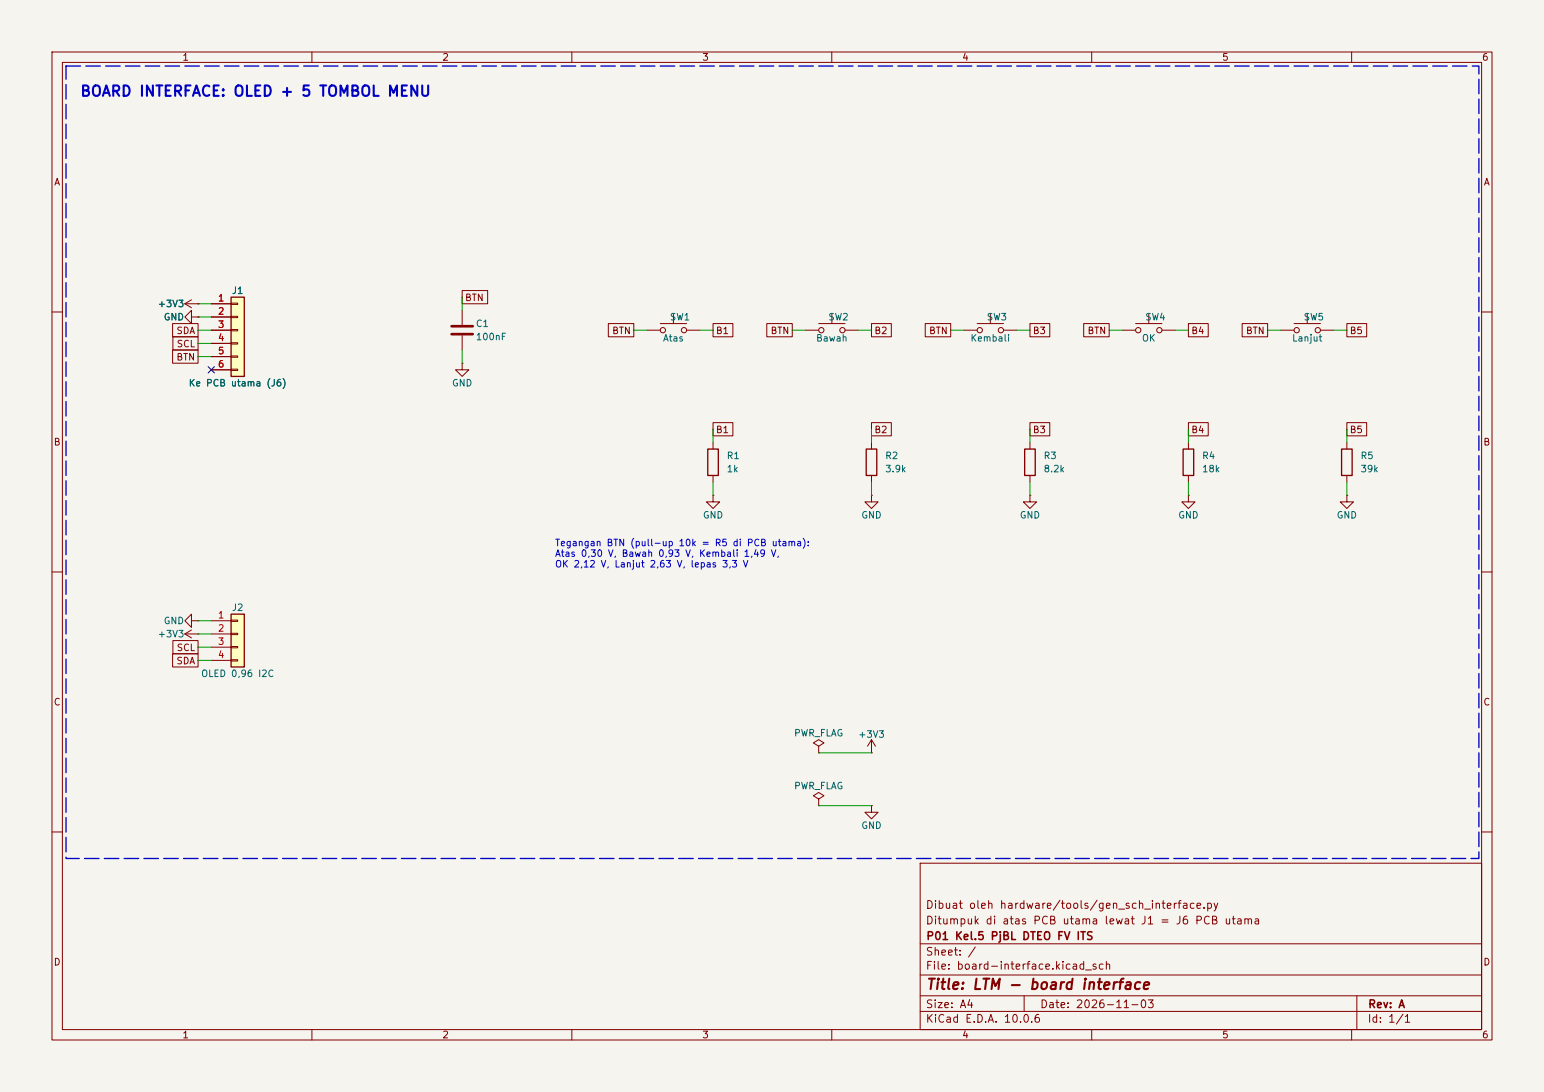
[picture p103: page 1]

Tegangan BTN (pull-up 10k = R5 di PCB utama): Atas 0,30 V, Bawah 0,93 V, Kembali 1,49 V, OK 2,12 V, Lanjut 2,63 V, lepas 3,3 V GND +3V3

Dibuat oleh hardware/tools/gen_sch_interface.py R1

Ditumpuk di atas PCB utama lewat J1 = J6 PCB utama
P01 Kel.5 PjBL DTEO FV ITS
Sheet: /
File: board-interface.kicad_sch
Title: LTM - board interface

Size: A4 | Rev: A
KiCad E.D.A. 10.0.6 | Id: 1/1
