Mervs111/Line-Follower-Racer/hardware/pcb-utama/pcb-utama-skematik.pdf

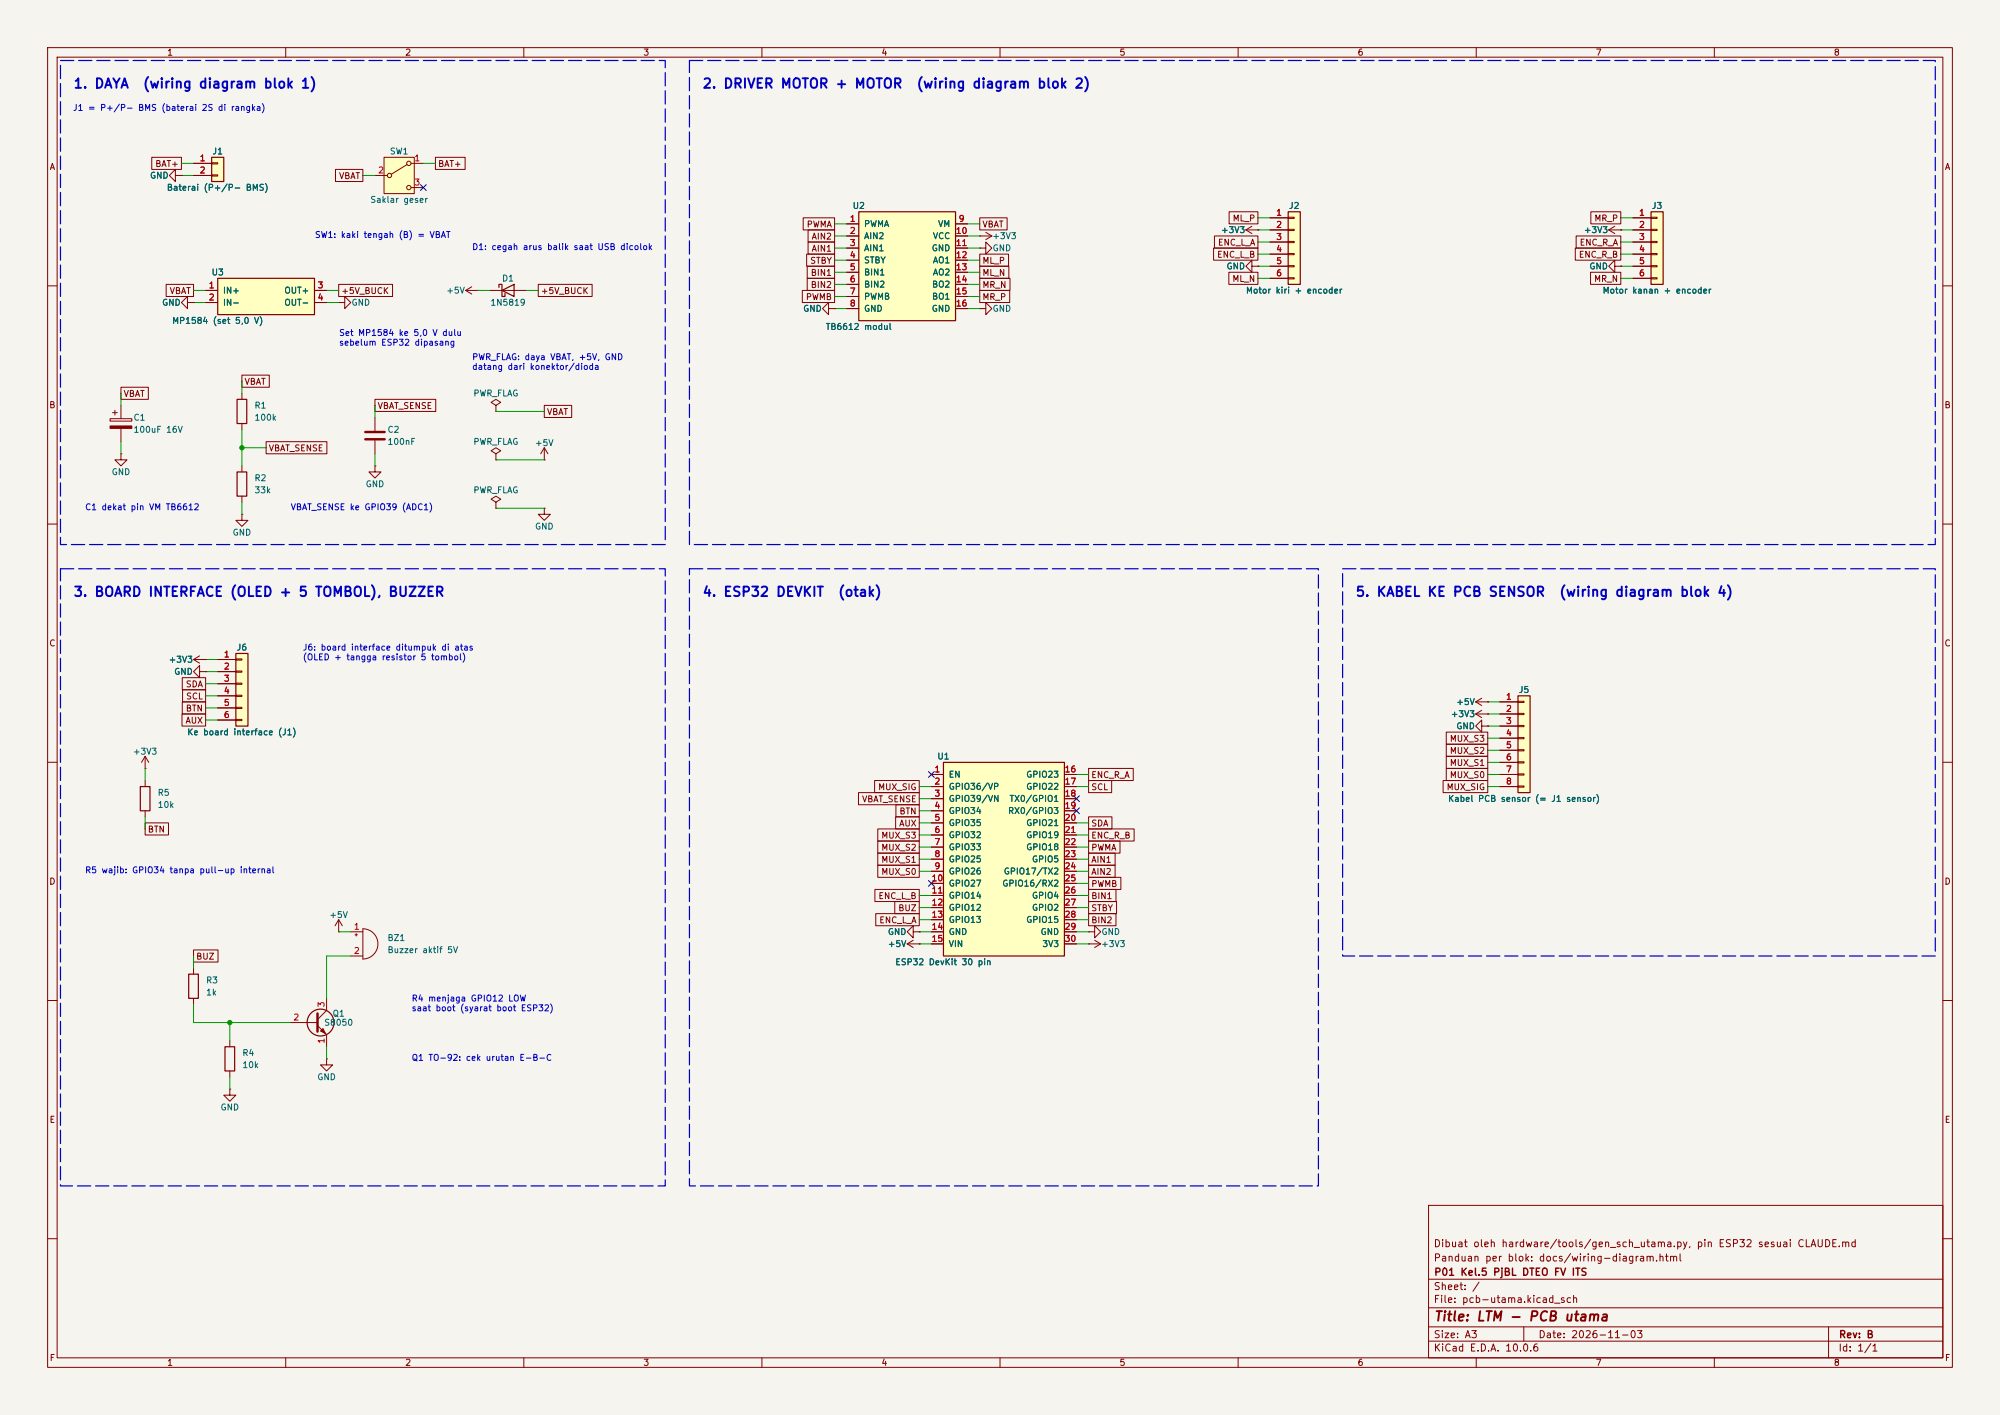
[picture p104: page 1]

J1 = P+/P- BMS (baterai 2S di rangka)
2 GND
GND

(OLED + tangga resistor 5 tombol) Set MP1584 ke 5,0 V dulu

D1: cegah arus balik saat USB dicolok U3 MP1584 (set 5,0 V)

datang dari konektor/dioda C1 dekat pin VM TB6612

VBAT_SENSE ke GPIO39 (ADC1) R5 wajib: GPIO34 tanpa pull-up internal

3. BOARD INTERFACE (OLED + 5 TOMBOL), BUZZER

5. KABEL KE PCB SENSOR (wiring diagram blok 4)

J6: board interface ditumpuk di atas

J5 Kabel PCB sensor (= J1 sensor)

J5 Kabel PCB sensor (= J1 sensor) 1

R4 menjaga GPIO12 LOW
saat boot (syarat boot ESP32)

Dibuat oleh hardware/tools/gen_sch_utama.py, pin ESP32 sesuai CLAUDE.md
Panduan per blok: docs/wiring-diagram.html
P01 Kel.5 PjBL DTEO FV ITS
Sheet: /
File: pcb-utama.kicad_sch
Title: LTM - PCB utama

Size: A3 | Rev: B | F Date: 2026-11-03
KiCad E.D.A. 10.0.6 | Id: 1/1
