Mervs111/Line-Follower-Racer/arsip/hardware/ltm-sensor.pdf

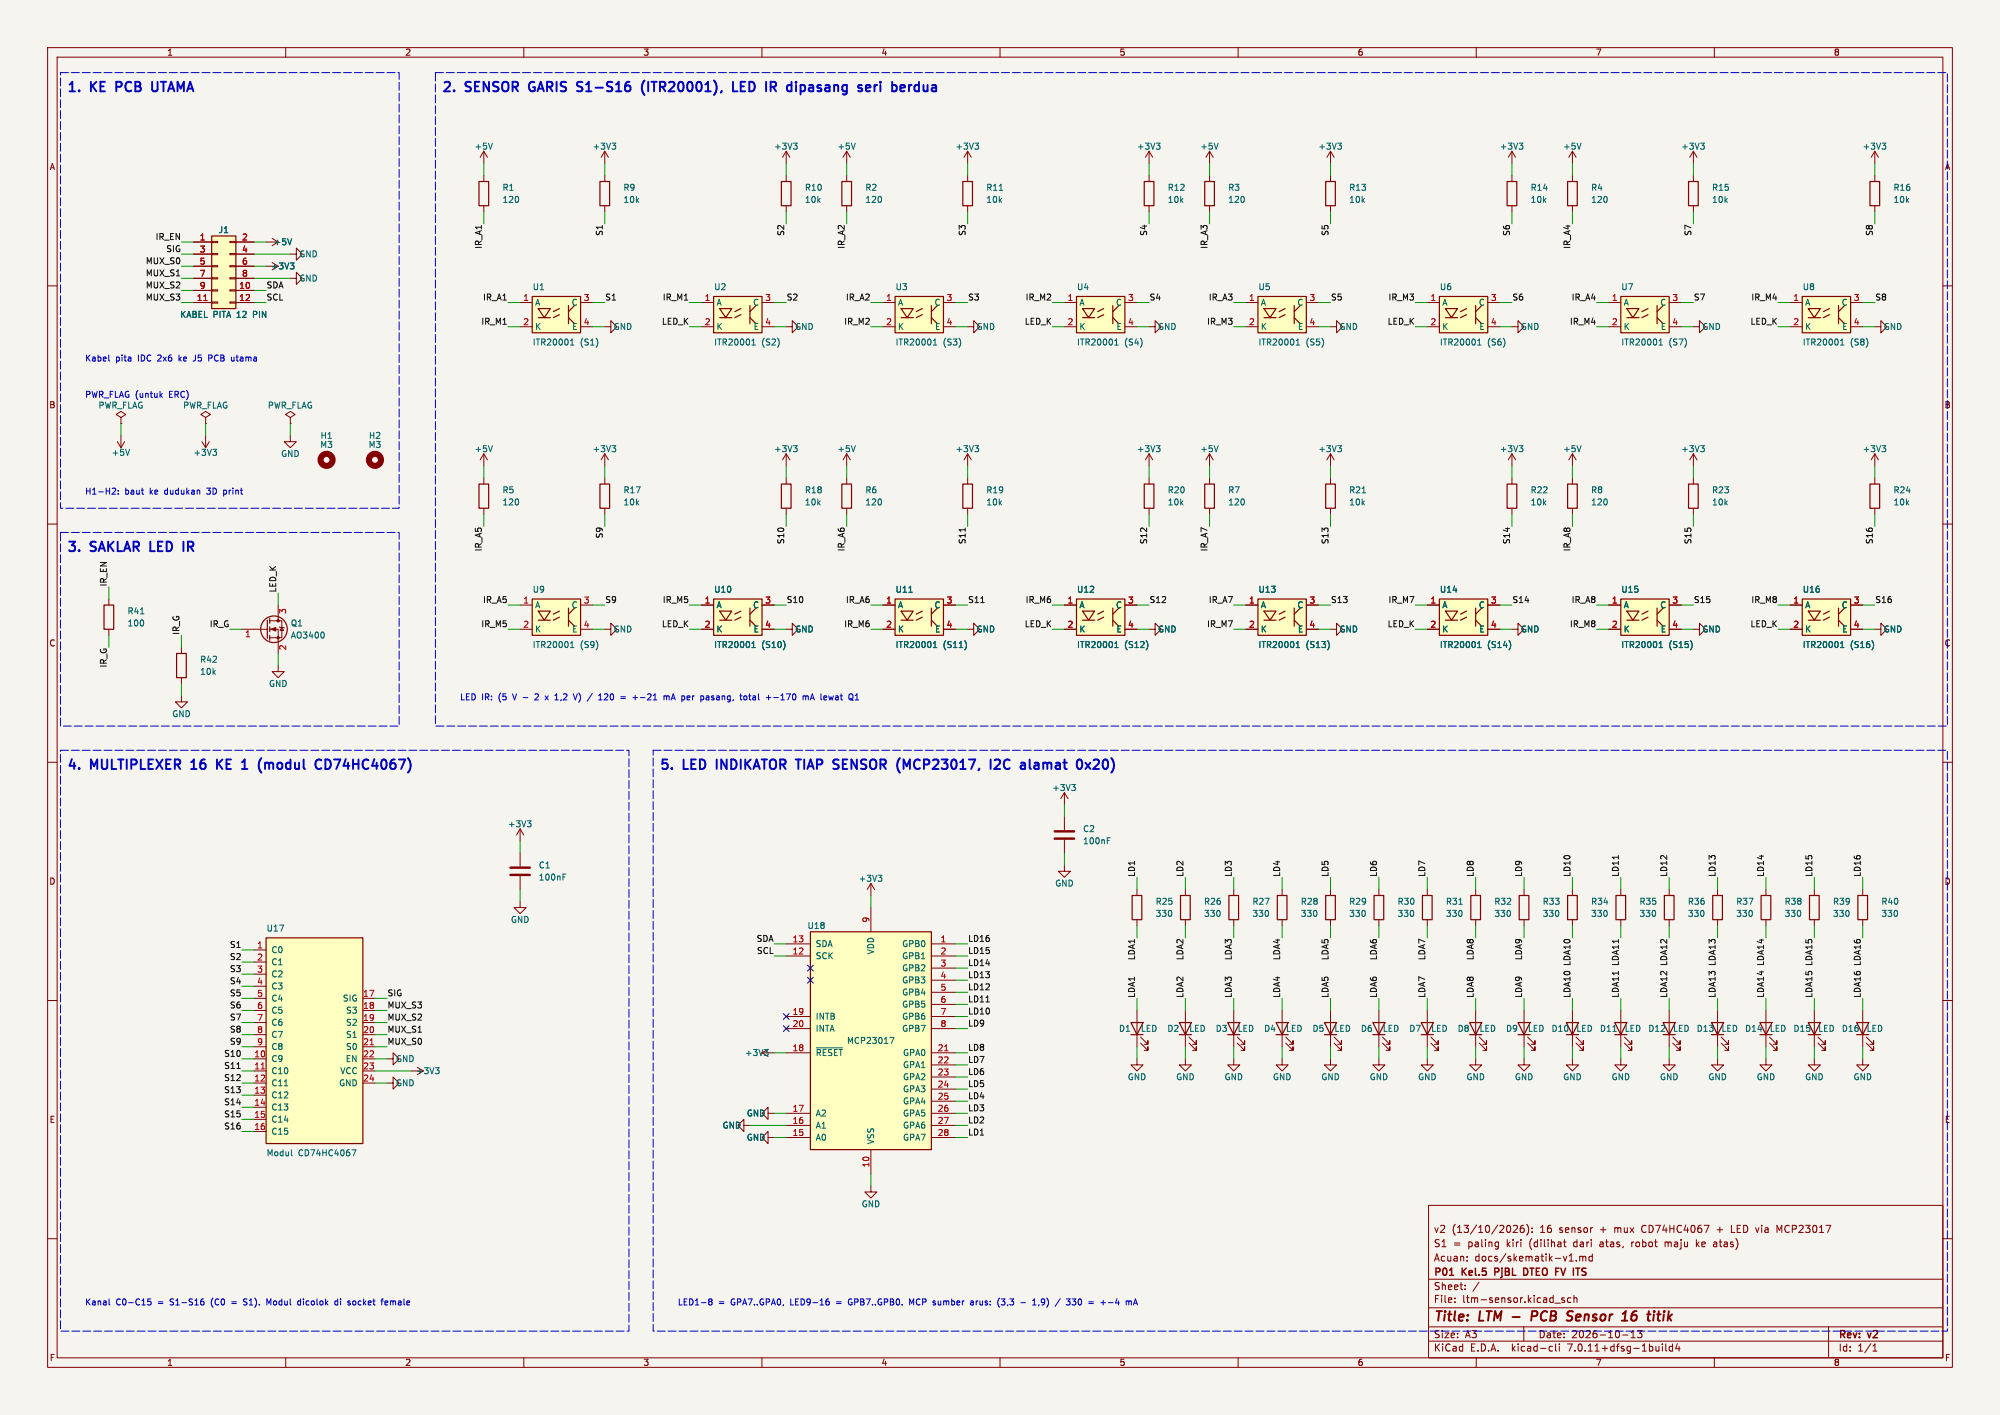
[picture p105: page 1]

Id: 1/1 Title: LTM - PCB Sensor 16 titik
