Mervs111/Line-Follower-Racer/(list of files, drawings)

Other design files:
hardware/pcb-utama/routing/pcb-utama-revB.dsn
