Mervs111/Line-Follower-Racer/hardware/pcb-utama/pcb-utama.kicad_pcb

## KiCad design hardware/pcb-utama/pcb-utama.kicad_pcb (2026-11-03)

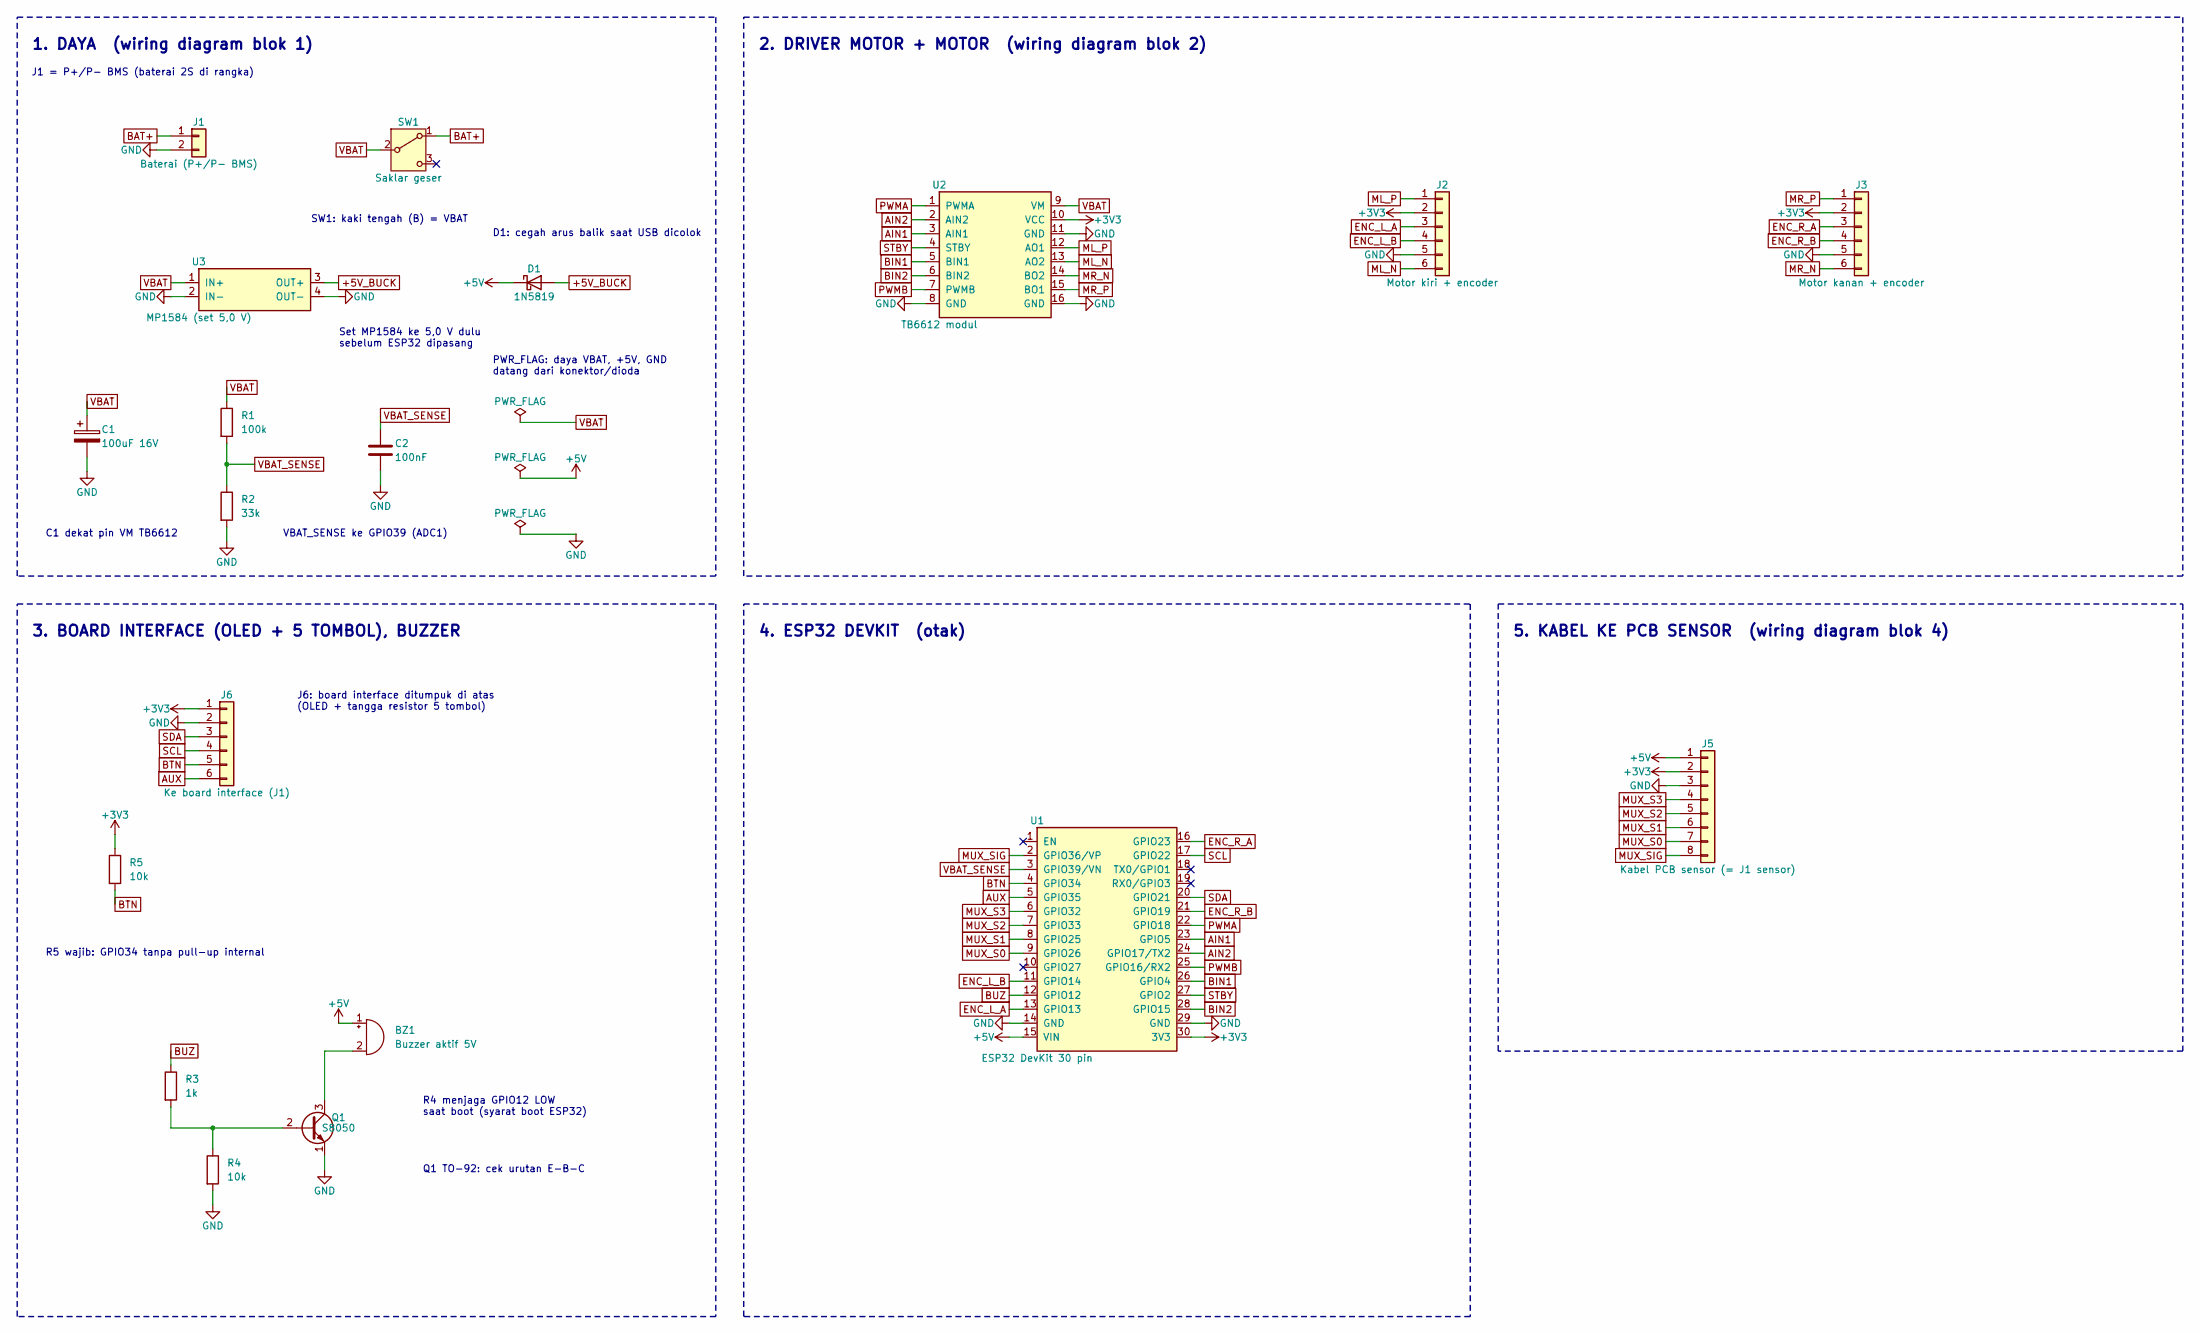
[picture p106: schematic pcb-utama.kicad_sch, LTM - PCB utama]

Parts:
BZ1: Buzzer aktif 5V; Buzzer_12x9.5RM7.6
C1: 100uF 16V; CP_Radial_D6.3mm_P2.50mm
C2: 100nF; C_Disc_D5.0mm_W2.5mm_P5.00mm
D1: 1N5819; D_DO-41_SOD81_P10.16mm_Horizontal
J1: Baterai (P+/P- BMS); JST_XH_B2B-XH-A_1x02_P2.50mm_Vertical
J2: Motor kiri + encoder; JST_XH_B6B-XH-A_1x06_P2.50mm_Vertical
J3: Motor kanan + encoder; JST_XH_B6B-XH-A_1x06_P2.50mm_Vertical
J5: Kabel PCB sensor (= J1 sensor); JST_XH_B8B-XH-A_1x08_P2.50mm_Vertical
J6: Ke board interface (J1); PinSocket_1x06_P2.54mm_Vertical
Q1: S8050; TO-92_Inline_Wide
R1: 100k; R_Axial_DIN0207_L6.3mm_D2.5mm_P7.62mm_Horizontal
R2: 33k; R_Axial_DIN0207_L6.3mm_D2.5mm_P7.62mm_Horizontal
R3: 1k; R_Axial_DIN0207_L6.3mm_D2.5mm_P7.62mm_Horizontal
R4, R5: 10k; R_Axial_DIN0207_L6.3mm_D2.5mm_P7.62mm_Horizontal
SW1: Saklar geser; SW_Slide_SPDT_Angled_CK_OS102011MA1Q
U1: ESP32 DevKit 30 pin; ESP32_DevKit_30P_W25.4
U2: TB6612 modul; TB6612_Module_2x8_W15.24
U3: MP1584 (set 5,0 V); MP1584_Module

Connections:
+3V3: J2.2, J3.2, J5.2, J6.1, R5.1, U1.30 (3V3), U2.10 (VCC)
+5V: BZ1.1 (+), D1.1 (K), J5.1, U1.15 (VIN)
+5V_BUCK: D1.2 (A), U3.3 (OUT+)
AIN1: U1.23 (GPIO5), U2.3 (AIN1)
AIN2: U1.24 (GPIO17/TX2), U2.2 (AIN2)
AUX: J6.6, U1.5 (GPIO35)
BAT+: J1.1, SW1.1 (A)
BIN1: U1.26 (GPIO4), U2.5 (BIN1)
BIN2: U1.28 (GPIO15), U2.6 (BIN2)
BTN: J6.5, R5.2, U1.4 (GPIO34)
BUZ: R3.1, U1.12 (GPIO12)
ENC_L_A: J2.3, U1.13 (GPIO13)
ENC_L_B: J2.4, U1.11 (GPIO14)
ENC_R_A: J3.3, U1.16 (GPIO23)
ENC_R_B: J3.4, U1.21 (GPIO19)
GND: C1.2, C2.2, J1.2, J2.5, J3.5, J5.3, J6.2, Q1.1 (E), R2.2, R4.2, U1.14 (GND), U1.29 (GND), U2.8 (GND), U2.11 (GND), U2.16 (GND), U3.2 (IN-), U3.4 (OUT-)
ML_N: J2.6, U2.13 (AO2)
ML_P: J2.1, U2.12 (AO1)
MR_N: J3.6, U2.14 (BO2)
MR_P: J3.1, U2.15 (BO1)
MUX_S0: J5.7, U1.9 (GPIO26)
MUX_S1: J5.6, U1.8 (GPIO25)
MUX_S2: J5.5, U1.7 (GPIO33)
MUX_S3: J5.4, U1.6 (GPIO32)
MUX_SIG: J5.8, U1.2 (GPIO36/VP)
unnamed: BZ1.2 (-), Q1.3 (C)
unnamed: Q1.2 (B), R3.2, R4.1
PWMA: U1.22 (GPIO18), U2.1 (PWMA)
PWMB: U1.25 (GPIO16/RX2), U2.7 (PWMB)
SCL: J6.4, U1.17 (GPIO22)
SDA: J6.3, U1.20 (GPIO21)
STBY: U1.27 (GPIO2), U2.4 (STBY)
VBAT: C1.1, R1.1, SW1.2 (B), U2.9 (VM), U3.1 (IN+)
VBAT_SENSE: C2.1, R1.2, R2.1, U1.3 (GPIO39/VN)

Notes on the sheet:
1. DAYA (wiring diagram blok 1)
PWR_FLAG: daya VBAT, +5V, GND datang dari konektor/dioda
J1 = P+/P- BMS (baterai 2S di rangka)
SW1: kaki tengah (B) = VBAT
Set MP1584 ke 5,0 V dulu sebelum ESP32 dipasang
D1: cegah arus balik saat USB dicolok
C1 dekat pin VM TB6612
VBAT_SENSE ke GPIO39 (ADC1)
2. DRIVER MOTOR + MOTOR (wiring diagram blok 2)
3. BOARD INTERFACE (OLED + 5 TOMBOL), BUZZER
J6: board interface ditumpuk di atas (OLED + tangga resistor 5 tombol)
R5 wajib: GPIO34 tanpa pull-up internal
R4 menjaga GPIO12 LOW saat boot (syarat boot ESP32)
Q1 TO-92: cek urutan E-B-C
4. ESP32 DEVKIT (otak)
5. KABEL KE PCB SENSOR (wiring diagram blok 4)

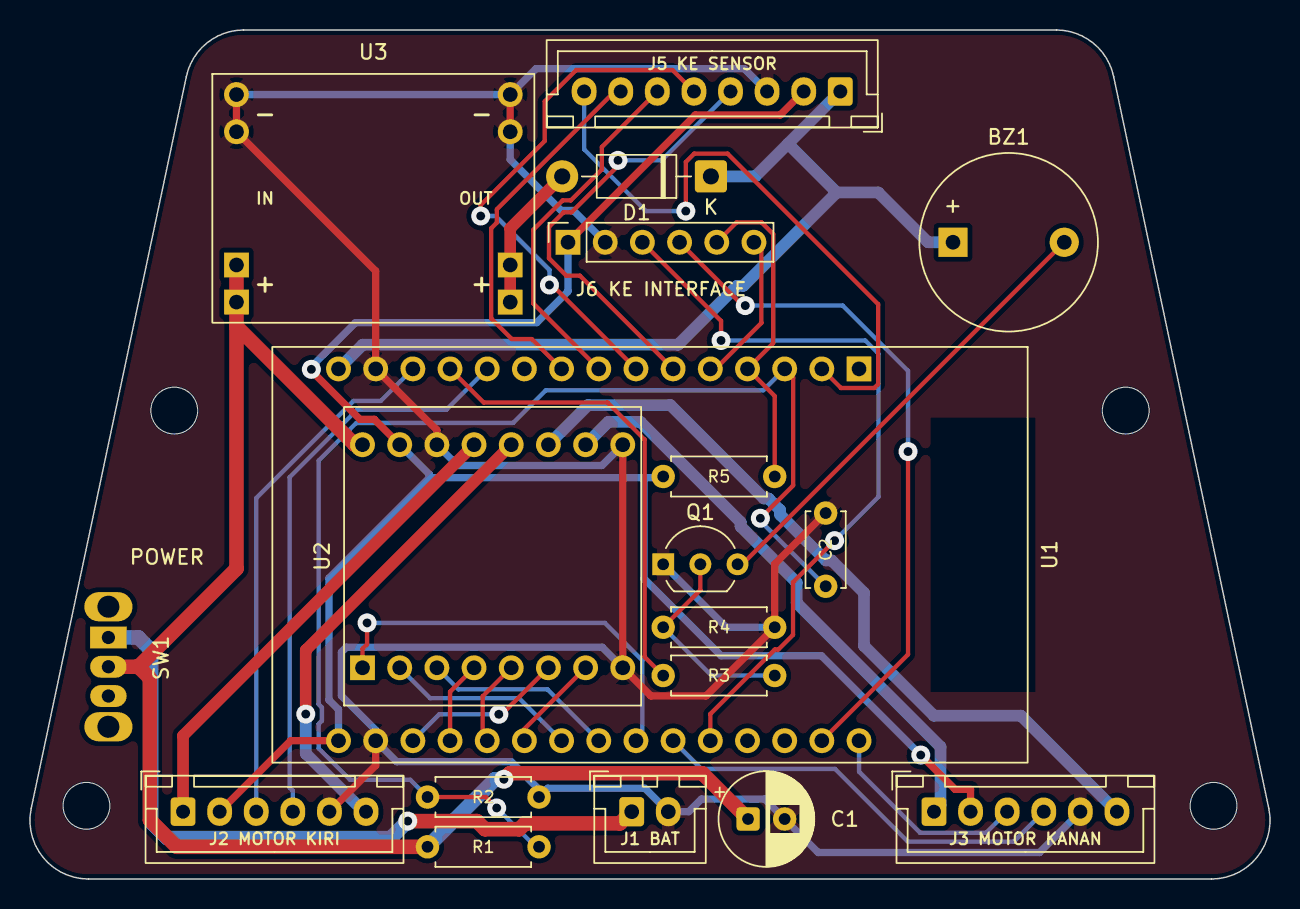
[picture p107: board pcb-utama.kicad_pcb from above]

Board: 2 copper layers, 84.7 x 58.0 mm, 23 parts (0 on the bottom side), 34 nets.

Other parts of the board:
H1, H2, H3, H4: M3; MountingHole_3.2mm_M3
