Mervs111/Line-Follower-Racer/hardware/board-interface/board-interface.kicad_pcb

## KiCad design hardware/board-interface/board-interface.kicad_pcb (2026-11-03)

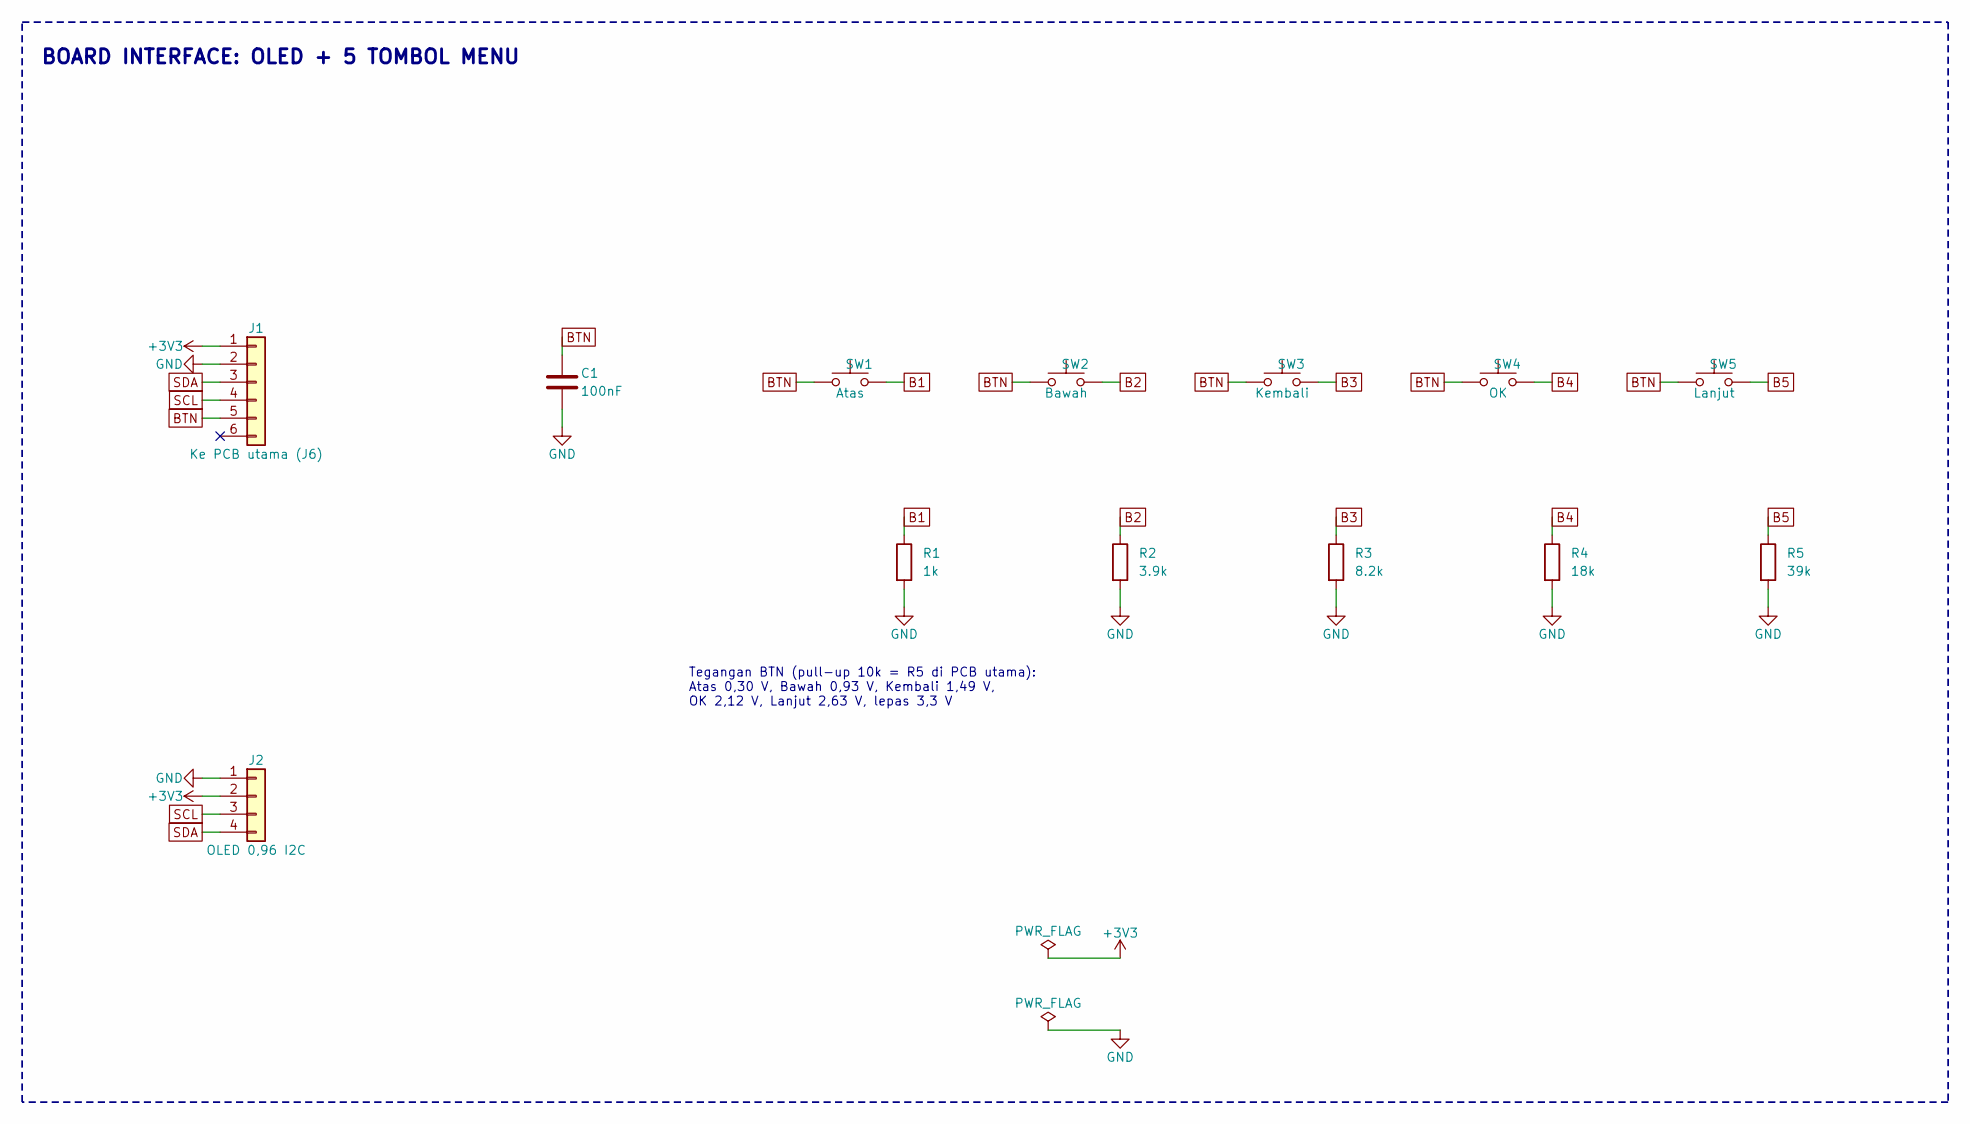
[picture p108: schematic board-interface.kicad_sch, LTM - board interface]

Parts:
C1: 100nF; C_Disc_D5.0mm_W2.5mm_P5.00mm
J1: Ke PCB utama (J6); PinHeader_1x06_P2.54mm_Vertical
J2: OLED 0,96 I2C; PinSocket_1x04_P2.54mm_Vertical
R1: 1k; R_Axial_DIN0207_L6.3mm_D2.5mm_P7.62mm_Horizontal
R2: 3.9k; R_Axial_DIN0207_L6.3mm_D2.5mm_P7.62mm_Horizontal
R3: 8.2k; R_Axial_DIN0207_L6.3mm_D2.5mm_P7.62mm_Horizontal
R4: 18k; R_Axial_DIN0207_L6.3mm_D2.5mm_P7.62mm_Horizontal
R5: 39k; R_Axial_DIN0207_L6.3mm_D2.5mm_P7.62mm_Horizontal
SW1: Atas; SW_PUSH_6mm
SW2: Bawah; SW_PUSH_6mm
SW3: Kembali; SW_PUSH_6mm
SW4: OK; SW_PUSH_6mm
SW5: Lanjut; SW_PUSH_6mm

Connections:
+3V3: J1.1, J2.2
B1: R1.1, SW1.2
B2: R2.1, SW2.2
B3: R3.1, SW3.2
B4: R4.1, SW4.2
B5: R5.1, SW5.2
BTN: C1.1, J1.5, SW1.1, SW2.1, SW3.1, SW4.1, SW5.1
GND: C1.2, J1.2, J2.1, R1.2, R2.2, R3.2, R4.2, R5.2
SCL: J1.4, J2.3
SDA: J1.3, J2.4

Notes on the sheet:
BOARD INTERFACE: OLED + 5 TOMBOL MENU
Tegangan BTN (pull-up 10k = R5 di PCB utama): Atas 0,30 V, Bawah 0,93 V, Kembali 1,49 V, OK 2,12 V, Lanjut 2,63 V, lepas 3,3 V

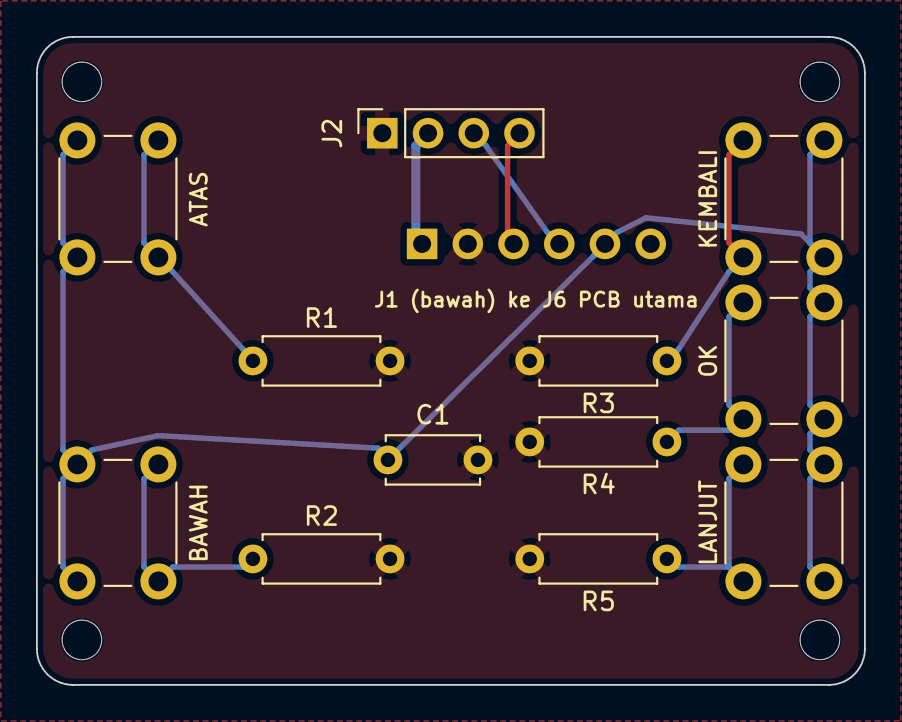
[picture p109: board board-interface.kicad_pcb from above]

Board: 2 copper layers, 46.0 x 36.0 mm, 17 parts (1 on the bottom side), 10 nets.

Other parts of the board:
H1, H2, H3, H4: M2; MountingHole_2.2mm_M2
