Mervs111/Line-Follower-Racer/arsip/hardware/ltm-sensor/ltm-sensor.kicad_pcb

## KiCad design arsip/hardware/ltm-sensor/ltm-sensor.kicad_pcb (2026-10-14)

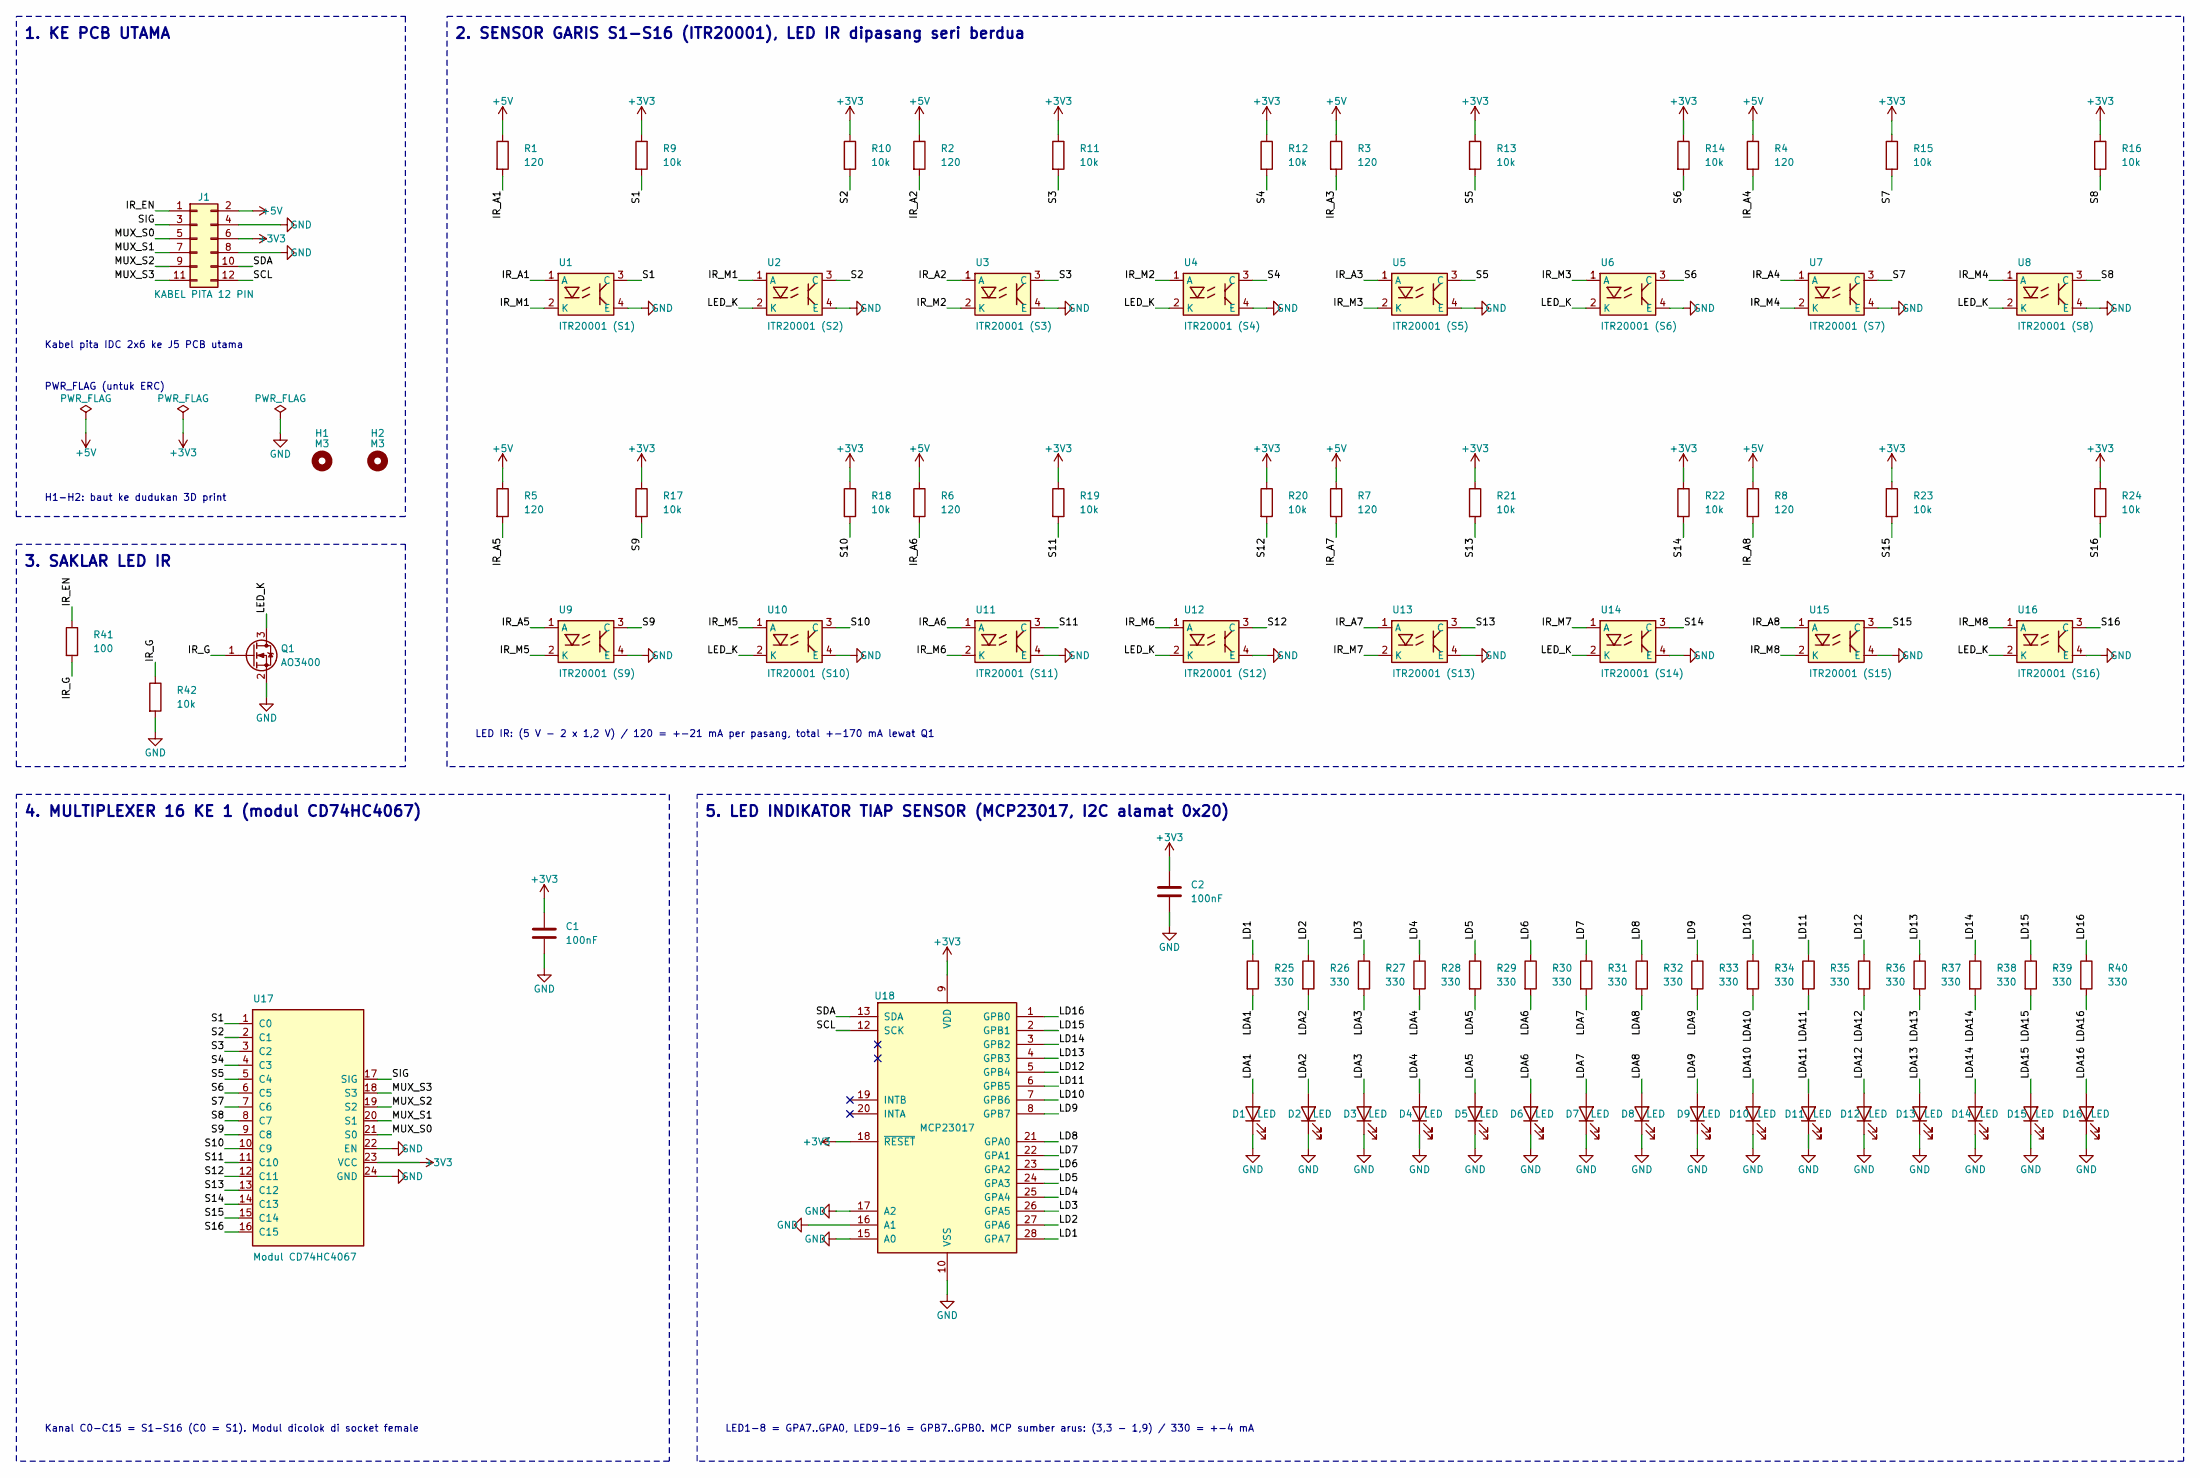
[picture p110: schematic ltm-sensor.kicad_sch, LTM - PCB Sensor 16 titik]

Parts:
C1, C2: 100nF; C_0805_2012Metric_Pad1.18x1.45mm_HandSolder
D1, D2, D3, D4, D5, D6, D7, D8, D9, D10, D11, D12, D13, D14, D15, D16: LED; LED_0805_2012Metric_Pad1.15x1.40mm_HandSolder
H1, H2: M3; MountingHole_3.2mm_M3
J1: KABEL PITA 12 PIN; IDC-Header_2x06_P2.54mm_Vertical
Q1: AO3400; SOT-23
R1, R2, R3, R4, R5, R6, R7, R8: 120; R_0805_2012Metric_Pad1.20x1.40mm_HandSolder
R9, R10, R11, R12, R13, R14, R15, R16, R17, R18, R19, R20, R21, R22, R23, R24, R42: 10k; R_0805_2012Metric_Pad1.20x1.40mm_HandSolder
R25, R26, R27, R28, R29, R30, R31, R32, R33, R34, R35, R36, R37, R38, R39, R40: 330; R_0805_2012Metric_Pad1.20x1.40mm_HandSolder
R41: 100; R_0805_2012Metric_Pad1.20x1.40mm_HandSolder
U1: ITR20001 (S1); ITR20001
U2: ITR20001 (S2); ITR20001
U3: ITR20001 (S3); ITR20001
U4: ITR20001 (S4); ITR20001
U5: ITR20001 (S5); ITR20001
U6: ITR20001 (S6); ITR20001
U7: ITR20001 (S7); ITR20001
U8: ITR20001 (S8); ITR20001
U9: ITR20001 (S9); ITR20001
U10: ITR20001 (S10); ITR20001
U11: ITR20001 (S11); ITR20001
U12: ITR20001 (S12); ITR20001
U13: ITR20001 (S13); ITR20001
U14: ITR20001 (S14); ITR20001
U15: ITR20001 (S15); ITR20001
U16: ITR20001 (S16); ITR20001
U17: Modul CD74HC4067; CD74HC4067_Module
U18: MCP23017; DIP-28_W7.62mm_Socket

Connections:
+3V3: C1.1, C2.1, J1.6, R9.1, R10.1, R11.1, R12.1, R13.1, R14.1, R15.1, R16.1, R17.1, R18.1, R19.1, R20.1, R21.1, R22.1, R23.1, R24.1, U17.23 (VCC), U18.9 (VDD), U18.18 (~RESET)
+5V: J1.2, R1.1, R2.1, R3.1, R4.1, R5.1, R6.1, R7.1, R8.1
/IR_A1: R1.2, U1.1 (A)
/IR_A2: R2.2, U3.1 (A)
/IR_A3: R3.2, U5.1 (A)
/IR_A4: R4.2, U7.1 (A)
/IR_A5: R5.2, U9.1 (A)
/IR_A6: R6.2, U11.1 (A)
/IR_A7: R7.2, U13.1 (A)
/IR_A8: R8.2, U15.1 (A)
/IR_EN: J1.1, R41.1
/IR_G: Q1.1 (G), R41.2, R42.1
/IR_M1: U1.2 (K), U2.1 (A)
/IR_M2: U3.2 (K), U4.1 (A)
/IR_M3: U5.2 (K), U6.1 (A)
/IR_M4: U7.2 (K), U8.1 (A)
/IR_M5: U9.2 (K), U10.1 (A)
/IR_M6: U11.2 (K), U12.1 (A)
/IR_M7: U13.2 (K), U14.1 (A)
/IR_M8: U15.2 (K), U16.1 (A)
/LD1: R25.1, U18.28 (GPA7)
/LD2: R26.1, U18.27 (GPA6)
/LD3: R27.1, U18.26 (GPA5)
/LD4: R28.1, U18.25 (GPA4)
/LD5: R29.1, U18.24 (GPA3)
/LD6: R30.1, U18.23 (GPA2)
/LD7: R31.1, U18.22 (GPA1)
/LD8: R32.1, U18.21 (GPA0)
/LD9: R33.1, U18.8 (GPB7)
/LD10: R34.1, U18.7 (GPB6)
/LD11: R35.1, U18.6 (GPB5)
/LD12: R36.1, U18.5 (GPB4)
/LD13: R37.1, U18.4 (GPB3)
/LD14: R38.1, U18.3 (GPB2)
/LD15: R39.1, U18.2 (GPB1)
/LD16: R40.1, U18.1 (GPB0)
/LDA1: D1.2 (A), R25.2
/LDA2: D2.2 (A), R26.2
/LDA3: D3.2 (A), R27.2
/LDA4: D4.2 (A), R28.2
/LDA5: D5.2 (A), R29.2
/LDA6: D6.2 (A), R30.2
/LDA7: D7.2 (A), R31.2
/LDA8: D8.2 (A), R32.2
/LDA9: D9.2 (A), R33.2
/LDA10: D10.2 (A), R34.2
/LDA11: D11.2 (A), R35.2
/LDA12: D12.2 (A), R36.2
/LDA13: D13.2 (A), R37.2
/LDA14: D14.2 (A), R38.2
/LDA15: D15.2 (A), R39.2
/LDA16: D16.2 (A), R40.2
/LED_K: Q1.3 (D), U2.2 (K), U4.2 (K), U6.2 (K), U8.2 (K), U10.2 (K), U12.2 (K), U14.2 (K), U16.2 (K)
/MUX_S0: J1.5, U17.21 (S0)
/MUX_S1: J1.7, U17.20 (S1)
/MUX_S2: J1.9, U17.19 (S2)
/MUX_S3: J1.11, U17.18 (S3)
/S1: R9.2, U1.3 (C), U17.1 (C0)
/S2: R10.2, U2.3 (C), U17.2 (C1)
/S3: R11.2, U3.3 (C), U17.3 (C2)
/S4: R12.2, U4.3 (C), U17.4 (C3)
/S5: R13.2, U5.3 (C), U17.5 (C4)
/S6: R14.2, U6.3 (C), U17.6 (C5)
/S7: R15.2, U7.3 (C), U17.7 (C6)
/S8: R16.2, U8.3 (C), U17.8 (C7)
/S9: R17.2, U9.3 (C), U17.9 (C8)
/S10: R18.2, U10.3 (C), U17.10 (C9)
/S11: R19.2, U11.3 (C), U17.11 (C10)
/S12: R20.2, U12.3 (C), U17.12 (C11)
/S13: R21.2, U13.3 (C), U17.13 (C12)
/S14: R22.2, U14.3 (C), U17.14 (C13)
/S15: R23.2, U15.3 (C), U17.15 (C14)
/S16: R24.2, U16.3 (C), U17.16 (C15)
/SCL: J1.12, U18.12 (SCK)
/SDA: J1.10, U18.13 (SDA)
/SIG: J1.3, U17.17 (SIG)
GND: C1.2, C2.2, D1.1 (K), D2.1 (K), D3.1 (K), D4.1 (K), D5.1 (K), D6.1 (K), D7.1 (K), D8.1 (K), D9.1 (K), D10.1 (K), D11.1 (K), D12.1 (K), D13.1 (K), D14.1 (K), D15.1 (K), D16.1 (K), J1.4, J1.8, Q1.2 (S), R42.2, U1.4 (E), U2.4 (E), U3.4 (E), U4.4 (E), U5.4 (E), U6.4 (E), U7.4 (E), U8.4 (E), U9.4 (E), U10.4 (E), U11.4 (E), U12.4 (E), U13.4 (E), U14.4 (E), U15.4 (E), U16.4 (E), U17.22 (EN), U17.24 (GND), U18.10 (VSS), U18.15 (A0), U18.16 (A1), U18.17 (A2)

Notes on the sheet:
1. KE PCB UTAMA
Kabel pita IDC 2x6 ke J5 PCB utama
PWR_FLAG (untuk ERC)
2. SENSOR GARIS S1-S16 (ITR20001), LED IR dipasang seri berdua
LED IR: (5 V - 2 x 1,2 V) / 120 = +-21 mA per pasang, total +-170 mA lewat Q1
3. SAKLAR LED IR
4. MULTIPLEXER 16 KE 1 (modul CD74HC4067)
Kanal C0-C15 = S1-S16 (C0 = S1). Modul dicolok di socket female
5. LED INDIKATOR TIAP SENSOR (MCP23017, I2C alamat 0x20)
LED1-8 = GPA7..GPA0, LED9-16 = GPB7..GPB0. MCP sumber arus: (3,3 - 1,9) / 330 = +-4 mA
H1-H2: baut ke dudukan 3D print

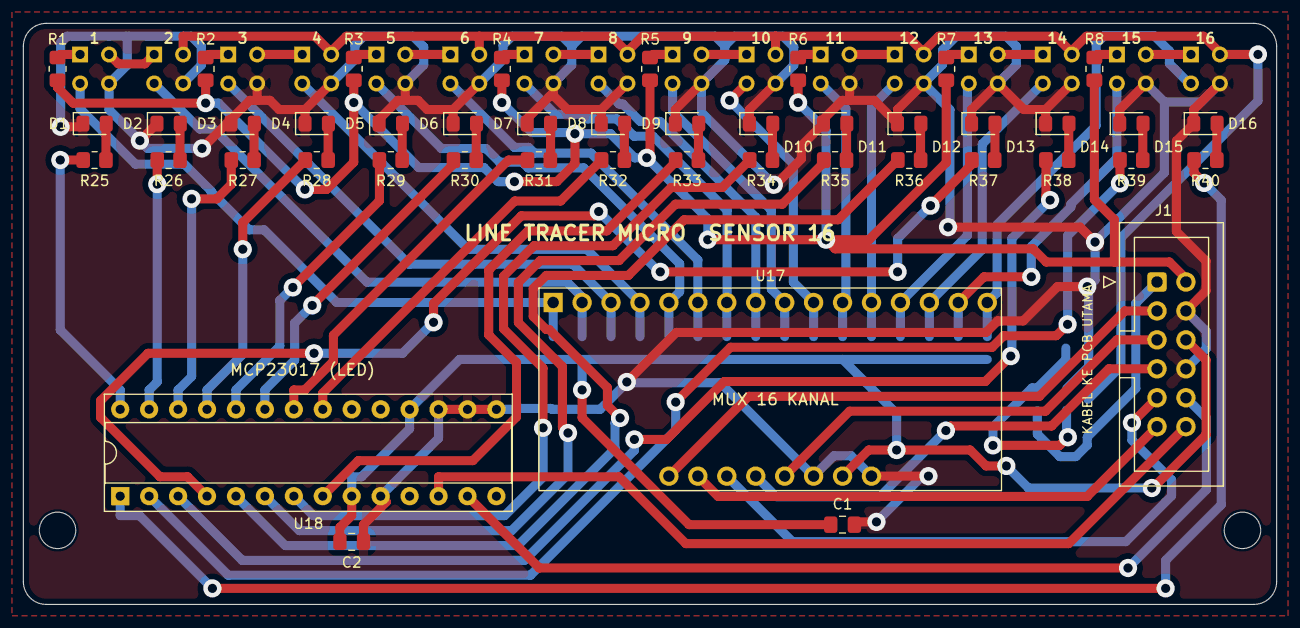
[picture p111: board ltm-sensor.kicad_pcb from above]

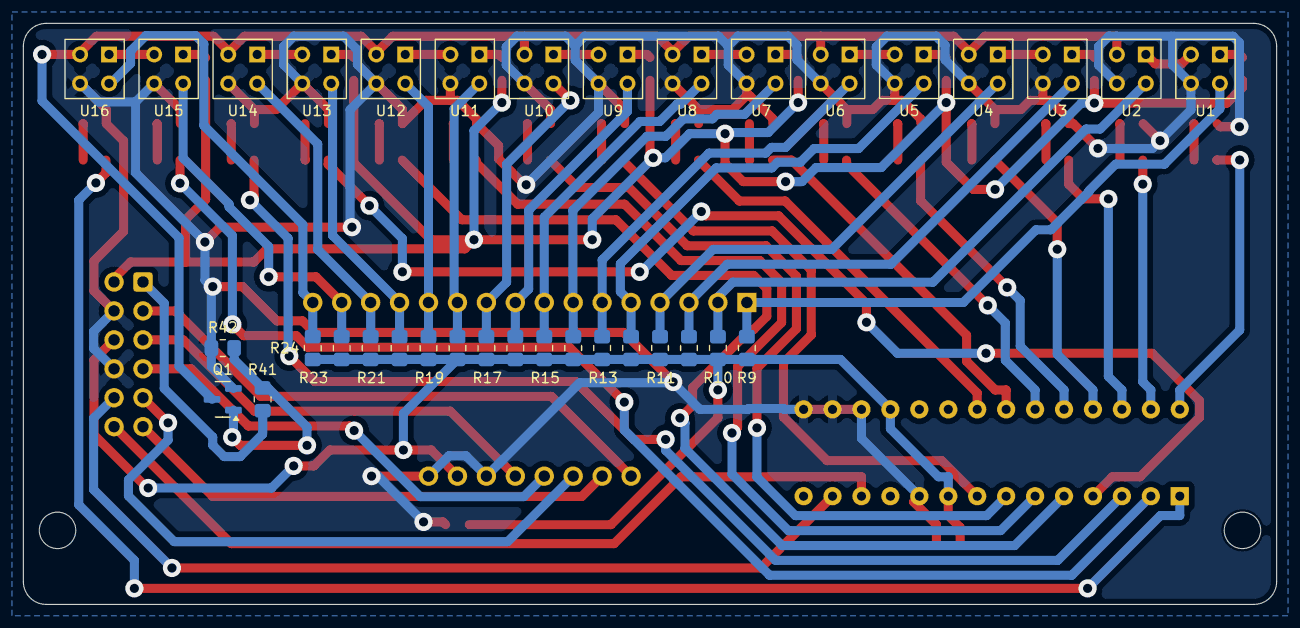
[picture p112: board ltm-sensor.kicad_pcb from below]

Board: 2 copper layers, 110.0 x 51.0 mm, 82 parts (35 on the bottom side), 77 nets.
