Mervs111/Line-Follower-Racer/hardware/sensor-garis/revisi/rev-b/sensor-garis.kicad_pcb

## KiCad design hardware/sensor-garis/revisi/rev-b/sensor-garis.kicad_pcb (2026-10-22)

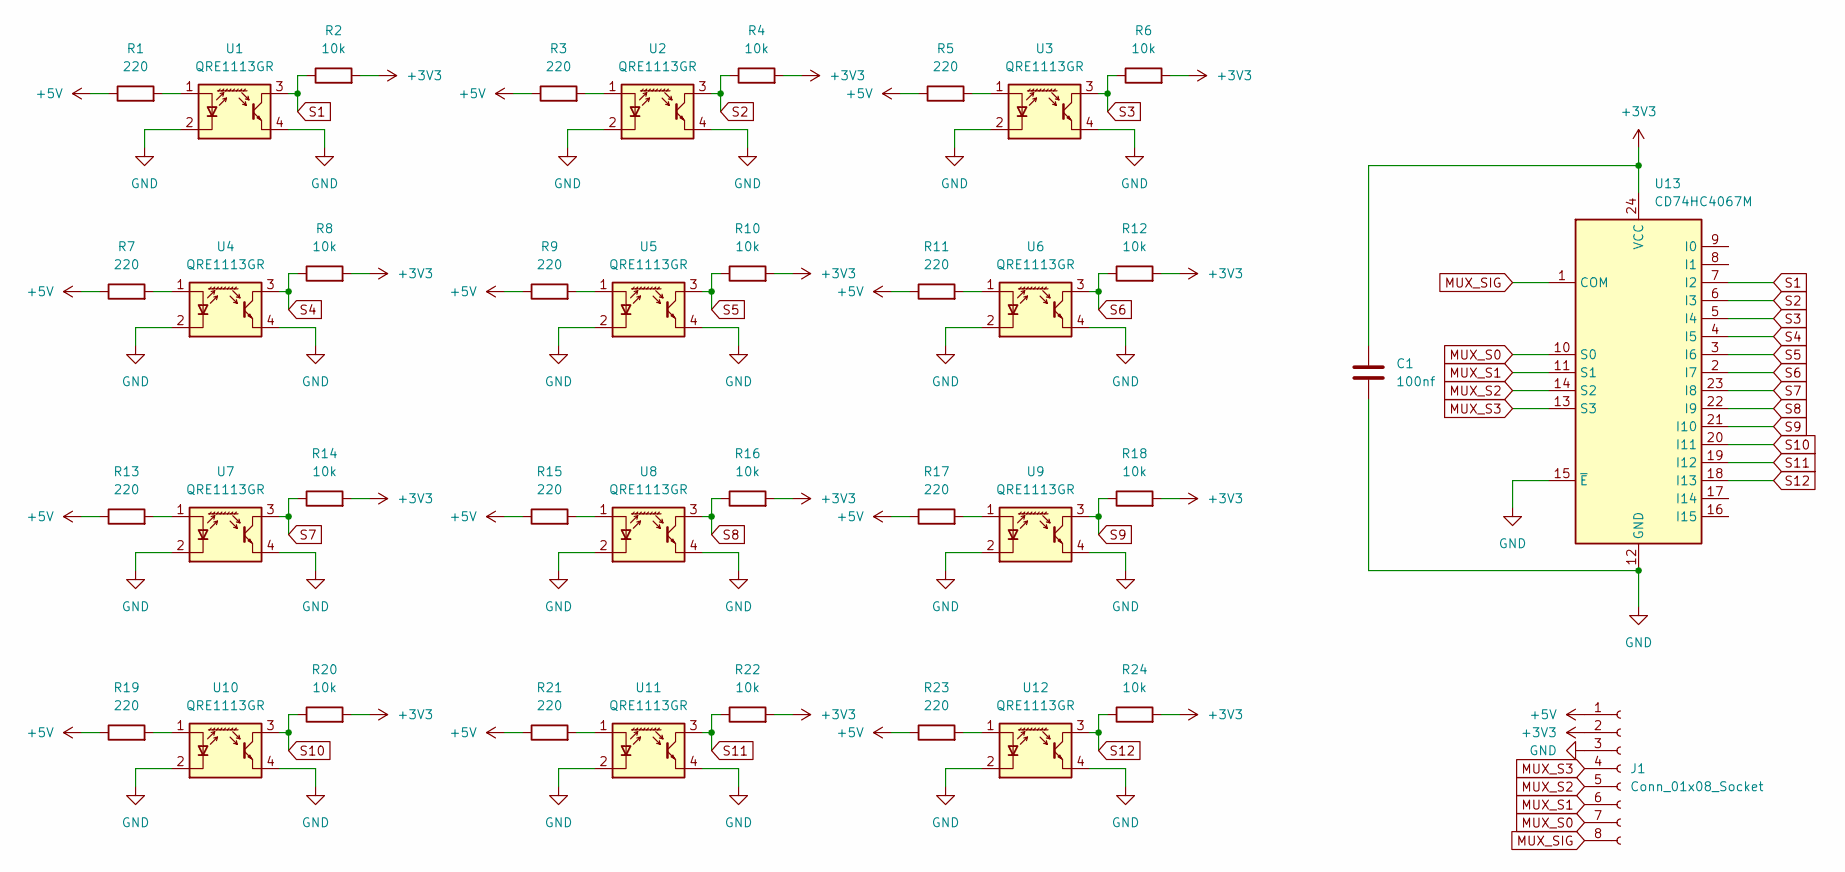
[picture p113: schematic sensor-garis.kicad_sch]

Parts:
C1: 100nf; C_0805_2012Metric_Pad1.18x1.45mm_HandSolder
J1: Conn_01x08_Socket; JST_XH_B8B-XH-A_1x08_P2.50mm_Vertical
R1, R3, R5, R7, R9, R11, R13, R15, R17, R19, R21, R23: 220; R_0805_2012Metric_Pad1.20x1.40mm_HandSolder
R2, R4, R6, R8, R10, R12, R14, R16, R18, R20, R22, R24: 10k; R_0805_2012Metric_Pad1.20x1.40mm_HandSolder
U1, U2, U3, U4, U5, U6, U7, U8, U9, U10, U11, U12: QRE1113GR; OnSemi_CASE100CY
U13: CD74HC4067M; SOIC-24W_7.5x15.4mm_P1.27mm

Connections:
+3V3: C1.1, J1.2, R2.2, R4.2, R6.2, R8.2, R10.2, R12.2, R14.2, R16.2, R18.2, R20.2, R22.2, R24.2, U13.24 (VCC)
+5V: J1.1, R1.1, R3.1, R5.1, R7.1, R9.1, R11.1, R13.1, R15.1, R17.1, R19.1, R21.1, R23.1
GND: C1.2, J1.3, U1.2 (K), U1.4, U2.2 (K), U2.4, U3.2 (K), U3.4, U4.2 (K), U4.4, U5.2 (K), U5.4, U6.2 (K), U6.4, U7.2 (K), U7.4, U8.2 (K), U8.4, U9.2 (K), U9.4, U10.2 (K), U10.4, U11.2 (K), U11.4, U12.2 (K), U12.4, U13.12 (GND), U13.15 (~E)
MUX_S0: J1.7, U13.10 (S0)
MUX_S1: J1.6, U13.11 (S1)
MUX_S2: J1.5, U13.14 (S2)
MUX_S3: J1.4, U13.13 (S3)
MUX_SIG: J1.8, U13.1 (COM)
unnamed: R1.2, U1.1 (A)
unnamed: R3.2, U2.1 (A)
unnamed: R5.2, U3.1 (A)
unnamed: R7.2, U4.1 (A)
unnamed: R9.2, U5.1 (A)
unnamed: R11.2, U6.1 (A)
unnamed: R13.2, U7.1 (A)
unnamed: R15.2, U8.1 (A)
unnamed: R17.2, U9.1 (A)
unnamed: R19.2, U10.1 (A)
unnamed: R21.2, U11.1 (A)
unnamed: R23.2, U12.1 (A)
S1: R2.1, U1.3, U13.7 (I2)
S2: R4.1, U2.3, U13.6 (I3)
S3: R6.1, U3.3, U13.5 (I4)
S4: R8.1, U4.3, U13.4 (I5)
S5: R10.1, U5.3, U13.3 (I6)
S6: R12.1, U6.3, U13.2 (I7)
S7: R14.1, U7.3, U13.23 (I8)
S8: R16.1, U8.3, U13.22 (I9)
S9: R18.1, U9.3, U13.21 (I10)
S10: R20.1, U10.3, U13.20 (I11)
S11: R22.1, U11.3, U13.19 (I12)
S12: R24.1, U12.3, U13.18 (I13)

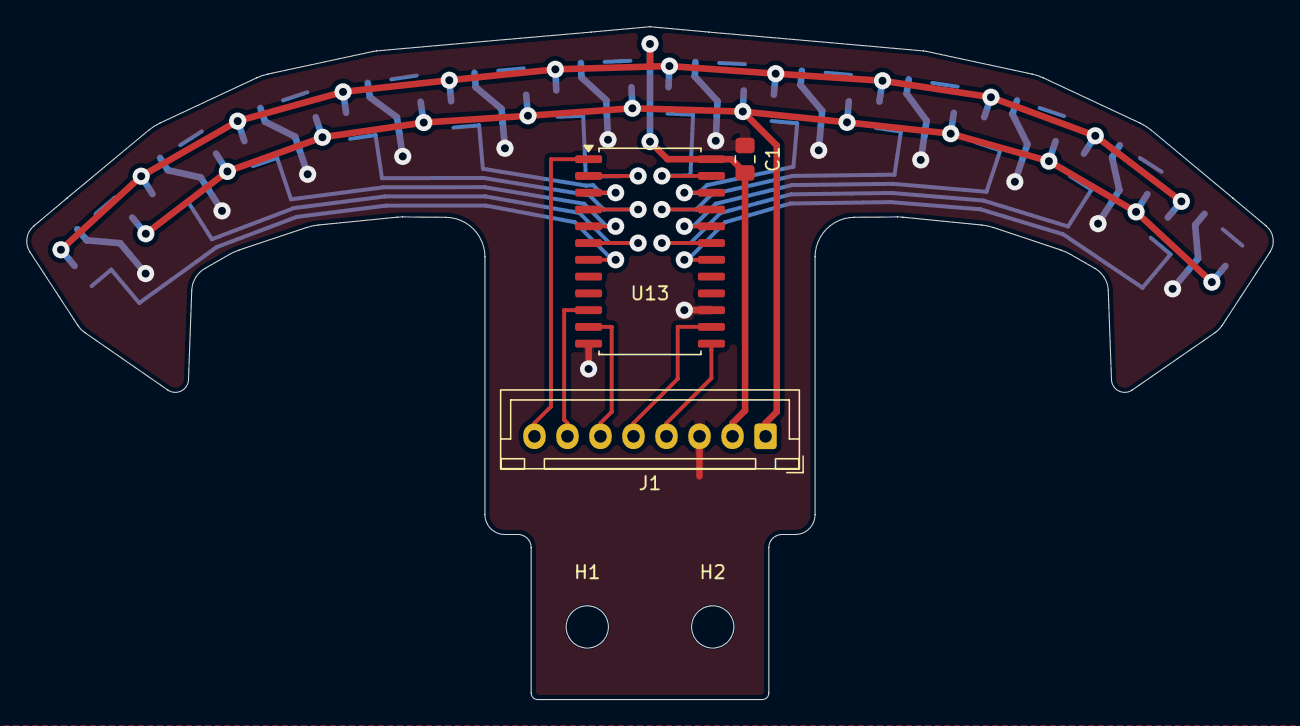
[picture p114: board sensor-garis.kicad_pcb from above]

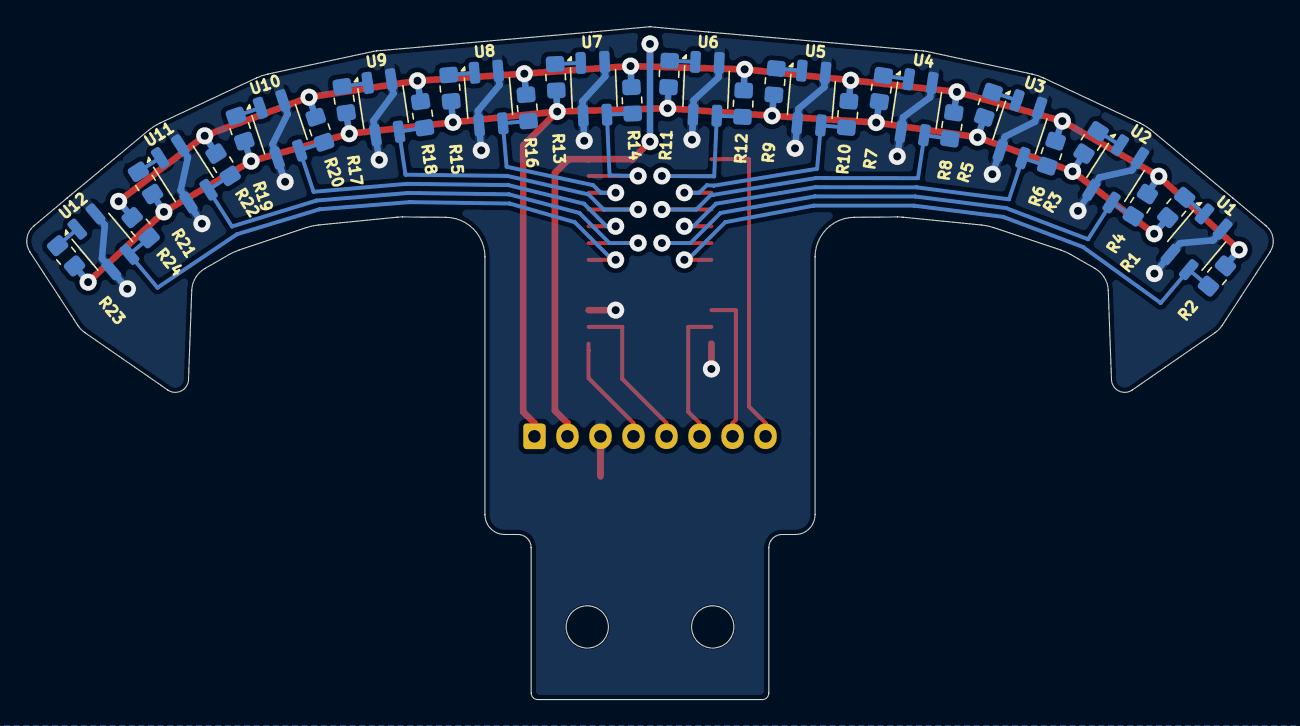
[picture p115: board sensor-garis.kicad_pcb from below]

Board: 2 copper layers, 94.4 x 51.0 mm, 41 parts (36 on the bottom side), 32 nets.

Other parts of the board:
H1, H2: MountingHole; MountingHole_3.2mm_M3
