Mervs111/Line-Follower-Racer/(commit log)

2026-09-28 Kerangka awal proyek line follower ESP32-S3
    Struktur repo, CLAUDE.md, platformio.ini, Pins.h, library.properties.
    Claude-Session: https://claude.ai/code/session_016j7fGnGXJh3ke3RU3C9DKW
2026-09-28 M0: serial jalan + blink WS2812
    - Kelas LineFollower dengan begin() dan led(), kompatibel core 2.x/3.x
    - main.cpp: LED hijau berkedip tanpa delay(), echo serial
    - docs/00-mulai-dari-sini.md: panduan alur kerja dan checklist tes M0
    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
2026-10-04 Simpan template logbook mingguan PjBL
    Format logbook resmi di docs/logbook/README.md dan aturan pembuatannya di CLAUDE.md.
    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
2026-10-04 Lengkapi rincian kegiatan di logbook utama
    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
2026-10-08 Catat keputusan: ESP32 biasa + 74HC4051, sensor panah, baterai 2S
    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
2026-10-08 Ganti ke 5 sensor garis tanpa multiplexer
    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
2026-10-08 Charter revisi 3: 5 sensor, ESP32 biasa, baterai 2S, RAB Rp821.000
    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
2026-10-08 Simpan perhitungan awal motor dan roda
    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
2026-10-08 Tambah safety factor 2 pada perhitungan torsi motor
    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
2026-10-08 Kunci motor N20 6V ±700 RPM dan roda Ø43 mm
    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
2026-10-08 Charter revisi 3.1: konektor motor encoder, total RAB Rp831.000
    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
2026-10-08 Rancangan minimum system v1: pin map, rangkaian, konektor, papan sensor
    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
2026-10-08 Minsys v1: modul disolder langsung ke PCB
    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
2026-10-08 Robot rendah satu bidang: N20 500 RPM, roda Ø34, baterai 2× 14500, RAB Rp845.000
    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
2026-10-08 Simpan referensi PCB dan arah desain semi-terintegrasi
    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
2026-10-08 Pisahkan jalur PCB: versi modul (PjBL) dan semi-terintegrasi (side project)
    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
2026-10-08 Tambah referensi pesaing: LF edukasi ESP32 14 sensor + Blockly
    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
2026-10-08 Catat keputusan body 3D print opsi B (cover di atas PCB)
    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
2026-10-09 Hapus IMU sesuai arahan dosen: charter & RAB revisi 3.4 (Rp833.000)
    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
2026-10-11 Mekanik v10 jangkar: model 3D CadQuery, STEP untuk Fusion, render
    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
    [LTM_v10_jangkar.step]
2026-10-11 Mekanik v11: livery navy-merah-kuning, roda Ø26, STEP + render baru
    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
    [LTM_v10_jangkar.step, LTM_v11.step]
2026-10-11 Mekanik v11: roda lebar Ø26x14 bertepi bulat seperti referensi
    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
    [LTM_v11.step]
2026-10-11 Acuan skematik v1: pin symbol modul, sambungan per blok, PCB sensor
    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
2026-10-11 Starter proyek KiCad: library LTM, skematik PCB utama & PCB sensor, PDF
    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
    [ltm-main.kicad_sch, ltm-sensor.kicad_sch]
2026-10-11 Layout PCB v1-draft: PCB utama + PCB sensor, routing FreeRouting, DRC bersih
    - J5 jadi lubang tembus untuk pin header J1 PCB sensor (celah antar papan 2,4 mm)
    - Pola net class Power memakai awalan / untuk net berlabel
    - gen_pcb.py: outline dari model mekanik v11, penempatan, routing, pour GND, DRC
    - Render atas/bawah dan rakitan di hardware/render
    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
    [ltm-main.kicad_pcb, ltm-main.kicad_sch, ltm-sensor.kicad_pcb]
2026-10-11 Dokumentasi jalur ngecas: modul charger tetap di dinding belakang, kabel ke BMS
    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
2026-10-11 Model 3D v11 disamakan dengan layout PCB v1; area ball caster bebas kaki solder
    - Model: lubang H3/H4 dan spacer antar papan, pangkal leher sensor ±14, saklar + JST XH baterai di tepi
    kiri, JST motor, buzzer, elko, resistor/kapasitor, socket OLED 8,5 mm, pin J5, komponen bawah PCB sensor
    - Dinding motor berhenti sebelum tepi belakang PCB utama (sebelumnya beririsan 1 mm)
    - PCB: R3/R4 dan R5-R8 digeser keluar area ball caster, tanda caster & BMS di silkscreen bawah, routing ulang
    - STEP, render mekanik, dan render PCB diperbarui
    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
    [LTM_v11.step, ltm-main.kicad_pcb, ltm-sensor.kicad_pcb]
2026-10-12 Kabel BMS 2S: titik tengah holder seri ke BM
    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
2026-10-13 Tugas RAB pemeliharaan 5 tahun (CAPEX & OPEX) armada 5 unit
    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
    [RAB_Pemeliharaan_5_Tahun_LTM.xlsx]
2026-10-13 Usulan mekanik v12: leher sensor dipendekkan 20 mm (3D saja)
    Ujung jangkar F 132 -> 112: panjang +-154 mm, sensor tengah +-107,5 mm
    dari poros, PCB sensor 92 x 33. Tulisan pindah ke lengan, komponen SMD
    bawah ditata ulang (posisi usulan). PCB di hardware/ belum diubah.
    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
    [LTM_v12.step]
2026-10-13 PCB utama v2: lebih sederhana dan gampang diakses untuk edukasi
    - Skematik 34 -> 25 komponen: C2-C6 dan R5-R8 dibuang (modul sudah punya
    kapasitor, encoder pakai INPUT_PULLUP), D1 SS14 -> 1N5819 (semua THT).
    - ESP32 keluar dari bawah dudukan baterai, ESP32/TB6612/OLED di socket,
    MP1584 + D1 + R1/R2 di bawah dudukan baterai, J1/SW1 di tepi kanan.
    - OLED header di depan: layar tidak perlu diputar (U8G2_R0).
    - Silkscreen kotak blok (DAYA, OTAK, DRIVER MOTOR, LAYAR, SUARA) + peta
    ALUR DAYA. DRC 0/0, 294 segmen, 9 via.
    - Model 3D v12 ikut PCB utama v2; tepi dudukan baterai ke Y 29,5.
    Claude-Session: https://claude.ai/code/session_016j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
    [LTM_v12.step, ltm-main.kicad_pcb, ltm-main.kicad_sch]
2026-10-14 Sensor 16 titik + mux + LED, kabel pita, aturan cetak 0,8 mm
    - PCB sensor v2: batang lurus 110 x 51 mm, 16x ITR20001 (jarak 6,5 mm),
    modul mux CD74HC4067, MCP23017 + 16 LED indikator, box header IDC J1
    - PCB utama: J5 jadi box header IDC 2x6 (kabel pita ke PCB sensor),
    pin ESP32 disusun ulang supaya jalur tidak saling silang
    - Aturan tempat cetak: jalur >= 0,8 mm (daya 1,2), clearance 0,5,
    via 1,6/0,8; kedua PCB 0 jalur putus, DRC bersih
    - Charter/RAB: 16 sensor, total Rp896.000
    - Model 3D v12: PCB sensor batang di dudukan 3D print + kabel pita,
    STEP dan render diperbarui
    Claude-Session: https://claude.ai/code/session_016j7fGnG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
    [LTM_v12.step, ltm-main.kicad_pcb, ltm-main.kicad_sch, ltm-sensor.kicad_pcb, ltm-sensor.kicad_sch]
2026-10-15 Charter/RAB: sensor jadi 12 TCRT5000
    - Sensor ITR20001 16 titik -> TCRT5000 12 titik (+1 cadangan)
    - LED indikator dan resistor PCB sensor ikut berkurang
    - Total budget Rp882.500, sisa Rp17.500
    - Catatan keputusan 15/10 di CLAUDE.md (PCB utama target 12 x 12 cm)
    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
2026-10-15 Charter: LED IR sensor selalu nyala, MOSFET dihapus
    - Risiko R1 ditangani dengan kalibrasi + pelindung cahaya
    - Total budget Rp879.500, sisa Rp20.500
    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
2026-10-15 Charter: PCB sensor bentuk jangkar, jarak sensor 10 mm
    - 4 sensor depan + 4 di tiap sayap 45°, lebar baca ±110 mm
    - Catatan posisi sensor dan resistor di CLAUDE.md
    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
2026-10-16 Charter .docx (format Google Docs) disamakan dengan revisi 15/10
    - Lingkup elektronik: 12 sensor TCRT5000, PCB sensor jangkar, mux + LED indikator
    - Budget Summary: total Rp879.500 (electrical Rp734.500), sesuai docs/charter.md
    - Tanggal persetujuan 16 Oktober 2026
    Claude-Session: https://claude.ai/code/session_0155yf5wpAX58VAfqTZWuQQK
2026-10-16 Usulan mekanik v13 gaya Ichiduino Pro dengan komponen RAB sekarang
    - PCB sensor capit 120 x 80 (12 TCRT5000 posisi 15/10), batang masuk ke bawah PCB utama
    - OLED 0,96", roda merah O43 x 19, ESP32 di sisi bawah PCB utama
    - Bagian 3D print: dudukan motor + baterai, sayap 3 panel, tiang sayap, pelindung cahaya
    - File per bagian (STEP/STL), outline PCB DXF untuk KiCad, render + perbandingan siluet
    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
    [LTM_v13_rakitan.step, cetak_dudukan_motor_baterai.step, cetak_dudukan_motor_baterai.stl, cetak_pelindung_cahaya.step, cetak_pelindung_cahaya.stl, cetak_sayap_belakang.step, cetak_sayap_belakang.stl, cetak_tiang_sayap.step]
2026-10-18 Mekanik v13: ESP32 di atas (socket), PCB utama 100 x 121
    - ESP32 DevKit melintang di depan dudukan baterai, USB ke kiri (permintaan user: jangan di bawah)
    - OLED 0,96" di depan ESP32, tombol A/B kiri-kanan, TB6612 + buzzer di bahu kanan
    - Hidung PCB utama menutupi tengah PCB sensor; spacer, ball caster, J1, MCP23017 digeser
    - Panjang robot tetap +-160 mm, cek tabrakan 0
    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
    [LTM_v13_rakitan.step, cetak_dudukan_motor_baterai.step, cetak_pelindung_cahaya.step, cetak_sayap_belakang.step, cetak_tiang_sayap.step, pcb_sensor.step, pcb_sensor_outline.dxf, pcb_sensor_posisi_tcrt5000.dxf]
2026-10-20 Rombak sensor: LED merah + fototransistor SMD 1206, tanpa MCP23017, roda Ø34 (v14)
    - Model mekanik v14 (CadQuery): 12 pasang LED merah + fototransistor SMD di sisi
    bawah PCB sensor capit, masker sensor 3D print, mux di atas palm PCB sensor,
    skid nilon pengganti ball caster; STEP/STL/DXF per bagian + render
    - Wiring diagram: blok sensor baru (R 330 Ω LED, R 10k pull-up), MCP23017 dihapus,
    pin 1/10/12 kabel pita kosong
    - Charter/RAB Rp859.500 (md + docx) dan generator docx disimpan di docs/charter-docx
    - CLAUDE.md dan mechanical/README.md mencatat keputusan 20/10/2026
    Claude-Session: https://claude.ai/code/session_0155yf5wpAX58VA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
    [LTM_v14_rakitan.step, cetak_dudukan_motor_baterai.step, cetak_dudukan_motor_baterai.stl, cetak_masker_sensor.step, cetak_masker_sensor.stl, cetak_sayap_belakang.step, cetak_sayap_belakang.stl, cetak_tiang_sayap.step]
2026-10-20 PCB sensor gaya JSumo XLINE dengan 12 QRE1113GR (mekanik v15)
    - Model v15 (CadQuery): PCB sensor pita 13 mm bentuk sayap (tengah lurus + sayap
    30 derajat, jarak 9 mm, sensor 4 dan 9 di tekukan), 12 QRE1113GR + resistor di
    sisi bawah, mux + J1 di badan tengah, tab 2 baut, tanpa masker; STEP/STL/DXF,
    CSV posisi sensor, render + perbandingan dengan foto XLINE
    - Wiring diagram: blok sensor QRE1113GR (R LED 220 Ω, pull-up 10k)
    - Charter/RAB Rp867.000 (md + docx), risiko R1/R8 disesuaikan
    - Foto referensi XLINE di docs/referensi, keputusan dicatat di CLAUDE.md
    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
    [LTM_v15_rakitan.step, cetak_dudukan_motor_baterai.step, cetak_dudukan_motor_baterai.stl, cetak_sayap_belakang.step, cetak_sayap_belakang.stl, cetak_tiang_sayap.step, cetak_tiang_sayap.stl, pcb_sensor.step]
2026-10-21 Mux jadi IC CD74HC4067 SOIC-24 di PCB sensor
    - Model v15: modul mux di socket diganti IC SOIC-24 + C 100 nF di badan tengah
    (badan 34 mm), skid tengah pindah ke tab di belakang J1
    - Wiring diagram blok 6: nomor pin IC (CD74HC4067M), E ke GND, I12-I15 ke GND
    - RAB Rp887.000 (IC Rp35.000), charter md + docx
    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
    [LTM_v15_rakitan.step, cetak_dudukan_motor_baterai.step, cetak_sayap_belakang.step, cetak_tiang_sayap.step, pcb_sensor.step, pcb_sensor_outline.dxf, pcb_sensor_posisi_qre1113.dxf, pcb_utama.step]
2026-10-21 Aturan cetak PCB baru (jalur 0,3 mm, jarak ke ground 0,5 mm)
    - docs/aturan-cetak-pcb.md: batas dari tempat cetak + isian KiCad Board Setup
    - CLAUDE.md: aturan lama 0,8 mm diganti; catatan IC mux disesuaikan
    - Wiring diagram: jalur IC 0,3 mm, nama label MUX_S0-MUX_S3
    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
2026-10-21 Template setting KiCad sesuai aturan cetak (impor lewat Board Setup)
    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
    [aturan-cetak.kicad_pcb]
2026-10-21 Outline PCB sensor simetris dari layout user (DXF + gambar ukuran)
    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
    [pcb_sensor_outline_simetris.dxf]
2026-10-22 MCP KiCad: Claude bisa edit PCB live di KiCad 9/10 lewat IPC API
    Server MCP (kicad-python) untuk Claude Code lokal: baca/pindah/flip footprint,
    outline Edge.Cuts (poligon bersudut bulat + cermin), teks/track/via, seleksi,
    grid origin, DRC dan render 2D/3D lewat salinan sementara + kicad-cli.
    Dites di KiCad 9.0.9 dan 10.0.7, mcp 1.30 dan 2.3.
    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
2026-10-22 Handover untuk Claude Code di laptop + simpan sumber diagram blok
    docs/handover-claude-lokal.md: langkah setup laptop (Claude Code, KiCad API,
    MCP), status PCB sensor buatan user, pekerjaan tertunda, kebiasaan user.
    docs/diagram-blok-src/: sumber Design canvas diagram blok (sebelumnya hanya
    di folder sementara sesi cloud).
    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
2026-10-22 MCP KiCad: batasi pymupdf <2 (versi 2 menarik onnxruntime dll., unduhan jauh lebih besar)
    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
2026-10-22 PCB sensor user (KiCad 10) masuk repo sebagai rev A
    hardware/sensor-garis/: 12 QRE1113GR + CD74HC4067M + JST XH 8 pin, outline ujung
    panah. Komponen ditata di dalam Edge.Cuts, routing ulang (sinyal B, daya F, pour
    GND 2 sisi), DRC 0 error / 0 unconnected. Salinan utuh + gambar di revisi/rev-a/,
    riwayat di REVISI.md. Catat target lomba IARC XII (garis 2 cm) di CLAUDE.md.
    [sensor-garis.kicad_pcb, sensor-garis.kicad_sch]
2026-10-22 Koreksi urutan pin J1 PCB sensor sesuai skematik user
    1 +5V, 2 +3V3, 3 GND, 4 MUX_S3, 5 MUX_S2, 6 MUX_S1, 7 MUX_S0, 8 MUX_SIG
    (catatan handover sebelumnya keliru). J5 PCB utama wajib urutan yang sama.
2026-10-22 PCB sensor rev B: bentuk jangkar, 12 QRE jarak 8 mm di busur
    Sensor tengah hampir lurus, lengan melengkung ke belakang (5/5/12/25/40 derajat),
    pita + kait + tangkai, lebar 95 mm. Routing ulang (S di B, daya di F, pour GND
    2 sisi), DRC 0 error / 0 unconnected. Salinan + gambar di revisi/rev-b/, catatan
    dan koordinat sensor untuk firmware di REVISI.md, skrip penataan di
    hardware/tools/sensor_revb_layout.py.
    [sensor-garis.kicad_pcb, sensor-garis.kicad_sch]
2026-10-22 Bersih-bersih repo: file usang ke arsip/, CLAUDE.md dirapikan
    - PCB sensor v2 generator (16 ITR20001), STEP v11/v12, model v13/v14, konsep
    ringkas dipindah ke arsip/ (susunan folder sama, library ltm tetap terbaca)
    - mechanical/README.md hanya v15; versi lama ke arsip/mechanical/README.md
    - CLAUDE.md: rancangan terkini (ESP32 DevKit, 12 QRE1113GR, pin map 13/10,
    J1 JST XH 8 pin) di atas, riwayat keputusan diringkas, bagian ESP32-S3 dibuang
    - README.md disamakan; folder lokal LineFollowerRacer/ di-gitignore
    [LTM_v11.step, LTM_v12.step, LTM_v13_rakitan.step, LTM_v14_rakitan.step, cetak_dudukan_motor_baterai.step, cetak_dudukan_motor_baterai.stl, cetak_masker_sensor.step, cetak_masker_sensor.stl]
2026-10-22 RAB: QRE1113GR lokal Rp15.000 (12 pcs), JST XH 8 pin; wiring diagram disamakan
    - charter.md + gen_charter.js: QRE 12 x Rp15.000 tanpa cadangan, kabel pita diganti
    JST XH 8 pin, breadboard + timah dipinjam lab; total Rp902.000 (lewat Rp2.000)
    - risiko R8 dan alasan pemilihan sensor disamakan dengan PCB sensor rev B
    - wiring diagram: blok 4 kabel JST XH 8 pin, blok 6 mux I2-I13 (I0/I1/I14/I15 kosong)
    - handover: status pekerjaan tertunda
2026-10-22 Model 3D v16 (PCB sensor rev B dari KiCad) + proyek awal PCB utama
    - mechanical/cadquery/ltm_v16.py: PCB sensor dibaca langsung dari sensor-garis.kicad_pcb (rev B jangkar),
    kabel JST XH 8 pin J5-J1, usulan skid nilon di baut H1/H2; STEP/STL/DXF di mechanical/v16/, render, viewer
    - hardware/pcb-utama/: proyek KiCad 10 awal (outline 100 x 121, lubang, gambar bantu penempatan, outline PCB
    sensor, skematik kosong) dari hardware/tools/gen_pcb_utama_awal.py
    - README mekanik/hardware, CLAUDE.md, handover diperbarui
    [LTM_v16_rakitan.step, cetak_dudukan_motor_baterai.step, cetak_dudukan_motor_baterai.stl, cetak_sayap_belakang.step, cetak_sayap_belakang.stl, cetak_tiang_sayap.step, cetak_tiang_sayap.stl, pcb-utama.kicad_pcb]
2026-10-22 Charter docx dibuat ulang: RAB Rp902.000 (QRE lokal, JST XH 8 pin)
    Node.js 24 LTS terpasang di laptop; node_modules/ di-gitignore.
2026-10-22 Langkah skematik PCB utama + log kerja harian
    - hardware/pcb-utama/README.md: langkah per blok (simbol, footprint, sambungan, label pin ESP32, cek ERC)
    - docs/log-kerja.md: log per hari (21–22/10), diisi tiap selesai mengerjakan sesuatu
2026-10-22 Skematik PCB utama lengkap (ERC 0) dari generator
    - hardware/tools/gen_sch_utama.py + kisym.py: skematik 5 blok (daya, driver motor, layar/tombol/buzzer, ESP32,
    J5 ke PCB sensor), 21 komponen, footprint terisi; netlist dicek terhadap tabel pin CLAUDE.md (0 salah)
    - hardware/pcb-utama/pcb-utama-skematik.pdf
    - README PCB utama, CLAUDE.md, handover, log kerja diperbarui
    [pcb-utama.kicad_sch]
2026-10-22 Outline PCB utama bentuk mobil F1
    Pilihan user dari 3 opsi: sidepod lebar, pinggang lengkung di antara roda,
    hidung panjang (100 x 127 mm). J5 pindah ke sidepod kiri (pin 1 dekat
    hidung), elko C1 ke sidepod kiri, kabel sensor menyusuri tepi kiri hidung.
    Model v16 (0 tabrakan), render, PCB utama (DRC 0), skematik (ERC 0) dan
    dokumen diperbarui.
    [LTM_v16_rakitan.step, cetak_dudukan_motor_baterai.step, cetak_sayap_belakang.step, cetak_tiang_sayap.step, pcb-utama.kicad_pcb, pcb-utama.kicad_sch, pcb_sensor.step, pcb_sensor_outline.dxf]
2026-10-23 Layout PCB utama: penempatan + routing pertama (FreeRouting)
    21 footprint ditempatkan sesuai model v16 (bentuk F1), routing FreeRouting
    (skrip di hardware/tools/autoroute/), GND pour F.Cu + B.Cu. DRC 0 unconnected;
    tersisa 11 error dari footprint pustaka Q1 (TO-92 rapat) dan SW1 (pad
    pemasang 0,25 mm), menunggu keputusan user.
    [pcb-utama.kicad_pcb]
2026-10-24 Rakitan PCB LFM: PCB sensor + PCB utama dari KiCad digabung, viewer dengan ukuran
    - mechanical/rakitan-pcb/gen_rakitan.py: ekspor kedua board dengan kicad-cli (GLB, koordinat robot), tambah model 3D
    pustaka KiCad di salinan pcb-utama, gabung dengan bagian mekanik v16, kompres gltfpack
    - LFM_rakitan.glb (Blender/penampil glTF), LFM_rakitan_web.json (viewer), index.html: garis ukuran per tampak,
    alat ukur dua titik, tabel ukuran
    - mechanical/viewer/model.json: data viewer v16 disimpan di repo
    - README mekanik, CLAUDE.md, log kerja 24/10
2026-10-24 STEP rakitan PCB LFM: PCB sensor + PCB utama dalam satu file STEP
    - gen_rakitan_step.py: tiap board diekspor ke STEP oleh kicad-cli, lalu dipasang sebagai model 3D di board kosong
    dan diekspor lagi -> dua sub-rakitan PCB_SENSOR + PCB_UTAMA, sumbu sama dengan STEP v16 (nol di lantai)
    - LFM_rakitan_pcb.step (3,6 MB); versi --tembaga (21 MB) tidak masuk git
    - README rakitan, CLAUDE.md, log kerja 24/10
    [LFM_rakitan_pcb.step]
2026-10-26 Bahan pitching RAB: naskah 14 slide + render PCB terbaru
    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
2026-10-26 Deck pitching RAB (template kelompok) + diagram blok: PCB sensor bentuk jangkar
    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
2026-10-26 Path planning: indeks = langkah rute (pola sensor → aksi → ikuti garis), sesuai blok Ichiduino
    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
2026-10-26 RAB jadi Rp887.000: mux CD74HC4067M SOP-24 Rp20.000 dari WKH Electronic (charter + docx, deck, naskah)
    Toko lokal lain hanya punya versi SSOP yang tidak lolos aturan cetak; versi SOP-24 cocok dengan footprint
    SOIC-24W, jadi PCB sensor tidak berubah. Subtotal lampiran A deck dibetulkan.
    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
2026-10-26 Simulasi: logika kendali + uji 2D (lulus) dan skrip CoppeliaSim untuk pitching
    lfm_control.py: PID ikut garis, deteksi persimpangan dari sensor lengan, path planning per indeks (aksi diukur
    encoder), rute terpendek grid. test_2d.py: rute slide 8,2 s / 9 mm dari T, 0,3-0,7 m/s 25/25 lulus.
    coppeliasim/: build_scene.py (arena grid, robot dinamis ukuran asli, 12 vision sensor, mesh rakitan PCB, kamera)
    dan run_sim.py (stepping, video + log, mode kinematik cadangan); dicek terhadap tiruan API, belum di CoppeliaSim
    asli. Panduan Claude lokal di docs/handover-claude-lokal.md bagian 6.
    Claude-Session: https://claude.ai/code/session_0155yf5wpA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
    [g00.obj, g01.obj, g02.obj, g03.obj, g04.obj, g05.obj, g06.obj, g07.obj]
2026-10-26 Simulasi CoppeliaSim asli: rute slide dan rute terpendek LULUS (video, screenshot, scene)
    CoppeliaSim Edu 4.10, Bullet 2.78, dt 5 ms, fisika roda asli. Rute slide 8 LULUS
    (8,30 s, 12,6 mm dari T); --scenario bfs --blocked 1,0 2,2 1,2 LULUS (5,69 s,
    11,2 mm). Logika tidak diubah; build_scene.py hanya tampilan: kamera video
    dipindah supaya robot di S dan T utuh, kamera perekam disembunyikan dari jendela,
    pandangan jendela diarahkan ke arena. README simulasi, CLAUDE.md, handover, log kerja.
2026-10-27 RAB jadi Rp937.390: harga hasil validasi marketplace dari spreadsheet kelompok (charter + docx, deck, naskah)
    Sumber: RAB PJBL P01.ods. Electrical Rp862.390 + Mechanical Rp50.000 + Lain-lain (timah + flux)
    Rp25.000, sisa Rp62.610 dari Rp1.000.000. Keputusan user: mux tetap IC CD74HC4067M WKH Rp20.000
    (baris spreadsheet ternyata modul kakarobot Rp35.000), ball caster ganti skid nilon, bracket motor
    dihapus, resistor THT masuk komponen pendukung, PCB utama nanti ikut barang di link (tombol 12x12 mm,
    JST XH 6 pin untuk motor). Charter dapat tabel tautan toko. Deck diubah langsung di XML .pptx
    (slide 4, 5, 12, 13, 14, 16, lampiran A-C, grafik, catatan); build.js disamakan.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
2026-10-27 Perhitungan rancangan diperbarui: kecepatan, torsi, massa, encoder, daya, baterai, rangkaian
    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
2026-10-27 Perhitungan: spesifikasi motor N20 MTR-0239 dari listing (torsi rated 0,2 kg·cm, rasio 30:1)
    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
2026-10-27 Perhitungan: draf awal kelompok 08/10 dikembalikan utuh di lampiran + tabel perbandingan
    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
2026-11-03 Masukan pitching 27/10 dicatat, skematik PCB utama tanpa catatan teks (rev A)
    - CLAUDE.md + log kerja: masukan dosen (perhitungan ditambah, kecepatan dinilai
    lambat), dana belum turun sehingga belum ada barang dibeli, hitungan awal opsi
    kecepatan (roda kecil vs N20 1000 RPM)
    - Skematik PCB utama: 11 catatan teks dihapus user (29/10), revisi "A";
    komponen, footprint, kabel, label tidak berubah
    - Handover: urutan mux dibetulkan jadi I2-I13
    [pcb-utama.kicad_sch]
2026-11-03 Guidebook IARC XII SD masuk repo, koreksi arena: bentuk tangga/H, bukan grid
    - CLAUDE.md: arena 4 x 3 m dua jalur panjang + tiga jalur melintang (simpang T),
    objek 10/30/50 poin, batas robot 350 g, Li-ion 8,2 V +- 1 V, program onsite
    Ardublock
    - Log kerja: N20 1000 RPM di CNC Store tanpa encoder; saran tetap 500 RPM + encoder
2026-11-03 Konsep v17: PCB utama ringkas + board interface bertumpuk, sasis skid plate 3D print
    - mechanical/konsep-v17/gen_konsep.py: gambar to-scale v16 vs usulan (tampak atas
    + samping) dengan cek tabrakan kotak 3D, jalur USB, dan zona antena ESP32
    - PCB utama 62 x 58 mm + interface 42 x 42 mm (-44% luas), 5 tombol 6x6
    lewat resistor ladder GPIO34, charger di skid plate, BMS di holder
    - CLAUDE.md + log kerja: keputusan user 03/11 (tetap modul, PCB seringkas
    mungkin, board interface, tumpukan di depan baterai)
2026-11-03 Konsep v17: tombol board interface di kiri-kanan OLED
    - OLED di tengah, 2 tombol 6x6 di kiri dan 3 di kanan (permintaan user)
    - board interface 46 x 32 mm (14,6 cm2), total -47% dari v16
    - header J6 digeser ke kanan, cek kaki header di bawah komponen interface
2026-11-03 Konsep v17: ban lebih lebar ke luar, skid plate belakang melebar
    - ban O34 x 18 mm melebar ke luar: lebar robot 115 mm, jarak tengah ban 97 mm
    - skid plate di belakang roda melebar sampai sisi luar ban (celah ke ban 4 mm)
    - catatan: roda N20 O34 di toko umumnya 6,5-7 mm; alternatif velg 3D print
    atau roda O44 x 17,5 mm
2026-11-03 Konsep v17: skid plate trapesium dengan coakan roda
    - sisi lurus dari hidung 62 mm melebar ke belakang sampai sisi luar ban 115 mm
    - coakan roda celah 4 mm, cek PCB utama di dalam skid plate (jarak tepi >= 1,5 mm)
    - log: jawaban soal MP1584 dan TB6612 (1 modul, 2 kanal PWM)
2026-11-03 Diagram blok kendali: 2 jalur PWM kiri/kanan; konsep v17: label tombol menu
    - PID -> pembagi kecepatan -> PWM kiri (GPIO18, kanal A) dan PWM kanan
    (GPIO16, kanal B), encoder kiri dan kanan terpisah (masukan dosen 27/10)
    - konsep v17: 5 tombol menu OLED (kiri naik/turun, kanan kembali/OK/lanjut),
    velg 3D print O34 x 18 mm dipilih, TB6612 di bawah ESP32 disetujui
2026-11-03 Konsep v17: opsi PCB utama trapesium mengikuti skid plate
    - sisi sejajar skid plate, belakang tetap di y 24: 62/87 x 58 mm, 42,9 cm2
    - 4 lubang M3 di sayap dengan cek jarak tepi dan komponen
    - panel pembanding luas dan kotak pembungkus (belum dipilih)
2026-11-03 Konsep v17: PCB utama trapesium dipilih, J2/J3 XH 6 pin
    - trapesium jadi PCB utama (depan 62, belakang 87, panjang 58 mm, 4 lubang M3)
    - cek komponen di dalam outline trapesium (>= 0,5 mm dari tepi)
    - J2/J3 lebar 17,4 mm (XH 6 pin), J5/J6 mundur 0,5 mm
2026-11-03 Skematik PCB utama rev B + skematik board interface rev A
    - PCB utama: J6 socket 1x6 ke board interface (+3V3, GND, SDA, SCL, BTN
    GPIO34, AUX GPIO35), J4/SW2/SW3/R6 dihapus, R5 pull-up BTN, C2 100 nF di
    VBAT_SENSE, J2/J3 JST XH 6 pin, Q1 TO-92 Wide; ERC 0, 22 pin ESP32 cocok
    - board interface (proyek baru): OLED socket, 5 tombol 6x6 tangga resistor
    1k/3,9k/8,2k/18k/39k, C1 100 nF; ERC 0
    - layout PCB utama belum diperbarui (perlu F8 + outline trapesium)
    [board-interface.kicad_sch, pcb-utama.kicad_sch]
2026-11-03 Footprint MP1584: 2 lubang per terminal sesuai foto listing
    Diukur dari foto CNC Store (badan 22 x 17 mm sebagai skala, koreksi
    perspektif): kolom x +-9,5, pasangan lubang jarak 2,54 di y +-4,33/+-6,87.
    Masih "UKUR ULANG"; polaritas dicek di sisi bawah modul saat datang.
2026-11-03 Footprint MP1584: polaritas dan posisi lubang dari foto sisi atas/bawah
    Foto sisi bawah berlabel (user): dilihat dari sisi komponen IN kiri (SS34),
    OUT kanan (induktor), - di atas, + di bawah (pad kotak). Polaritas versi
    sebelumnya terbalik. Lubang: jarak pasangan 2,54, kolom +-9,35,
    y +-4,55/+-7,09. Silkscreen +/-/IN/OUT ditambahkan.
2026-11-03 Footprint MP1584: generator dan catatan ikut koreksi polaritas
    gen_kicad.py memakai posisi/polaritas baru (sekalian membetulkan bug lama:
    pad MP1584 tertimpa pad modul mux sebelum write_fp). README hardware,
    README pcb-utama, dan log kerja mencatat hasil dari foto sisi atas/bawah.
    [gen_kicad.py]
2026-11-03 Layout PCB utama rev B + PCB board interface rev A
    - PCB utama trapesium 86,6/62 x 58 mm dari gen_pcb_utama_v17.py (penempatan konsep v17,
    ESP32 melintang dengan TB6612 di bawahnya, SW1 di tepi kiri), routing FreeRouting -mp 8
    (304 segmen, 17 via), GND pour 2 sisi. DRC 0 error, 0 unconnected, cocok skematik.
    - Board interface 46 x 36 mm, 4 lubang M2, J1 di sisi bawah tepat di atas J6.
    Routing autoroute/sisa.py, DRC 0.
    - Render, DSN/SES routing, README (alur rev B, bug FreeRouting 2.1), CLAUDE.md, log kerja.
    [board-interface.kicad_pcb, pcb-utama-revB.dsn, pcb-utama.kicad_pcb]
2026-11-04 Cek PCB utama rev B live di KiCad + catatan batasan MCP
    DRC live 0 error / 0 unconnected. README MCP: hanya satu KiCad yang
    punya API, dan warning pustaka ltm dari salinan run_drc.
